Melihakbulut221/neuromorphic-space-soc/docs/51-npu-integration.md

# 51 — Connecting the NPU: the die has a serial port, so the SoC drives one

`docs/39-soc-bus-and-memory-map.md` section 9 item 4 is one line long:

> **No NPU connection.** The 256 MiB window is frozen and reaches the
> error slave.

Every document since has repeated it. Until this one the repository held
a RISC-V SoC and a separate neuromorphic accelerator that had never been
in the same simulation, and the word "neuromorphic" in its name was a
statement about two directories rather than about a part.

**This document is that connection, and it is built the hard way.**
`hw/rtl/pilot_top.v` — the TTIHP26b submission, frozen by blob hash in
`docs/34-pilot-freeze.md`, unmodified — is INSTANTIATED in `soc_top.v`
and reached over the same four serial pins the die will have. A program
on Ibex, out of the boot ROM, over the real fabric, configures it, loads
its weights, feeds it an event stream and reads the spikes back, and the
result is checked against `sw/golden/lif_core.py` rather than against
what the hardware produced. **27 checks, fail mask 0, 213,971 cycles.**

Convention, as elsewhere: **[fact]** = measured in this environment or
read out of a file; **[estimate]** = derived or judged; **[planned]** =
an intention with nothing behind it yet.

**The pilot is untouched.** `docs/34` pins the submission by blob hash
and the shuttle closes 2026-09-21. Nothing in `hw/rtl/`, `hw/tb/`,
`tt/`, `formal/` or `hw/openlane/` was modified; seven files in
`hw/rtl/` are **read and instantiated** and
`sw/tests/test_soc_npu_guards.py` fails if any of them has been touched.
Section 16 lists every file.

---

## 1. Verdict first

| Question | Answer |
|---|---|
| Is the 256 MiB window reached? | **Yes.** Fabric port 5, sixteen 4 KiB per-node register windows in its low 64 KiB, and everything else in it is a bus error that the program tests **[fact]**. Section 6 |
| Serial master, or a parallel port on a copy of the pilot? | **The serial master, and the argument is not "purity".** Section 3 |
| Is the frozen pilot instantiated or copied? | **Instantiated**, out of `hw/rtl/`. There is no copy anywhere under `hw/soc/` and a test says so **[fact]** |
| Does an inference run end to end? | **Yes, and it matches the golden model event for event and neuron for neuron.** 22 events in, 12 out, six spikes and six barrier echoes, all in stream order, plus the whole neuron state file **[fact]**. Section 7 |
| Where does the answer come from? | `sw/golden/lif_core.py`, at BUILD time, into a header the ROM image carries. The program never asks the hardware what the answer is. Section 7.1 |
| What does a register access cost? | **176 clock cycles**, measured, of which 171 is the serial frame **[fact]**. Section 8 |
| What does the whole program cost? | **185,443 → 213,971 cycles, +28,528, +15.4 %** — of which about **13,840 is console output** and the rest is the work **[fact for the counts, estimate for the split]**. Section 8.3 |
| What does the interrupt cost? | **Nothing that was spare.** `docs/40` assigned NPUCFG source 24 on fast line 12 before this block existed; lines 13 and 14 are still unassigned and a test derives that **[fact]**. Section 9 |
| Is it verified? | cocotb: **21 tests on `soc_npu` with the frozen pilot inside it, 21 pass**, with **14 mutations, of which four survived and one of those was a real gap** **[fact]**. Formal: **4 tasks on the transport, all PASS, 5 of 5 covers reached**, and **the fabric's own proof extended to six ports, 17 of 17 covers** **[fact]**. Section 10 |
| Is any of it hardened? | **The queues are, because they are `aer_fifo`. Nothing else is.** Section 14 |
| Is a descriptor ring built? | **No, and section 12 prices it rather than deferring it.** |

---

## 2. What was built

| File | What it is |
|---|---|
| `hw/soc/rtl/soc_npu_ser.v` | The serial host master. A transport and nothing else: one 40-bit mode-0 frame per register transaction, honouring the die's three host obligations by construction |
| `hw/soc/rtl/soc_npu.v` | The NPU subsystem. Two bus faces — the node register window on the system bus, the event port on the peripheral bus — an AER event engine between them, and the frozen `pilot_top` instantiated inside |
| `hw/soc/rtl/soc_npu_regs.vh` | Generated. The node register map for the SoC, from the same `regmap/regmap.yaml` that produces the die's own header |
| `hw/soc/rtl/soc_bus.v` | Extended from five slave ports to six |
| `hw/soc/formal/soc_bus_props.v` | The same extension, in the proof. Section 10.2 |
| `hw/soc/rtl/soc_top.v` | The subsystem, the sixth port, the NPUCFG slot decode, the interrupt line, and the die's pins brought out for observation |
| `hw/soc/flow/gen_npu_vectors.py` | The golden model's answer, computed at build time into two headers the program compiles against |
| `hw/soc/tb/sw/soc_npucfg.h` | The NPUCFG block's own register map, hand-written, as `soc_timers.h` is for the GPTIMER |
| `hw/soc/tb/sw/test_ibex.c` | Five new checks, 23 to 27 |
| `hw/soc/tb/sw/crt0.S` | A vector stub for interrupt id 28, fast line 12 |
| `hw/soc/tb/cocotb/test_soc_npu.py` | 21 tests, with the frozen pilot in the design under test |
| `hw/soc/formal/soc_npu_ser_props.v`, `.sby` | The serial protocol and its three host obligations, proved |
| `sw/tests/test_soc_npu_guards.py` | 15 textual guards, including that `hw/rtl/` is unmodified |

---

## 3. The connection decision, which is what this document is really about

### 3.1 The options, stated fairly

The pilot exposes exactly two interfaces. A **serial host port** —
`ser_sck`, `ser_cs_n`, `ser_mosi`, `ser_miso` — through which its whole
register bank is reached, and a **parallel 4-bit AER port** for events.
The host port is serial because it was designed against a Tiny Tapeout
pin budget. Inside an SoC there is no pin budget.

**(a) Drive the serial port from hardware.** A memory-mapped serial
master shifting frames into the frozen pilot exactly as external silicon
would. Preserves `pilot_top` bit-exactly. Costs latency and a shift
engine.

**(b) Add a parallel register port to a copy of the pilot under
`hw/soc/`.** Faster and cleaner, and the copy diverges from the design
being fabricated.

**(c) Something else.**

### 3.2 The usual argument for (a), and why it is not enough alone

The obvious case is: **the shuttle silicon will have the serial port and
nothing else.** If a TTIHP26b die arrives in 2027 and the SoC was built
against a parallel port that does not exist in it, the SoC cannot be
validated against the only real hardware this project will ever have.

**That argument is weaker than it first looks and it should be attacked
before it is used.** The SoC is not on the same die as the pilot and
never will be — the pilot is twelve Tiny Tapeout tiles, the SoC is a
different part on a different schedule. So "validate the SoC against the
die" cannot mean putting the die inside the SoC. It means running the
SoC's *driver* against the die over a bench harness, and a bench harness
needs a serial host of its own whether or not the SoC contains one. On
that reading, option (b) costs nothing: build the SoC against a parallel
port, and write a separate serial host for the bench.

**Three things defeat that reading, and only the third is decisive.**

**First, (b) needs a second copy of a frozen file, and this repository
has been bitten by second copies six times.** `docs/28` section 4.4a,
`docs/23`, `docs/34` section 8.5, `docs/36`, and `docs/38` sections 8.2
and 7.4 are all the same defect in different clothes: something was
checked, and the thing checked was not the thing that shipped. A copy of
`pilot_top.v` with a parallel port added would be verified, hardened and
measured, and every one of those results would be about a module that is
not the submission. The freeze exists precisely to make that impossible,
and `docs/34` section 9's rule is that changing a pinned file costs a
re-harden.

**Second, the parallel port is not a small change to that copy.** The
die's read side effects are timed to the serial frame: `pilot_top.v`
section 2 states that a read captures the addressed register when the
COMMAND BYTE completes, so `EVQ_OUT`'s pop happens once, early, at that
capture. A parallel port has no command byte and no frame, so the pop
would have to be re-timed — and `EVQ_OUT` is the register whose pop
semantics `docs/50` section 5.1 spends four pages on. Adding a parallel
port means re-deciding, and re-verifying, the part of the register bank
that is hardest to get right.

**Third, and this is the one that decides it: with (a) there is only
one host implementation, and it is the SoC's.** The bench harness for
the die is not a second thing to write — it is `soc_npu_ser.v` and the
driver above it, pointed at a socket instead of at an instance. The
three host obligations `pilot_top.v` numbers H1, H2 and H3 are
implemented once and proved once (section 10.2). With (b) they would be
implemented twice, and the copy that is *not* in the SoC is the copy
nobody runs a regression against — so it is the copy that would still
have the half-period-gap defect the pilot's own bring-up found.

> **THE DECIDING QUESTION IS NOT "CAN THE SoC TALK TO THE DIE". IT IS
> "HOW MANY IMPLEMENTATIONS OF THE DIE'S HOST PROTOCOL EXIST, AND WHICH
> OF THEM IS REGRESSED".** Option (a) answers one, and it is the one in
> the SoC's own test suite. That is a stronger reason than the shuttle
> argument, and it survives the attack the shuttle argument does not.

### 3.3 What was actually built is (c), and the difference matters

Option (a) as stated would be "a serial master, memory-mapped". What is
built is one level up from that:

> **THE SoC-SIDE INTERFACE IS THE MEMORY MAP, AND THE TRANSPORT IS
> UNDERNEATH IT.** `SOC_NPU_BASE + node*0x1000 + offset` behaves exactly
> like the `docs/10` section 10 register block, reached with ordinary
> loads and stores. Software does not know a serial port exists. A
> future node with a native 32-bit configuration bus — which is what
> `docs/10` section 1 specifies and what a full-scale node will have —
> is a change of transport under an unchanged address, an unchanged
> driver and an unchanged test suite.

The difference between (a) and (c) is one sentence in the RTL and the
whole of the software interface. It is the answer to the second question
this work had to decide, which is section 5.

### 3.4 What (a) costs, stated rather than waved at

**176 clock cycles per register access** **[fact, section 8]**. At the
pilot's scale that is a few dozen accesses per pass and it does not
matter. At full scale — 16,384 weight words, `docs/10` section 5 — it
would be 32,768 register writes and 5.8 million cycles, which is
absurd. **That is not an argument against the serial transport; it is an
argument the specification already makes.** `docs/10` section 9 puts
weight loading on a QSPI DMA path for exactly this reason, and section
14 item 4 lists it as the v0.2 work. The serial transport is the right
transport for configuration and the wrong one for bulk, and configuration
is what it carries.

---

## 4. The die's two ports are not symmetric, and the pin contract says so

The second question the brief posed is whether register access and event
flow are the same problem. They are not, and **the pilot's own pinout
already separates them** — `pilot_top.v` section 1 gives the event path
its own pins. So the SoC uses both, at the rate each was designed for.

What is worth recording is that the parallel port is **lossy in one
direction and impossible in the other**, and both facts come from the pin
contract rather than from anything in this work:

**Inbound, SYNC has no pin.** The event word the die builds from its
input pins is `{AER_IN_TICK ? 2'b01 : 2'b00, ...}`. Its TYPE field is 00
or 01 and never 10. **SYNC — the frame barrier that `docs/10` section
7.1 makes the determinism and multi-pass handshake primitive — cannot be
injected over the pins at all.** It goes over the serial `EVQ_IN`
register instead, at 176 cycles once per frame rather than per event.

**Outbound, there is no TYPE.** `AER_OUT_ID` is four bits and
`pilot_top.v` section 1 says what they are: "the low four bits of its ID
field". **A SYNC echo and a spike from neuron 0 are the same four bits.**
Reading the output pins would silently conflate the barrier with a
spike, which is the one event in the stream whose identity the sequencer
depends on. So `AER_OUT_VLD` is used as a NOTIFICATION and the word is
read from the die's `EVQ_OUT` register, which the same section says "is
always available over the serial EVQ_OUT register".

`aer_out_ack` is therefore **tied low and never used**: the serial read
is itself the pop, and two pop paths into the die's one-entry show-ahead
register would be two ways to lose the same event.

> **THE CONSEQUENCE IS AN ASYMMETRY OF ABOUT 44x AND IT IS THE TILE'S
> PIN BUDGET SHOWING THROUGH, NOT A DESIGN CHOICE.** An inbound SPIKE or
> TICK costs **4 clock cycles** on the pins; an outbound event costs a
> **176-cycle** frame **[fact]**. A full-scale node's mesh link
> (`docs/10` section 8 item 2, a 24-bit word with valid/ready) is
> symmetric and has neither problem, which is why the SoC-side event
> interface below is shaped like the mesh link and not like these pins.

---

## 5. Is this connecting to the pilot, or designing for a full-scale NPU?

**The second, and the frozen map's own author is the evidence.**
`regmap/memmap.yaml` reserves **256 MiB** at `0x10000000` and describes
it as "per-node register windows and descriptor rings", and separately
reserves a 4 KiB peripheral slot called NPUCFG for "NPU fabric-level
global configuration and status". A single pilot needs neither: one
4 KiB page would hold its whole register bank. Somebody who intended a
mesh wrote that map, and `docs/08` section 3.1 is where they wrote it.

So the CPU-side interface is designed for the mesh and the pilot is its
first and smallest instance:

| What the SoC presents | Why it is that shape | The pilot's part in it |
|---|---|---|
| One 4 KiB register window per node at `NODE_ID * 0x1000`, sixteen of them | `docs/10` section 8 item 5 freezes "one identical regmap instance per node at a per-node base address"; item 2 makes NODE_ID four bits | One node at index 0; the other fifteen are decoded and fault |
| A 16-bit event stream in each direction, valid/ready, `docs/10` section 7.1 words | Item 1 freezes the event word and item 3 freezes the handshake. This is the mesh link minus its 8-bit routing prefix, which item 2 says is tied off in single-node builds | Carried by a hybrid of the die's pins and its serial port, section 4 |
| One interrupt with a cause register | A cause register scales to sixteen nodes on one wire; a wire per node does not | Five of the seven cause bits come off the die's fault pins |
| The rest of the 256 MiB reserved and faulting | Descriptor rings live there and are not built, section 12 | — |

**What this costs.** The window decodes sixteen node slots when one
exists, which is four comparator bits that do nothing today, and the
event port carries a 16-bit word where four would do. Both are
unmeasurable next to the queues (section 11). **What it buys** is that
the second node is a parameter and a wiring change rather than a
redesign of the software interface — which is the whole content of
`docs/02` section 4 point 2's "one node of a mesh from day one".

---

## 6. The memory map, and what "reserved" now means inside it

Nothing in `regmap/memmap.yaml` moved. Two fields changed: the NPU
region gained `port: npu` and both it and the NPUCFG slot were promoted
from `reserved` to `implemented` **[fact, the diff]**.

```
0x10000000 + node*0x1000 + offset    node `node`'s docs/10 section 10
                                     register block, offsets 0x000..0x1FC
0x10000000 .. 0x1000FFFF             sixteen such windows; nodes at or
                                     above N_NODES are a bus error
0x10010000 .. 0x1FFFFFFF             reserved. Descriptor rings would
                                     live here. Bus error.
0xFF919000                           NPUCFG, the fabric controller and
                                     the event port
```

Three decode rules, and each of them faults rather than aliasing:

- `addr[27:16] != 0` — above the node windows, including the whole
  descriptor-ring area;
- `node >= N_NODES` — a node that is not instantiated;
- `addr[11:9] != 0` — above `0x1FC`, which is where the die's own
  seven-bit register address runs out;
- **a sub-word write.** The serial frame is 32 bits and carries no byte
  enable. A slave that accepted a byte store would have to widen it,
  writing three bytes of a register the master never named. It faults,
  and check 25 of the bring-up program requires `mcause = 7` for it.

**Check 25 tests all five**, and the cocotb suite tests seven addresses
plus four byte-enable patterns plus three misalignments **[fact]**. A
window that decoded everything to node 0 would pass every other NPU
check in this repository and fail that one.

---

## 7. The demonstration

### 7.1 The answer is computed before the hardware is asked

`hw/soc/flow/gen_npu_vectors.py` runs on **every** build of the ROM
image, before the compiler. It builds the weight matrix, runs
`sw/golden/lif_core.py` — which `docs/10` section 13 makes the normative
executable form of the section 4 equations — over the stimulus, and
emits two headers:

- `npu_regs.h`, the node register map in C, from `regmap/regmap.yaml`,
  so no offset of that map is written by hand anywhere in the program;
- `npu_vectors.h`, the stimulus and **the expected output stream**.

The program compares against those constants. **It never asks the
hardware what the answer is**, which is the difference between a check
and a tautology.

The configuration and the stimulus are `hw/tb/test_pilot_top.py`'s,
deliberately unchanged — same `LIFConfig`, same frames, same weight seed
— so the SoC's run and the pilot's own run are the same inference on the
same numbers, and a disagreement between them is attributable.

### 7.2 What the program does

```
  ok   test 0x00000017      NPUCFG answers; its reserved offsets fault
  ok   test 0x00000018      the node window IS docs/10 section 10
  ok   test 0x00000019      reserved addresses in the window are faults
npu: 0x0000000c events, cnt=0x000c0016 status=0x0000002a
  ok   test 0x0000001a      the inference, against sw/golden
  ok   test 0x0000001b      the interrupt, on the map's own fast line
checks run: 0x0000001b  fail mask: 0x00000000
RESULT PASS
[TB] core asleep after 213971 cycles
[TB] console: 760 characters decoded, 0 framing errors
```

**[fact, `hw/soc/out/sim-soc/sim.log`]**

Check 26 is the one the block exists for. In order: state clear and wait
for BUSY to drop; write eight configuration registers and **read one
back**, because a configuration write that was refused is otherwise
invisible until the arithmetic comes out wrong and then it looks like an
arithmetic defect; load four ECC-checked weight words through
`W_DATA_LO`/`W_DATA_HI`; check `CNT_SEC` and `CNT_DED` are zero, because
a clean image must not produce an ECC event; enable. Then six frames,
each injected as its spikes, a TICK and a SYNC, and read back until that
frame's barrier returns.

**What is in the loop:** Ibex, the boot ROM, the system fabric, the APB
bridge, the peripheral slot decode, the serial transport, the frozen
die's register bank, its ECC-checked weight loader, its LIF datapath,
its event queues, the parallel AER pins inbound and the serial `EVQ_OUT`
register outbound, and the SoC's own two queues.

**What is checked:** the output stream, event for event and in stream
order — six spikes and six barrier echoes, twelve words; then **the
whole neuron state file**, `V` and `R` for all eight neurons, which is
strictly stronger than the spike stream because it catches an error that
happened to cancel; then that nothing was lost — the die's
`CNT_EVQ_OVF` and `CNT_AXON_OOR`, the SoC's injection-drop counter, and
the interrupt cause's fault bits, all zero; and finally that the
hardware's OWN count of events delivered and drained (22 and 12) agrees
with the stream the program collected, which is a second path to the
same conclusion.

### 7.3 The barrier is what makes the stream self-delimiting

The read loop has **no timing knowledge at all**. It reads until the
SYNC it injected comes back, and `docs/10` section 7.1 is why that is
legitimate: a consumed SYNC means every prior event is fully processed
and the barrier is echoed downstream. The die echoes the consumed word,
so the barrier carries its own frame number and the program can label
frames without counting spikes.

> **THIS IS THE RETURN ON PAYING 176 CYCLES TO INJECT A SYNC OVER THE
> SERIAL PORT.** The pins cannot carry the barrier in either direction
> (section 4). Without it the program would have to know how many spikes
> each frame produces — which is the answer it is trying to check — or
> wait a fixed time, which is a test that passes for the wrong reason on
> a slow day.

---

## 8. What it costs, measured

### 8.1 One register access

**176 clock cycles**, from the cycle `req` is asserted to the cycle
`rvalid` returns **[fact, `hw/soc/tb/cocotb/test_soc_npu.py::test_the_frame_costs_what_the_protocol_says_it_costs`,
and independently in a standalone Icarus run]**. Of that, **171** is the
serial frame itself and the rest is the slave's own sequencing.

The protocol's floor is arithmetic on `pilot_top.v` section 2: 40 SCK
cycles plus one period of select setup (H2) plus one of inter-frame gap
(H3), at `SER_HALF` clock cycles per half period, is
`(40 + 1 + 1) * 2 * 2 = 168` cycles. The test asserts the measurement
lies between that floor and the floor plus 24, so the number in this
document is an observation and not a design intent.

### 8.2 The grant discipline, and the fabric consequence nobody had met

The node window **accepts one request at a time and withholds `gnt`
otherwise**, which is `soc_bus.v` rule S4 and is exactly what
`soc_apb_bridge.v` already does. The difference is the duration: three
cycles there, 176 here.

> **AND THAT MAKES A PROPERTY OF THE FABRIC VISIBLE FOR THE FIRST TIME.**
> `soc_bus.v`'s round-robin arbiter picks a winner BEFORE it looks at the
> target's grant. Its no-starvation property F9 has "every slave ready"
> in its antecedent for exactly this reason — `docs/39` section 8 defect
> 3 records the counterexample that put it there. So while one master is
> being refused by a slow slave, **the other master is not granted
> either.**

In this SoC that costs nothing measurable, and the reason is a property
of the CORE rather than of this block: Ibex is a two-stage machine with
no cache, so **a load stalls the pipeline until its data returns**
(`docs/50` section 5.2 measures 0.9714 cycles of execution per cycle of
RAM latency), and no second request to this window is ever issued while
the first is in flight. `md_req_i` is low for the whole frame and the
instruction port fetches normally.

**"Cannot happen because of the master we happen to have" is not a
property of a slave** — that is `docs/39` section 8 defect 4 in one line
— so it is reported here as a measurement of this SoC and not as a
property of the fabric. A future master that pipelines accesses into
this window would pay it, and the fix would be to buffer up to
`2*MAX_OUT` requests in the slave rather than to change the arbiter.

### 8.3 The whole program

| `hw/soc/flow/sim_soc.sh`, whole SoC | `docs/50` baseline | with the NPU |
|---|---:|---:|
| checks run | 0x16 (22) | **0x1B (27)** |
| fail mask | 0 | **0** |
| watchdog stage 1 (NMI) at cycle | 174,128 | **174,208** |
| **core asleep after** | **185,443** | **213,971** |
| console characters decoded | 587 | **760** |
| framing errors | 0 | **0** |
| watchdog stage1 / stage2 / stage3 | 1 / 0 / 0 | **1 / 0 / 0** |

**[fact, `hw/soc/out/sim-soc/sim.log`]**

**+28,528 cycles, +15.38 %.** Two things are worth separating out of
that number.

**THE BLOCK IS FREE UNTIL SOFTWARE TOUCHES IT, AND THAT WAS MEASURED
BEFORE THE CHECKS WERE WRITTEN.** With `soc_npu` instantiated, the sixth
fabric port decoded and the interrupt wired, and with the program
unchanged, the run was **185,443 cycles — identical to `docs/50`'s, to
the cycle** **[fact]**. The interrupt mask resets to zero and both event
engines reset disabled, so nothing the block does is visible until a
register is written. That is the same discipline `docs/41` records for
BUSSTAT and the reason `soc_top.v` could grow a block without moving the
invariant.

**ABOUT HALF THE DELTA IS THE CONSOLE.** The program prints 173 more
characters and `soc_uart.v` has one holding register, so at 80 clocks
per character that is **13,840 cycles [estimate, a measured character
count times a measured bit period]**, leaving about **14,700** for the
work: roughly 50 node-window accesses at 176, 18 engine frames at 172,
16 pin events at 4, and the CPU's polling in between.

**The new invariant is 213,971** and every hardening document after this
one should use it. The `docs/38` minimal-system run is unchanged at
131,718 cycles **[fact]**, because nothing in this work is on that
platform.

---

## 9. The interrupt, and what one fast line actually cost

`docs/40` section 3.3 decided against a PLIC on the strength of headroom:
Ibex's fifteen fast local interrupts cover thirteen sources with two
spare. Spending one here would be a real decision against that budget.

**It does not spend one.** NPUCFG was one of the thirteen sources that
document assigned — source number 24, fast line 12, `mcause 0x8000001C`,
vector `mtvec+0x70` — before this block existed. This work moves that
slot from `reserved` to `implemented`. **Lines 13 and 14 are still
unassigned**, and `test_soc_npu_guards.py` derives the spare set from the
generated map rather than asserting it **[fact]**.

**One line is enough for any number of nodes**, because the cause
register and not the wire says what happened:

| Bit | Meaning | Kind |
|---|---|---|
| 0 EVT | the capture queue is not empty | **level** |
| 1 ERR | the die's ERR pin | **level** |
| 2 SEC | the die's SEC pin, sticky at the die | **level** |
| 3 DED | the die's DED pin, sticky at the die | **level** |
| 4 TMR | the die's TMR pin, sticky at the die | **level** |
| 5 INJ_OVF | an `EVQ_IN` write was refused by a full queue | **sticky, W1C** |
| 6 FETCH_ER | an injection-queue fetch expired | **sticky, W1C** |

**The mix of levels and stickies is a decision and not untidiness, and
`docs/50` section 5.1 is the precedent.** A level has state behind it,
so the way to clear it is to fix the state — drain the queue, write the
die's `FAULT_CLR`. A refused write has no state behind it: it is an
event, and an event that is not latched is an event nobody can observe.
Writing 1 to a level bit is accepted and does nothing, and
`test_evt_is_a_level_and_says_so` asserts exactly that, because the
opposite convention is the easy mistake and it produces a driver that
loses events.

**Five of the seven bits come off the die's pins**, not off a polled
register. `pilot_top.v` section 1's four fault pins exist so "every
hardening event is visible on a scope with no host software"; inside an
SoC they are visible with no 176-cycle frame either. That is the
`docs/08` section 2.3 fault-visibility convention paying for itself in a
place it was not designed for.

**Check 27 takes the interrupt**, on line 12, at its own vector, and
checks the marker and `mcause` separately — `docs/40` section 6.1's rule
that reading `mcause` alone proves nothing about vectoring. It then
checks that the event is still in the queue, because the handler masked
the line rather than consuming anything, and that draining the queue
clears the level. That last assertion is the whole claim about what kind
of bit EVT is.

---

## 10. Verification

### 10.1 cocotb

| Suite | Tests | Result |
|---|---:|---|
| `test_soc_npu` | **21** | **21 pass** **[fact]** |

**The device under test contains the frozen pilot.** Every register value
in that suite travels a real 40-bit serial frame into `hw/rtl/pilot_top.v`
and back, and every event travels either the parallel AER pins or that
same frame. It is not a model of the die.

No expectation is read out of `soc_npu.v` except the port names. Node
register offsets, reset values and field positions come from
`sw/golden/regmap_gen.py`; the region base comes from
`sw/golden/memmap_gen.py`; the slave contract is `soc_bus.v`'s S1-S4,
quoted in the docstrings that test it; the frame format and the host
obligations are `pilot_top.v` section 2; and the inference answer is
`sw/golden/lif_core.py`.

`test_every_reset_value_survives_the_transport` walks the whole map — 26
registers — because a frame that was one bit short, one bit long, sampled
on the wrong edge, or misaligned by a deselect the die never saw would
corrupt SOME of them and not others. Two registers are excluded and the
reasons are normative rather than convenient: `CFG_NEUR` and `CFG_AXON`
report the elaborated geometry under `pilot_top.v` deviation D2, and
`N_DATA` has no reset value at all because `docs/10` section 3 says the
neuron state memory is UNDEFINED after reset.

**Mutation evidence, and four of the fourteen were not caught.**
Fourteen mutations against scratch copies; the Makefile exposes
`SOC_NPU_SRC` and `SOC_NPU_SER_SRC` for exactly this.

| Mutation | Result |
|---|---|
| `SER_MISO` sampled at the first cycle of the high half | caught, 8 tests |
| the frame is 39 bits | caught, 10 tests |
| a sub-word write is widened instead of refused | caught, `test_a_partial_write_is_refused` |
| every node index decodes to node 0 | caught, `test_reserved_addresses_in_the_window_are_bus_errors` |
| offsets above the die's 7-bit map are accepted | caught, the same test |
| a SYNC is strobed onto the AER pins | caught, 6 tests |
| a refused `EVQ_IN` write is not recorded | caught, 2 tests |
| the interrupt ignores the mask | caught, `test_the_line_is_the_cause_and_the_mask` |
| EVT is a sticky rather than a level | caught, 2 tests |
| `CTRL.FLUSH` also clears the sticky record | caught, `test_flush_empties_the_queues_and_keeps_the_record` |
| **the window grants while a frame is in flight** | **NOT caught — a real gap, now closed. Section 10.1a** |
| **the inter-frame gap H3 is dropped** | **not caught by the suite; caught by the induction proof** |
| **the select setup H2 is shortened** | **not caught by anything, and it is not a violation** |
| **a drained word is captured without checking VALID** | **not caught; the condition is unreachable in this SoC** |

**[fact, section 17 reproduces it]**

#### 10.1a The gap, which is the most useful result in this section

`gnt_o = req_i` — a window that grants a second request while the first
is unanswered — **passed all 21 tests.** A grant the fabric records owes
an `rvalid` the slave never sends, which underflows `soc_bus.v`'s
per-slave ownership queue; it is one of the worse things a slave can do.

The reason it survived is a defect in the test, not in the suite's
coverage: `test_gnt_is_withheld_while_a_frame_is_in_flight` **dropped
the request as soon as it saw the grant**, so it never presented the
slave with the opportunity to misbehave.

Rewriting it took two attempts, and the second one is the interesting
part. Holding the request high and requiring **one grant** fails on the
CORRECT design, because a grant and an `rvalid` may legitimately
coincide — they belong to different transactions, and
`soc_apb_bridge.v`'s header already says so of itself. **The property is
an OUTSTANDING COUNT and not a grant count**: grants minus responses
must never exceed one. Stated that way it passes on the design and
reports **523 outstanding** on the mutation.

> **A TEST THAT NAMES THE PROPERTY IT CHECKS AND DOES NOT SET IT UP IS
> WORSE THAN NO TEST**, because the name is read as coverage. This is the
> twelfth entry for `docs/41` section 6.6's list and the first in this
> work.

#### 10.1b The three that were not gaps

**H3 is caught by the proof and not by the simulation, and the depths
say why.** The bounded check runs to depth 30 and one frame is 171
cycles, so **no bounded check that finishes in reasonable time reaches a
second frame** — and H3 is entirely about the gap between two. The
k-induction proof has no such limit and fails on the mutation at the
`g_h3` clause. That is the division of labour the two tools are for, and
it is worth recording that the simulation could not have found it: with
`SER_HALF = 2` the shortened gap still leaves three cycles of deselect,
and the die needs one.

**The H2 mutation is not a violation.** Shortening the SETUP state from
two half periods to one still leaves five cycles between the select
falling and the first sampled clock edge, because **the first bit's own
low half supplies the rest of the setup**. The obligation `pilot_top.v`
section 2 states is about the interval, not about a state, and the
property is written over the interval — so both designs meet it and
neither tool should flag it. A mutation that changes no observable
behaviour is a statement about the design, and it is recorded rather
than quietly dropped.

**The VALID check on a drained word guards a condition this SoC cannot
produce.** The drain engine only starts when `AER_OUT_VLD` is high, and
nothing in this SoC pops the die's holding register behind its back —
`aer_out_ack` is tied low. The check is there because
`regmap/regmap.yaml`'s `EVQ_OUT` contract permits a read with VALID
clear, and the module's comment says so. **It is unreachable, so it is
uncovered, and calling that a coverage hole would be wrong** — it would
be a hole if `aer_out_ack` were ever connected.
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
