Melihakbulut221/neuromorphic-space-soc/thesis/figures/floorplan_macros.png

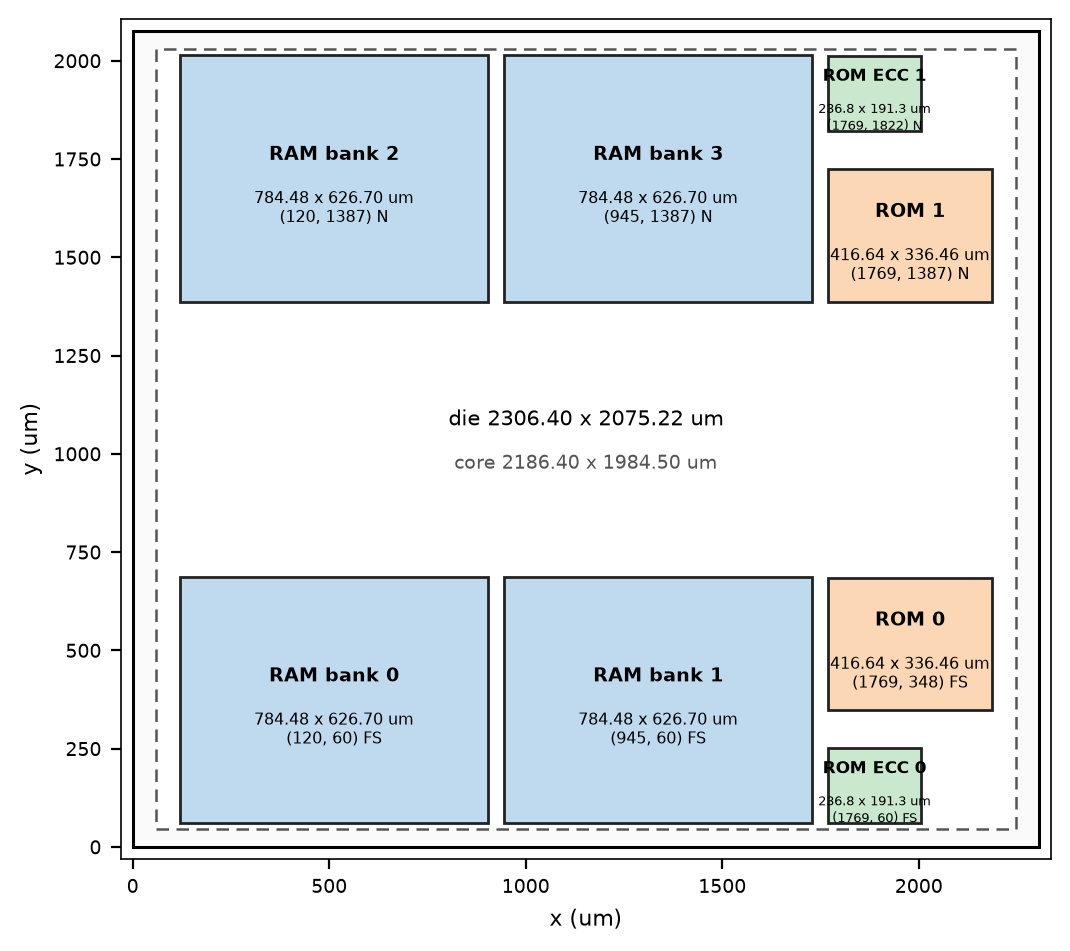
thesis/figures/floorplan_macros.png
