Melihakbulut221/neuromorphic-space-soc/thesis/figures/layout_blocks.png

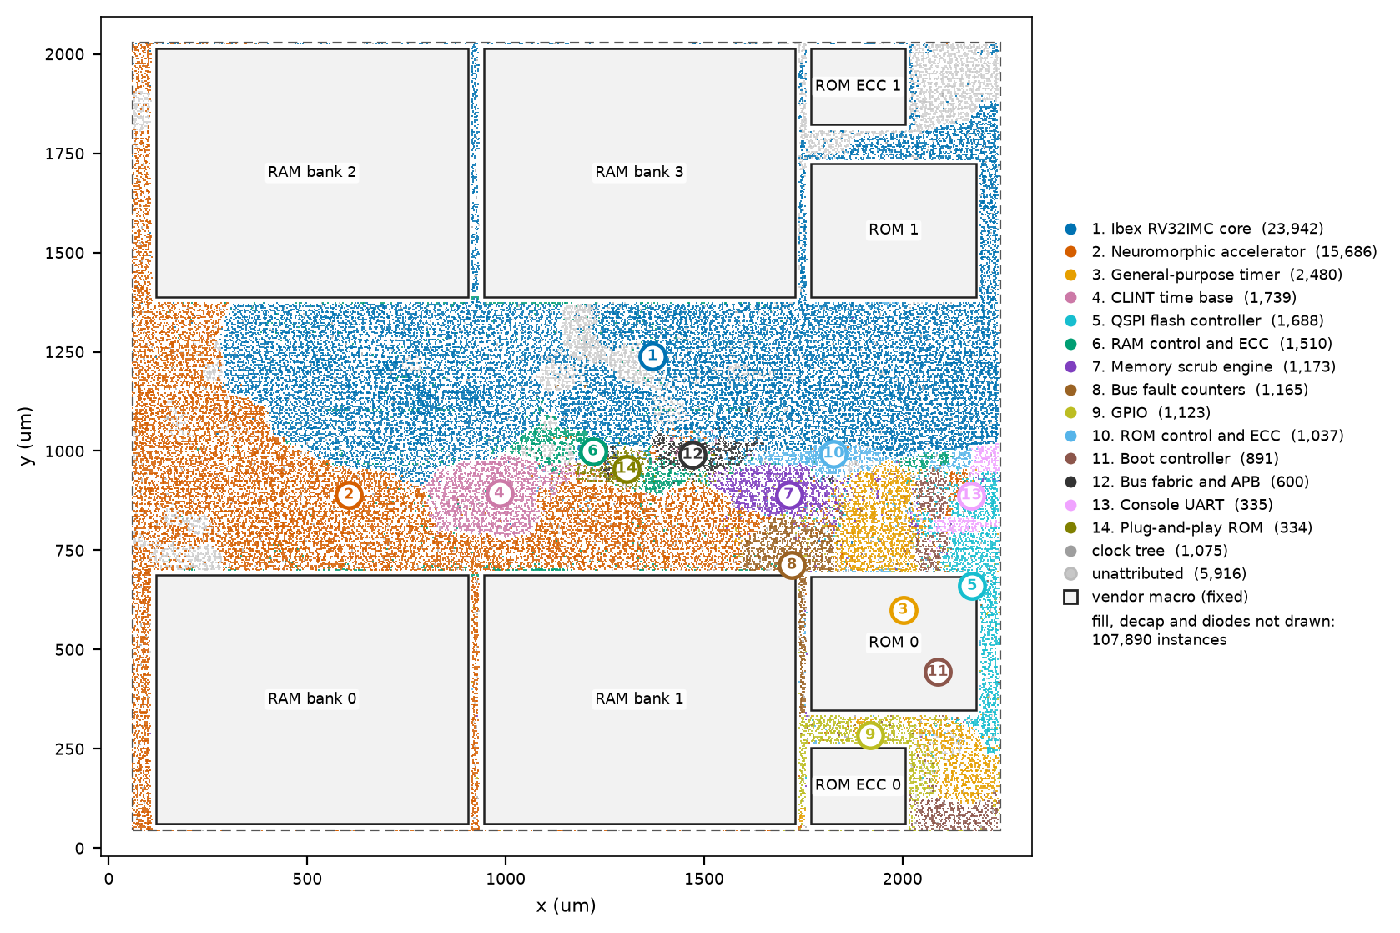
thesis/figures/layout_blocks.png
