Melihakbulut221/neuromorphic-space-soc/thesis/figures/layout_density.png

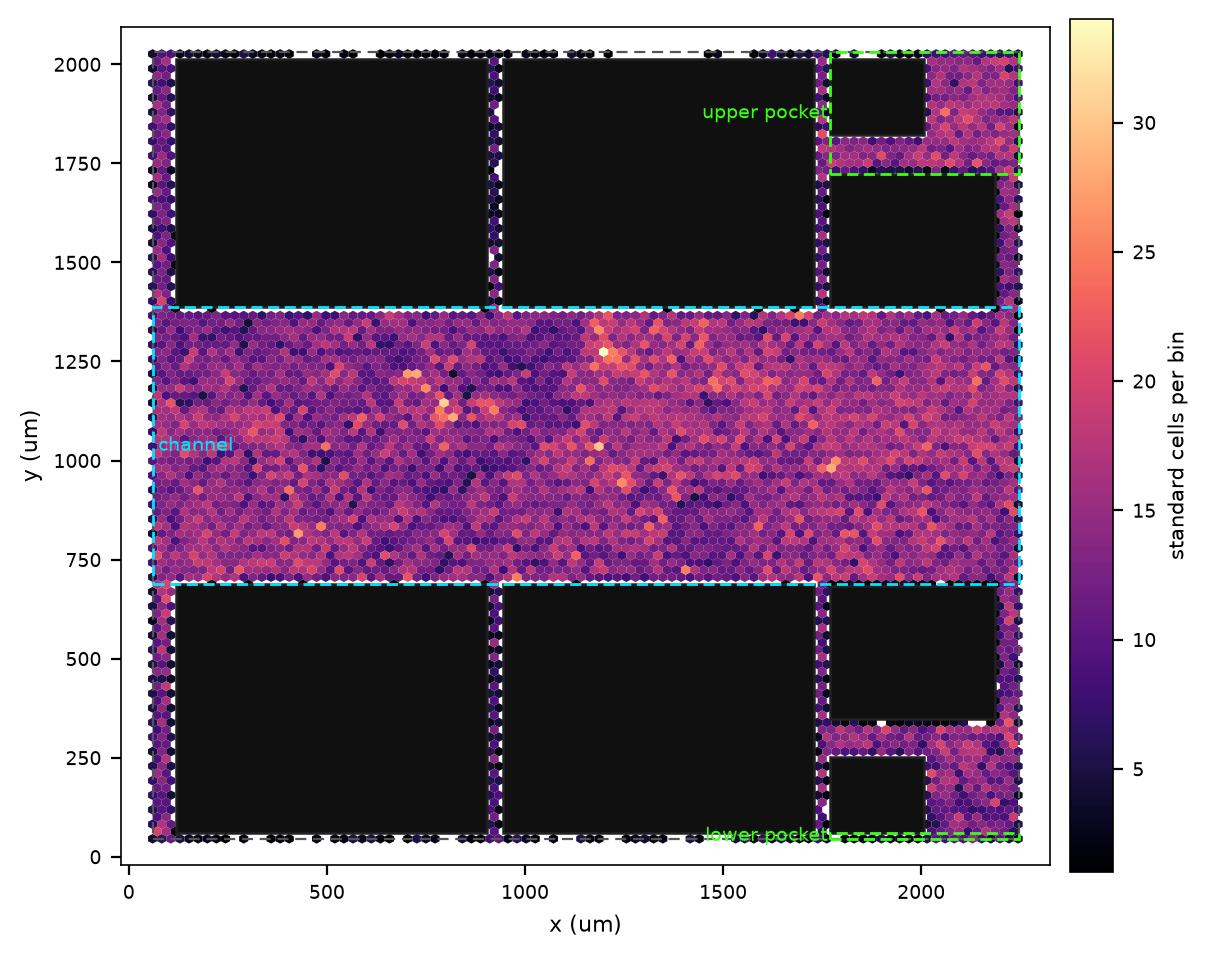
thesis/figures/layout_density.png
