Melihakbulut221/neuromorphic-space-soc/thesis/figures/layout_ibex_npu.png

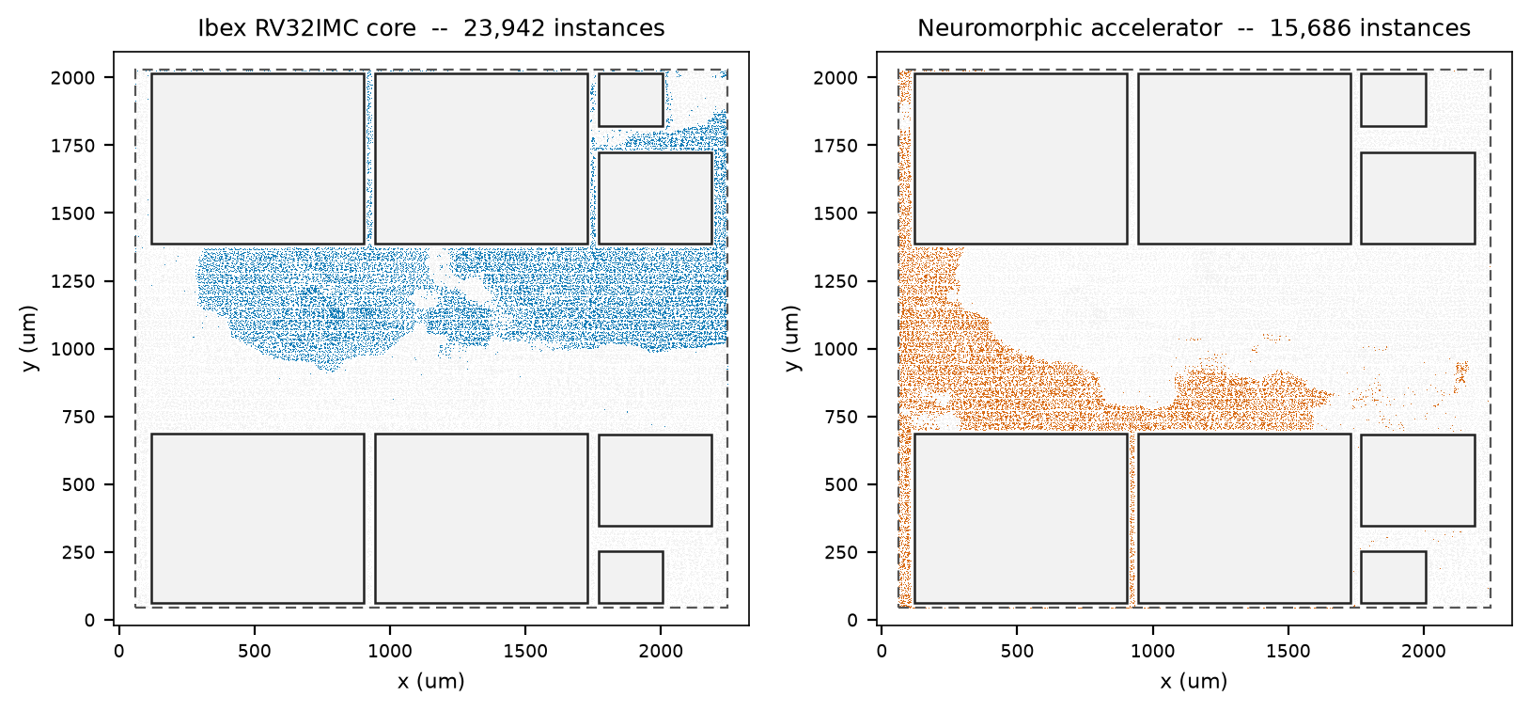
thesis/figures/layout_ibex_npu.png
