Melihakbulut221/neuromorphic-space-soc/thesis/figures/layout_panels.png

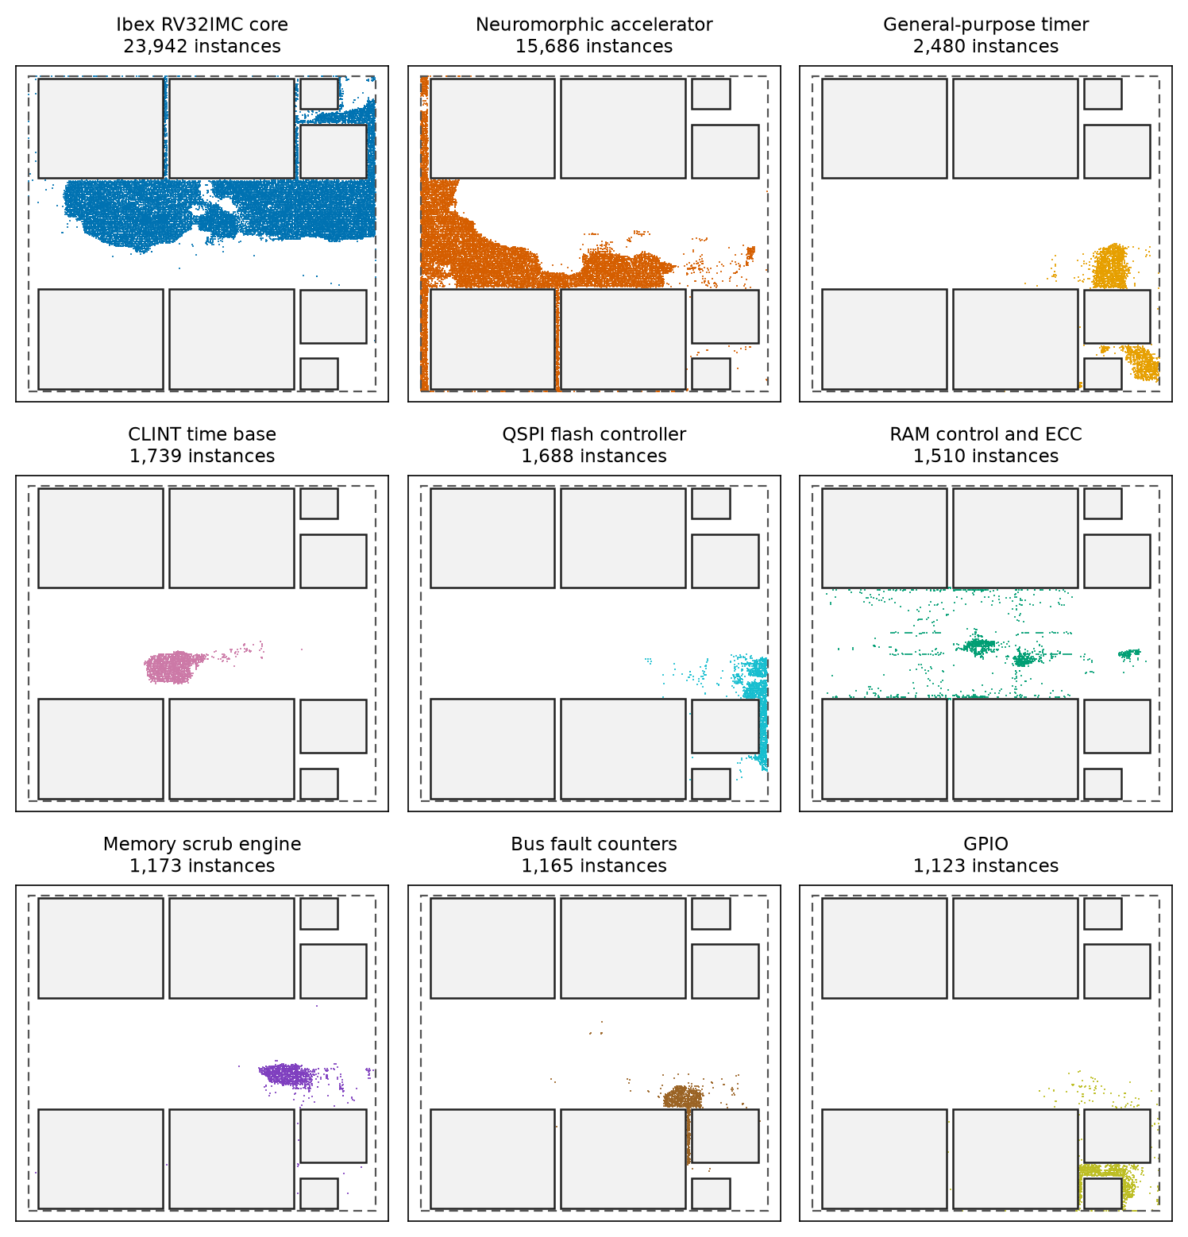
thesis/figures/layout_panels.png
