Melihakbulut221/neuromorphic-space-soc/thesis/figures/layout_regions.png

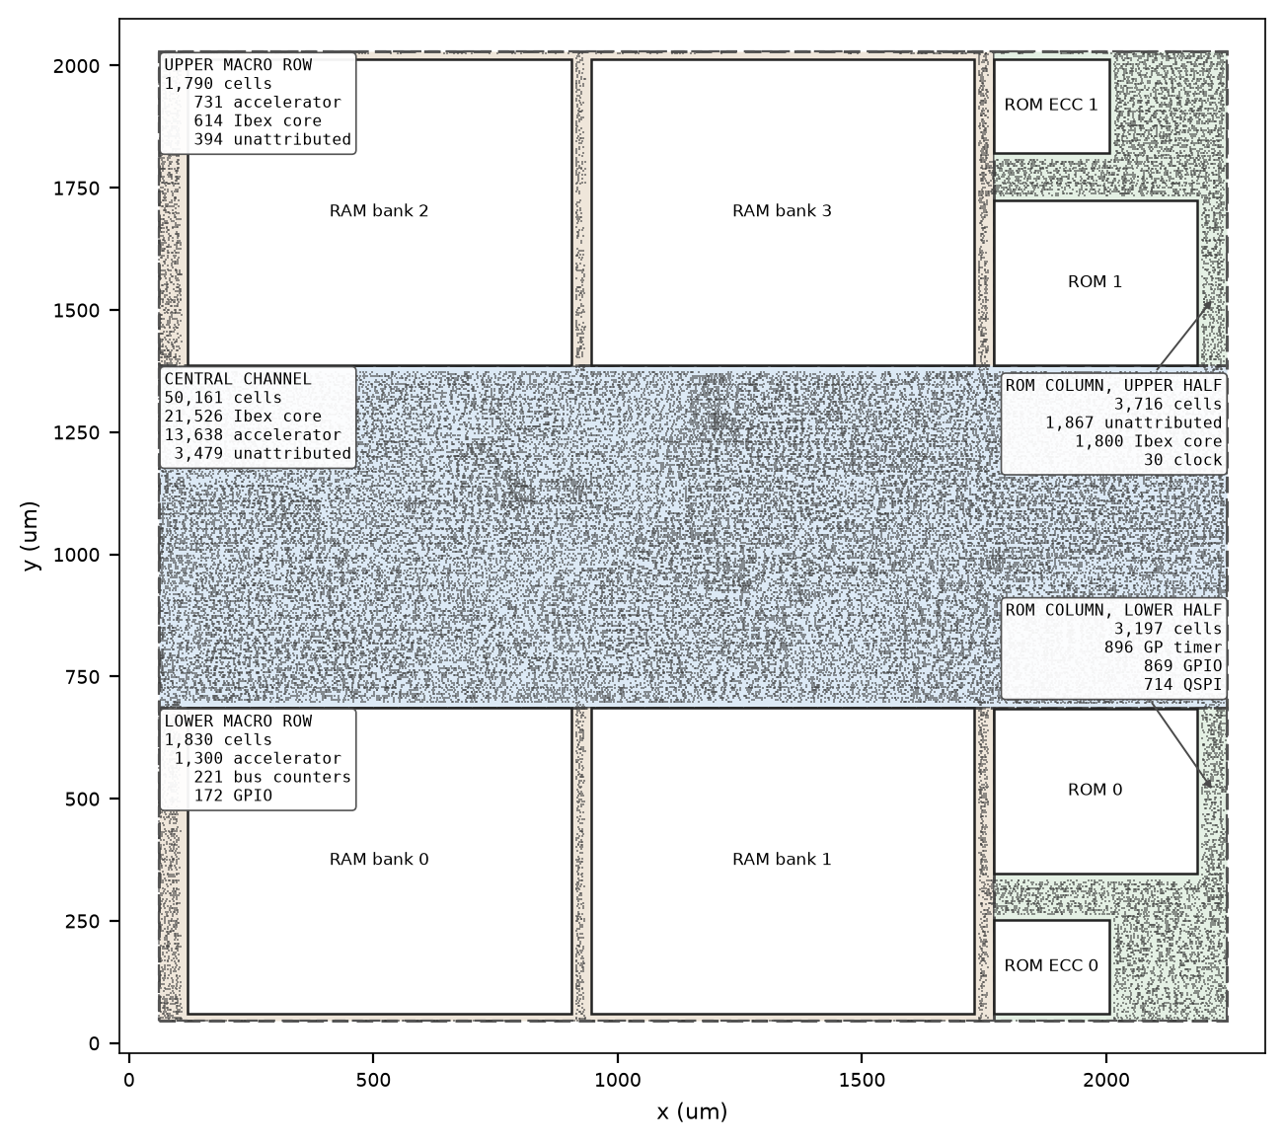
thesis/figures/layout_regions.png
