Melihakbulut221/neuromorphic-space-soc/docs/12-sg13g2-flow-bringup.md

# SG13G2 flow bring-up, `aer_fifo` trial harden, and the RM_IHPSG13 decision

Evidence file for ROADMAP gate **G0** ("sg13g2 trial harden DRC/LVS clean")
and for the **2026-09-07** internal go/no-go on the RM_IHPSG13 SRAM macro
(ROADMAP work item 2, budgeted in docs/06 section B.6.1). It answers three
questions:

1. Does an IHP SG13G2 RTL-to-GDS flow run to signoff in this rootless
   environment, and against which pinned tool and PDK versions?
2. What does a real block (`hw/rtl/aer_fifo.v`) cost on SG13G2, and does
   it close DRC, LVS and antenna?
3. Can an RM_IHPSG13 SRAM macro be hardened in the same flow, inside the
   Tiny Tapeout block geometry the pilot would use?

Convention used throughout: **[fact]** = measured in this environment or
read out of the installed PDK; **[estimate]** = derived or judged.
Sections 2-7 are measured unless a paragraph is marked otherwise.

**Headline, 2026-08-25.**

- **G0 is met.** `aer_fifo` hardened end to end on SG13G2: Magic DRC 0,
  KLayout DRC 0, Netgen LVS 0 errors on every count, XOR 0, antenna 0,
  timing clean on all three corners. Run `g0gates2`, 80 stages, 11.6
  minutes of tool time, on the RTL as it stands, with **17 of 19
  in-flow checkers gating fully** and setup, hold, max-slew and max-cap
  each measured at three corners and 0 at all of them. Section 4.
  **[fact, 2026-09-11]**
  - *The headline dated 2026-08-25 named run `trial-03-signoff` and 11.3
    minutes. That run stands as measured and is section 4.7a. It
    hardened the block BEFORE the queue pointers were replicated, and
    three of its four corner checkers were bound to no corner or to one
    of three -- so it is a true measurement of a design this repository
    no longer contains, made by a flow that would not have stopped had
    the numbers been bad. Section 4's preamble says how both were
    found.*
- **The RM_IHPSG13 macro run was made, and it splits cleanly in two.**
  One `RM_IHPSG13_1P_512x32_c2_bm_bist` in a registered wrapper, placed
  inside an 854.40 x 340.20 um die — the *interpolated* 4x2 Tiny Tapeout
  block this document used to print; the measured 4x2 block is
  854.40 x 313.74 um and 8.4 % smaller (6.5):
  - **Physical implementation passes.** Detailed routing into the
    macro's 188 bottom-edge Metal2 pins closed with 0 DRC errors and 0
    antenna violations, and timing closed at 50 MHz with 13.07 ns
    slow-corner slack. The pin-access failure this document previously
    predicted as most likely did not happen. Two flow-side integration
    defects did and both were worked around in
    `hw/openlane/sram_pilot/`: LibreLane's default macro PDN grid never
    reaches the macro's Metal4 supply pins, and Magic GDS streamout
    aborts because the macro GDS carries no prBoundary layer.
    Sections 7.2-7.4. **[fact]**
  - **Signoff fails.** Magic DRC **1,106,478 error boxes** (the report
    prints "Should be divided by 3 or 4" beneath that total, so roughly
    277,000-369,000 distinct violations **[estimate]**) and KLayout DRC
    **2,316** errors, **100 % of both inside the macro** and none in the
    surrounding design; Netgen LVS **359** errors, driven by the
    CDL-versus-GDS hierarchy naming and by a bus-delimiter mismatch
    (`A_DIN[16]` extracted versus `A_DIN<16>` in the CDL). Section 7.5.
    **[fact]**
- **Recommendation: NO-GO on RM_IHPSG13 for TTIHP26b, decidable now
  rather than on 2026-09-07.** The gate as docs/06 B.6.1 worded it is
  already answered, under conditions easier than it asks for, and both
  blocking causes are upstream of this repository. Separately, the macro
  named for that gate in docs/06 B.6 did not fit the block it was gated
  against; docs/06 has since been corrected on both counts. Sections 8
  and 10.1.

Run trees under `hw/openlane/*/runs/` are **gitignored** and do not
travel with the repository. Every number below is therefore quoted here
in full, with the run tag and step directory it came from, so this file
remains the evidence after the trees are deleted.

---

## 1. Scope

Design under test for the bring-up: `hw/rtl/aer_fifo.v` at `WIDTH=16`,
`DEPTH=64` — the EVQ geometry of docs/10 section 7.1. It was picked as
the bring-up vehicle because it is small enough to iterate on, it is
already verified (11 cocotb tests, four SymbiYosys proofs), and it is
memory-shaped: a 1024-bit storage array in flip-flops is exactly the
thing the SRAM-macro decision is about.

Design under test for the macro decision: `hw/openlane/sram_pilot/`, one
`RM_IHPSG13_1P_512x32_c2_bm_bist` in a registered wrapper and nothing
else, on the interpolated 4x2 die (6.5). It is flow-experiment scaffolding, deliberately kept out of
`hw/rtl/`; it is not part of any pilot submission.

Non-goals: this is not a timing exploration and not a Tiny Tapeout tile
submission. No ECC wrapper is built around the macro here — the decision
this document has to inform is whether the macro closes at all, and that
question is answered without one.

Everything this work *produced* lives in `hw/openlane/`, but the claim
an earlier revision made here — "nothing outside that directory and this
file was modified" — was not true, and the exceptions are load-bearing
rather than incidental:

- **`.gitignore`** gained `hw/openlane/runs/` and `hw/openlane/*/runs/`.
  Section 9's statement that run trees are gitignored is a statement
  about that file, not about this one; without the entry, a 1.6 GB tree
  of build output would be staged on the next `git add`.
- **`ROADMAP.md`** gate G0 carried a status note saying "no retained run
  has yet reached a DRC result and LVS has not executed". Section 4.1
  retired it; the integrator has since replaced it with the
  `trial-03-signoff` result and a pointer to this file. That change was
  requested in section 10.1 and has been made.
- **`docs/06-funding-and-shuttle.md`** sections B.6 and B.6.1 were
  rewritten in response to the errata this document raises in 6.5 and
  10.1 — the `1024x8` macro that does not fit, and the tile count.

Both `.gitignore` and `ROADMAP.md` are integrator-owned, so those two
edits were requested here and made there rather than made from this
workstream. The general rule this replaces the old sentence with: this
document owns `hw/openlane/` and itself, and every change it needs
elsewhere is named — here, in 10.1, or in both.

---

## 2. Toolchain

### 2.1 Rootless chain

No root, no container, no system package installation. Binaries are
user-local builds or extracted release tarballs; each is fronted by a
one-line shim in `~/.local/opt/llbin` that sets the environment that
binary — and only that binary — needs. The shims exist because the
OpenROAD build ships its own newer glibc: exporting its `LD_LIBRARY_PATH`
globally segfaults every other host binary. `hw/openlane/run_trial.sh`
therefore does `unset LD_LIBRARY_PATH` before dispatching and lets each
shim re-establish its own.

This chain is inherited, not invented here: it was built for
`tt-um-lif-crossbar` and has already carried a full SKY130 MVP to a
DRC/LVS/antenna-clean GDS in a sibling project on this machine. The
SG13G2 work in this document is the first use of it on a non-SKY130 PDK.

### 2.2 Pinned versions [fact]

Recorded 2026-08-25 in this environment.

| Component | Version | How it is reached |
|---|---|---|
| LibreLane | v3.0.5 | `~/Documents/caravel-lif-crossbar/.venv-flow/bin/librelane` |
| Ciel (PDK manager) | v2.6.1 | same venv |
| Python | 3.12.3 | same venv |
| OpenROAD | 26Q1-2938-g0e2d771c5e | shim -> ORFS install tree |
| Yosys | 0.67 (2d1509d1b) | shim -> oss-cad-suite |
| KLayout | 0.30.9 | shim (sets `RUBYLIB`, `KLAYOUT_PATH`) |
| Magic | 8.3.678 | shim -> `~/.local/opt/magic-8.3.678` |
| Netgen | 1.5.272 | shim |
| IHP-Open-PDK | `c4b8b4e5e7a05f375cca3815d51b3a37721fbf5c` | ciel, under `~/.ciel` |
| Standard-cell library | `sg13g2_stdcell` (84 Liberty cells) | in the PDK |

The Yosys build string is read from the synthesis report of
`trial-03-signoff` (`06-yosys-synthesis/reports/stat.json`), which is the
authority on what actually ran.

The PDK version is **not** chosen by us. Every LibreLane release ships
`librelane/pdk_hashes.yaml` naming the IHP-Open-PDK commit it was tested
against; for v3.0.5 that is `c4b8b4e5...`. `run_trial.sh` reads the pin
out of the installed wheel and refuses to run against anything else, so
the assertion stays correct across LibreLane upgrades instead of
hard-coding a hash that goes stale silently.

Answering the "which release or branch" question from the brief
directly: the supported 2026 path is **whatever commit the LibreLane
release pins**, consumed through ciel, not a Git tag of IHP-Open-PDK
chosen independently. ciel 2.6.1 carries `ihp-sg13g2` as a first-class
family (`ciel/families.py`), so `--pdk-family ihp-sg13g2` works the same
way `sky130` does. Volare is not involved; ciel is its successor and is
what LibreLane 3.x calls. **[fact]**

### 2.3 PDK install, outside the repository [fact]

```
export PDK_ROOT=$HOME/.ciel                 # NOT inside the repo
ciel ls-remote --pdk-family ihp-sg13g2      # list published versions
ciel enable --pdk-family ihp-sg13g2 c4b8b4e5e7a05f375cca3815d51b3a37721fbf5c
```

`ciel enable` downloads into
`$PDK_ROOT/ciel/ihp-sg13g2/versions/<hash>/` (787 MB) and repoints the
`$PDK_ROOT/ihp-sg13g2` symlink at it. Both the LibreLane ciel wrapper and
the PDK's own `config.tcl` files resolve through that symlink, so exactly
one version is live at a time.

Installed content:

```
~/.ciel/ihp-sg13g2/
  libs.ref/   sg13g2_stdcell  sg13g2_io  sg13g2_sram  sg13g2_pr
  libs.tech/  librelane  klayout  magic  netgen  openroad  ngspice  xschem  ...
```

### 2.4 Three traps

**(a) `--pdk` must be on the command line.** LibreLane's ciel wrapper
resolves and installs the PDK from the CLI option (default `sky130A`)
*before* the config file is parsed, then points `PDK_ROOT` at that
version's directory. With the default, `"PDK": "ihp-sg13g2"` in
`config.json` is then looked up inside the sky130 tree and the run dies
with "PDK not found". `run_trial.sh` always passes
`--pdk ihp-sg13g2 --scl sg13g2_stdcell`. **[fact]**

**(b) A stale enabled version does not announce itself.** This
environment had an older IHP-Open-PDK (`22f2a25f...`) enabled from an
earlier attempt while the LibreLane-pinned `c4b8b4e5...` sat downloaded
but not linked. Nothing in the flow would have complained; it would
simply have hardened against an untested PDK. Hence the assertion in
`run_trial.sh`:

```
$ PDK_ROOT=/nonexistent hw/openlane/run_trial.sh
PDK version mismatch.
  enabled: <none>
  pinned:  c4b8b4e5e7a05f375cca3815d51b3a37721fbf5c  (librelane v3.0.5)
Fix with: ciel enable --pdk-family ihp-sg13g2 c4b8b4e5e7a05f375cca3815d51b3a37721fbf5c
      or: ENABLE_PDK=1 hw/openlane/run_trial.sh
```

**(c) Config keys fail in three different ways, and only one of them is
visible where you would look for it.** This was probed directly with a
throwaway config carrying one deprecated key, one invented key, and the
PDK's own `MACRO_BLOCKAGES_LAYER`, run to `Verilator.Lint`.

- A **renamed** key is honoured and warns. `GRT_REPAIR_ANTENNAS`,
  carried over from the SKY130 config, is declared in
  `librelane/flows/classic.py` as
  `deprecated_names=["GRT_REPAIR_ANTENNAS"]` on the live variable
  `RUN_ANTENNA_REPAIR`. Setting `"GRT_REPAIR_ANTENNAS": false` produced
  `RUN_ANTENNA_REPAIR = False` in `resolved.json` — it changes
  behaviour — together with the console line "The configuration variable
  'GRT_REPAIR_ANTENNAS' is deprecated. Please check the docs for the
  usage on the replacement variable 'RUN_ANTENNA_REPAIR'." It is neither
  ignored nor silent. **[fact — measured]**
- An **unknown key in the user config** warns and is dropped:
  "An unknown key 'THIS_KEY_DOES_NOT_EXIST_ANYWHERE' was provided." It
  does not appear in `resolved.json`. **[fact — measured]**
- An **unknown key set by the PDK itself is silent everywhere.** The
  PDK's `libs.tech/librelane/config.tcl` sets
  `MACRO_BLOCKAGES_LAYER "Metal1 Metal2 Metal3 Metal4 Metal5 TopMetal1"`,
  and that string appears **nowhere in LibreLane 3.0.5** — zero hits
  across the installed package. It never reaches `resolved.json`, and
  neither `trial-03-signoff` nor `macro-03` logged a single "An unknown
  key" line: the warning path applies to the user config, not to values
  injected from the PDK Tcl. Anything a reader infers from its presence
  in the PDK config — for instance, that the PDN generator will keep off
  those layers over a macro — is not true of this tool version.
  Section 7.3 is what that costs in practice. **[fact — measured]**

Cutting across all three: **none of these warnings reaches
`warning.log`.** That file is written by the flow's step-warning
collector, which does not exist yet when the config is compiled. In every
probe run `warning.log` was **empty** while the console carried the
warnings. Reading `warning.log` after the fact is therefore *not* a way
to find a bad config key.

The working rule is therefore: after any config change, read
**`<run>/resolved.json`** — the fully resolved configuration, written
**once per run at the run root**. A key that is absent there had no
effect, whatever the PDK or an older OpenLane config suggests.

There is **no per-step `resolved.json`**, and an earlier revision of
this document sent the reader looking for one in both this section and
section 9. What a step directory holds is `config.json`, which is the
**subset** of the resolved configuration that that step consumes. On
`trial-03-signoff`: exactly one `resolved.json`, at the run root, with
**411 keys**; and **78** step `config.json` files carrying **79 to 123**
keys each **[fact — `find <run> -name config.json`]**.

Seventy-eight, not seventy-six, and the two figures are both real. The
run has **76 numbered step directories** (the count section 4 states and
`sw/tests/test_flow_evidence.py` holds), each with one `config.json`.
One of them, `42-openroad-repairantennas`, is a **composite** step that
nests its own sub-steps — `1-openroad-diodeinsertion` and
`2-openroad-checkantennas` — and each of those carries a `config.json`
of its own, with 107 and 91 keys. A recursive count therefore returns
78 while a directory listing returns 76. Anyone auditing a step count
has to say which of the two they mean; this document means the
directory count in section 4 and the file count here.

The subset difference is not academic either, because it is small enough
to give false negatives on the very keys this section is about:

| Key | In `<run>/resolved.json` | In a step `config.json` |
|---|---|---|
| `RUN_ANTENNA_REPAIR` | `true` | **in none of the 78** |
| `SYNTH_PARAMETERS` | `["WIDTH=16", "DEPTH=64"]` | only in `05-yosys-jsonheader` and `06-yosys-synthesis` |
| `CLOCK_PERIOD`, `FP_CORE_UTIL`, `PDK` | present | present in the steps that use them |

So the deprecated-name check in (a) above — "`GRT_REPAIR_ANTENNAS`
became `RUN_ANTENNA_REPAIR = False`" — is confirmable at the run root
and **nowhere else in the tree**. Looking for it per step would have
reported the key as absent and led to the opposite conclusion. Step
`config.json` is still useful, for the narrower question "which values
did *this* step actually see"; it is not the place to check whether a
key took effect at all.

---

## 3. Configuration

`hw/openlane/aer_fifo/config.json`, run by `hw/openlane/run_trial.sh`.
The rationale for each choice is carried inline in the config file as
`//`-prefixed comments so it travels with the settings; the load-bearing
ones:

- **`CLOCK_PERIOD: 30`** (33 MHz). Deliberately loose. The recorded
  lesson from the sibling SKY130 project is that an unreachable
  constraint manufactures thousands of phantom violations and buries the
  real integration failures underneath them. The experiment here is PDK
  and flow integration, not frequency. What the block *can* do is read
  off the achieved slack (section 4.4) rather than asserted up front.
- **`FP_SIZING: relative`, `FP_CORE_UTIL: 40`.** Let the flow pick the
  die and measure the achieved utilization; that number is what feeds the
  tile budget in docs/06 section B.6.
- **`SYNTH_PARAMETERS: WIDTH=16, DEPTH=64`.** These are the module
  defaults, pinned explicitly so the numbers below are a property of this
  config and not of the RTL header. They are **not** cosmetic: see
  section 4.7.
- **`RUN_HEURISTIC_DIODE_INSERTION: false`.** Measured decision, see
  section 4.5.

The macro run uses a second config, `hw/openlane/sram_pilot/config.json`,
described where its settings are earned in section 7.

---

## 4. Trial harden results — `aer_fifo` [fact]

All numbers in this section come from run tag **`g0gates2`**,
executed 2026-09-11, 00:27:07 to 00:38:44 local, from
`hw/openlane/aer_fifo/config.json` exactly as committed, via
`hw/openlane/run_trial.sh --design aer_fifo --run-tag g0gates2`. The
Classic flow reported **80 stages** and produced **76 numbered step directories**;
the four that did not run are gated off by default or by this config —
Repair Design (Post-Global Routing), Heuristic Diode Insertion (4.5),
Resizer Timing Optimizations (Post-Global Routing), and Equivalence
Check. Summed step runtime **697.8 s = 11.6 minutes** on 20
threads.

> **WHY THE RUN TAG MOVED, 2026-09-11.** This section named
> `trial-03-signoff` from 2026-08-25 until today, and that run's numbers
> are not withdrawn — they were measured, they were right, and
> `docs/64`'s rule keeps them. What changed is what they are numbers
> **of**, and it changed twice:
>
> 1. **The design moved out from under them.** On 2026-08-29, commit
>    `c5a5a6e` replicated the AER queue pointers. `trial-03-signoff`
>    hardened an `aer_fifo` with **1,071 flip-flops**; the block has
>    **1,164** now, and the 93 of difference are the replica banks the
>    whole hardening argument rests on. A sign-off run of a design
>    without its redundancy is not a sign-off of the design.
> 2. **Three of its gates were not gates.** `hw/openlane`'s audit found
>    `Checker.SetupViolations` matching one corner of three on that run
>    and `Checker.MaxCapViolations` and `Checker.MaxSlewViolations`
>    matching none at all — the `[""]` match-none default `docs/34`
>    section 8.5 measured. All three metrics read 0 at all three corners
>    there, so what was missing was the gate and not the result; but "it
>    read zero" and "it was checked" are different sentences and G0 was
>    quoting the second.
>
> No re-harden was possible in between, and that is the third finding:
> under the flatten this config used, yosys honours the twelve
> `keep_hierarchy` attributes the replication defence needs, nine
> `$paramod` submodule types survive, and LibreLane counts **every cell
> type whose name begins with `$`** as unmapped — so a parameterised
> user module is counted the same as a gate that failed to map. The run
> stopped at `Checker.YosysUnmappedCells` with *"9 Unmapped Yosys
> instances found"* and nothing was unmapped. `SYNTH_HIERARCHY_MODE:
> deferred_flatten` is the answer, and `hw/openlane/pilot_ihp`,
> `hw/openlane/pilot_sky130` and `tt/src` had all carried it since
> before the pointers were replicated. For thirteen days the block's own
> sign-off configuration could not build the block's own RTL, and
> nothing noticed because nothing re-ran it.
>
> `g0gates2` is the current RTL, hardened with all four corner checkers
> live: `hw/openlane/checker_audit.py` reports **17 of 19 in-flow
> checkers gating fully**, with setup, hold, max-slew and max-cap each
> **measured at 3 corners and 0 at all of them**. The two that do not
> gate are `Checker.LintWarnings` (1 warning, `ERROR_ON_LINTER_WARNINGS`
> is False by default) and `Checker.WireLength` (no threshold set, so it
> only warns).
>
> Section 4.7a below is `trial-03-signoff`'s record, kept.

### 4.1 Outcome

| Signoff check | Step | Result |
|---|---|---|
| Magic DRC | `64-magic-drc` | **0 errors** |
| KLayout DRC (deep, `no_recommended`) | `65-klayout-drc` | **0 errors** |
| Netgen LVS | `70-netgen-lvs` | **0** on all seven LVS counters |
| Magic illegal overlap | `69-checker-illegaloverlap` | 0 |
| KLayout XOR (Magic GDS vs KLayout GDS) | `62-klayout-xor` | 0 differences |
| Antenna, post-detailed-routing | `46-openroad-checkantennas-1` | 0 violating nets, 0 violating pins |
| Detailed-routing DRC | `44-openroad-detailedrouting` | 0 |
| Disconnected pins | `48-odb-reportdisconnectedpins` | 0 (0 critical) |
| Power-grid connectivity | `56-openroad-irdropreport` | 0 violations on VPWR and VGND |
| Setup / hold / max-slew / max-cap | `55-openroad-stapostpnr` | 0 violations, all three corners |

The seven Netgen counters are
`design__lvs_error__count`, `..._device_difference__count`,
`..._net_difference__count`, `..._property_fail__count`,
`..._unmatched_device__count`, `..._unmatched_net__count`,
`..._unmatched_pin__count`, all **0**, from
`final/metrics.json`. **This is the artifact ROADMAP G0 asks for.**

Every row above names the check it covers, and the last one names four
counters rather than saying "timing". That is deliberate: one violation
counter in the same `metrics.json` is **not** zero, and 4.4a says which
one, how many, and why the flow does not gate on it. This is a sign-off
table against the checks G0 names — not a claim that every counter
LibreLane emits reads zero.

### 4.2 Synthesis

From `06-yosys-synthesis/reports/stat.json`: **4,853 cells**, Yosys area
**99,688.012 um2**, of which sequential **57,022.963 um2**. Cell mix, the
part that matters:

| Cell | Count | Why |
|---|---|---|
| `sg13g2_dfrbpq_1` | 1,164 | 1,024 memory bits + 140 control/pointer bits, of which 93 are the three replicated pointer banks |
| `sg13g2_tiehi` | 1,088 | one per memory bit, purely to hold `RESET_B` inactive, plus 64 for the replica banks |
| `sg13g2_mux2_1` | 1,055 | read mux tree |
| `sg13g2_a22oi_1` | 495 | |
| `sg13g2_nand4_1` | 185 | |
| `sg13g2_nor3_1` | 79 | |
| others (21 types) | 787 | |

The 1,024 tie-high cells are not a synthesis mistake; they are what
SG13G2 costs for an unreset array. Section 5.

*`trial-03-signoff` measured 4,164 cells, 89,320.455 um2 and 1,071
flip-flops on the block before the queue pointers were replicated. The
+93 flip-flops are the replicas and the +689 cells are them plus the
voters; `hw/rtl/aer_fifo.v` argues for both.*

### 4.3 Floorplan and area

From `13-openroad-floorplan/or_metrics_out.json` and
`final/metrics.json`:

| Quantity | Value |
|---|---|
| Die bounding box | 0 0 **510.785 x 529.505** um |
| Die area | 270,463 um2 = **0.2705 mm2** |
| Core area | 249,081 um2 |
| Core bounding box (floorplan) | 5.76 15.12 504.96 **514.08** um |
| Placement utilization (target 40 %) | **40.03 %** |
| Utilization after fill insertion | 50.88 % |

The core margins are not free parameters: 5.76 um is 12 x the 0.48 um
`CoreSite` width, 15.12 um is 4 x the 3.78 um row height.

The core bounding box row is corrected in this revision. An earlier
revision printed `5.76 15.12 478.08 483.84`, which is
`trial-01`/`trial-02-nohdi`'s core box, inside a table whose header says
every number comes from `trial-03-signoff`. The two are not
interchangeable and the table contradicted itself: 472.32 x 468.72 =
221,386 um2, which is the superseded runs' core area, not the 223,171
um2 on the row above. `trial-03-signoff`'s box is 472.32 x 472.50 =
**223,171 um2**, which closes against its own core-area row exactly.
Both figures read from `13-openroad-floorplan/or_metrics_out.json` in
the respective run trees **[fact]**. Section 4.7 is the general form of
this trap: the run tag has to be stated, because "the same design" is
not the same netlist — and, as this row shows, not the same floorplan
either.

Instance counts through the flow: 4,853 after synthesis; **6,839
non-fill instances** in the final layout, after CTS and timing repair
have added to it; 20,392 instances in total once the 13,553 fill cells
are counted. Timing repair contributed **1,770 buffers**, of which 1,150
are hold buffers and **0 are setup buffers** — a direct consequence of
the loose clock. CTS added 137 clock buffers and 64 clock inverters.

### 4.4 Timing, all three corners

From `55-openroad-stapostpnr/summary.rpt`, post-layout, parasitics from
OpenRCX:

| Corner | Setup worst slack | Hold worst slack | Setup/hold/slew/cap violations |
|---|---|---|---|
| `nom_slow_1p08V_125C` | **11.0738 ns** | 0.7095 ns | 0 |
| `nom_typ_1p20V_25C` | 15.7496 ns | 0.3322 ns | 0 |
| `nom_fast_1p32V_m40C` | 17.1220 ns | **0.1295 ns** | 0 |

*`trial-03-signoff` read 18.0553 / 20.1784 / 21.4717 setup and 0.6397 /
0.3024 / 0.1130 hold, on the design before the queue pointers were
replicated. Those numbers stand where they were measured; the replicas
cost about 7 ns of setup slack at every corner, which is what triplicating
a pointer and voting it costs at 30 ns and is not a regression against
any constraint.*

The last column is named for exactly the four counters it covers —
`timing__setup_vio__count`, `timing__hold_vio__count`,
`design__max_slew_violation__count` and
`design__max_cap_violation__count`, per corner — because there is a
fifth violation counter in the same `metrics.json` and it is **not**
zero. An earlier revision headed that column bare "Violations", which
invited the reading "no violations of any kind". That reading is wrong,
and the correction is 4.4a below.

Setup TNS and hold TNS are 0 at every corner. Clock skew is 0.295-0.305
ns for setup and -0.296 to -0.304 ns for hold. 86 nets are unannotated by
the parasitics extractor, all of which the flow's own filter classifies
as expected (`timing__unannotated_net_filtered__count = 0`).

Read as frequency: at the slow corner the whole launch-to-capture path
consumes 30 - 11.0738 = **18.926 ns**, i.e. about **52.8 MHz**. That
still clears the 50 MHz Tiny Tapeout envelope of docs/06 B.2, and the
margin is **5.37 % on the 20 ns period** or **5.67 % on the 50 MHz
frequency** — both, because the two bases differ and the sentence this
replaces quoted one of them beside `trial-03-signoff`'s other. On the
same two bases the unreplicated block had **40.28 %** and **67.44 %**.
That is the honest cost of the pointer TMR at this clock, and it is thin
enough to be worth stating as a number rather than as "clears".

*Corrected 2026-09-12: this read "the margin is now 5.6 % rather than
the 40 % the unreplicated block had", which is 5.67 % (frequency) set
against 40.28 % (period). `docs/81` section 2.2 carries the same
correction and the table behind it.* **[estimate — this is a single-point extrapolation from a run
closed at 30 ns; re-closing at 12 ns would buffer differently and the
achieved number would move.]**

Note that `TIMING_VIOLATION_CORNERS` defaults to `*typ*` in this PDK
(section 5), so the slow and fast columns above are analysed but do not
by themselves gate the flow. They are reported here because for silicon
they should.

#### 4.4a Max-fanout: 101 violations, disclosed

`design__max_fanout_violation__count = 101`, and **101 at each of the
three corners individually** **[fact, 2026-09-11 — `g0gates2`'s
`final/metrics.json`, and the `report_check_types -max_fanout
-violators` block of `55-openroad-stapostpnr/<corner>/checks.rpt`]**.
The count is identical at all three corners because fanout is a
netlist-topology property; PVT does not move it.

What the 101 are, read off the violator list at the typical corner
**[fact]**: **98 clock-tree buffers** — `clkbuf_0_clk` and 97
`clkbuf_leaf_*` — and **three resizer-inserted fanout buffers**. **Not
one of them is an RTL net.** Every violator is a buffer this flow
inserted itself, in CTS and in design repair.

> *Corrected 2026-09-12.* This section read **90 violations, 89
> clock-tree buffers (`clkbuf_0_clk` at 16 loads and 88 `clkbuf_leaf_*`
> at 10 to 14) and one fanout buffer, `fanout278/X`, at 9** — and those
> are `trial-03-signoff`'s numbers, sitting inside a section whose own
> preamble says every number in it comes from `g0gates2`. When section 4
> moved run on 2026-09-11 the machine-checked tables moved with it and
> this one did not, because nothing checks it: `test_flow_evidence.py`
> holds the outcome table and the corner slacks against the run tree and
> has never parsed 4.4a. The old figures were right on their date and are
> `trial-03-signoff`'s record, kept here rather than deleted per
> `docs/64`.
>
> The shape of the finding is unchanged and that is the point of
> re-measuring rather than adjusting: it is still every violator a buffer
> the flow inserted, still not one RTL net, and still 11 more of them
> only because the design got bigger when the queue pointers were
> replicated.

That is also why raising `MAX_FANOUT_CONSTRAINT` would not change the
list. Every violating pin is reported against a limit of **8**, while
this run set `MAX_FANOUT_CONSTRAINT` to **10** **[fact —
`<run>/resolved.json`]**; the 8 is
`sg13g2_stdcell_typ_1p20V_25C.lib`'s `default_max_fanout : 8` **[fact —
line 36 of that library]**. The binding limit is the library's, the
design constraint is already looser than it, and loosening it further
would move nothing.

Why it is not gating, and this is a fact about the tool rather than a
judgement **[fact]**: the Classic flow instantiates checker steps for
setup (`72-checker-setupviolations`), hold
(`73-checker-holdviolations`), max slew (`74-checker-maxslewviolations`)
and max cap (`75-checker-maxcapviolations`), and **there is no
max-fanout checker step in the flow at all** — the step lists of
`trial-03-signoff` and of `g0gates2` both have none. `design__violations`, the flow's own
aggregate, is therefore `0` while `design__max_fanout_violation__count`
is 101, and the run completes. Nothing here is waived or suppressed by
this configuration.

What it would mean for silicon **[estimate]**: an overloaded clock-tree
buffer costs transition time and skew, and both are measured clean at
this design — max-slew and max-cap violations are 0 at all three
corners, clock skew stays inside +/-0.28 ns, and the worst setup slack
is 18 ns against a 30 ns period. So the fanout numbers are not hiding a
timing problem *in this run*. They are still worth carrying forward,
because the margin that absorbs them here comes from a 30 ns clock; a
design closed near its limit would not have it. ROADMAP G0 asks for
DRC/LVS/antenna/timing clean, which this run is on the counters G0
names; the fanout counter is disclosed here so that "no violations"
never has to be read as covering more than it does.

### 4.5 Antenna, and why heuristic diode insertion is off

This is the one place where the config makes a non-default choice, so it
carries the most evidence.

Sequence in `trial-03-signoff`, all with
`RUN_HEURISTIC_DIODE_INSERTION: false`:

| Step | Antenna-violating nets / pins |
|---|---|
| `40-openroad-checkantennas` (after global routing) | 10 / 10 |
| `42-openroad-repairantennas` (post-GRT repair, 0 diodes inserted) | 0 / 0 |
| `46-openroad-checkantennas-1` (**after detailed routing**) | **0 / 0** |

Detailed routing itself inserted **3 `sg13g2_antennanp` cells, 16.33
um2**, through `DRT_ANTENNA_REPAIR_ITERS` (3 iterations, default). The
post-global-routing `OpenROAD.RepairAntennas` step inserted **zero**
diodes; the repair that mattered was the router rerouting.

The comparison run `trial-01` used the same RTL with
`RUN_HEURISTIC_DIODE_INSERTION: true`. There,
`Odb.HeuristicDiodeInsertion` placed diodes ahead of routing and the
design finished with **4,641 `sg13g2_antennanp` cells, 25,261.9 um2 =
11.4 % of the 221,386 um2 core area**, to reach the same
zero-violating-nets result.

So: 3 diodes and 16.33 um2 with the heuristic off, 4,641 diodes and
25,261.9 um2 with it on, identical antenna outcome. Off is right for
this design. **[fact]**

Two honesty notes about this comparison. First, `trial-01` differs from
the committed config in more than the diode flag — see 4.7 — so the
4,641 figure is "the heuristic on this design", not a controlled A/B.
Second, an intermediate run `trial-02-nohdi` was made with the heuristic
off but was killed during detailed routing and never produced a
post-detailed-routing antenna number; it is retained only for the
global-routing row and is not the basis of any claim here.

### 4.6 Routing

From `44-openroad-detailedrouting` and `50-odb-reportwirelength`:

| Quantity | Value |
|---|---|
| Signal nets routed | 5,958 (+2 special) |
| DRC errors per DRT iteration | 58 -> 6 -> 3 -> 0 -> 0 |
| Final routed wirelength | 317,493 um |
| Global-route estimate | 412,106 um |
| Longest net | 1,295.77 um |
| Vias | 37,181, **all single-cut** |
| Detailed-routing runtime | 2 min 38 s |

The router emits `[DRT-0349] LEF58_ENCLOSURE with no CUTCLASS is not
supported. Skipping for layer ...` for Cont, Via1-Via4, TopVia1 and
TopVia2. This is a tech-LEF/tool-version gap, not a design problem, and
it is worth knowing about because it means those enclosure rules are
checked by the signoff DRC decks and not by the router. Both DRC decks
came back clean here, so nothing was actually missed on this design.

Power, from `55-openroad-stapostpnr` at the typical corner, 1.20 V,
33 MHz: total **4.159 mW** (internal 3.355, switching 0.796, leakage
0.0076). Worst IR drop 1.01 mV on VPWR (0.084 %) and 1.90 mV on VGND;
`VSRC_LOC_FILES` is unset, so these are indicative rather than signoff
numbers.

### 4.7 What the earlier runs prove, and what they do not

Four runs exist under `hw/openlane/aer_fifo/runs/`. Only one of them is
evidence for anything in this document, and saying why is the point of
this subsection.

| Run | Config actually used | Reached | Status |
|---|---|---|---|
| `trial-01` | `SYNTH_PARAMETERS` unset, `RUN_HEURISTIC_DIODE_INSERTION: true` | killed at `65-magic-drc`, log 0 bytes | superseded; cited only for the diode comparison in 4.5 |
| `trial-02-nohdi` | `SYNTH_PARAMETERS` unset, heuristic false | killed during `44-openroad-detailedrouting` | superseded; no signoff data |
| `trial-03-signoff` | the committed config, verbatim | all 80 stages | **the evidence** |
| `config-recheck` | the committed config after the comment edits | `--to Yosys.Synthesis` | reproducibility check, see below |

`resolved.json` in both `trial-01` and `trial-02-nohdi` records
`"SYNTH_PARAMETERS": null`. Neither of them ever executed the config that
`hw/openlane/aer_fifo/config.json` now contains, and `trial-01` used the
opposite value of the one flag the config argues about. Before
`trial-03-signoff`, the repository contained a configuration that had
never been run.

That is not only a bookkeeping point. `WIDTH=16, DEPTH=64` are the module
defaults, so pinning them should be a no-op — and it is not:

| | `trial-01` / `trial-02` (parameters unset) | `trial-03-signoff` (parameters pinned) |
|---|---|---|
| Cells after synthesis | 4,160 | **4,164** |
| Yosys area (um2) | 89,266.061 | **89,320.455** |
| `sg13g2_mux2_1` | 1,024 | 1,025 |

Four cells and 54 um2 of difference, from `chparam`-ing a parameter to
the value it already had. The lesson for anyone quoting numbers out of a
run tree: the run tag has to be stated, because "the same design" is not
the same netlist.

**Reproducibility check.** The `//`-prefixed comments in the config were
edited after `trial-03-signoff` finished, so a fourth run
(`config-recheck`, `--to Yosys.Synthesis`) was made from the file
exactly as it now stands. Its `resolved.json` is identical to
`trial-03-signoff`'s — no key added, none removed, no value changed,
including the run-directory paths — and synthesis reproduces 4,164 cells
at 89,320.455 um2. LibreLane drops `//`-prefixed keys without even the
"An unknown key was provided" warning it gives for a genuine typo
(2.4c), which is why the comments can be carried in the config at all.
The committed config is the config that produced section 4. **[fact]**

*The `config-recheck` run above, and the sentence about reproducing
4,164 cells, are `trial-03-signoff`'s. They were true of the config as it
stood on 2026-08-25 and are left as they were measured; the equivalent
statement for `g0gates2` is that its `resolved.json` is checked against
the committed config on every run of
`sw/tests/test_flow_evidence.py::test_committed_config_is_the_config_that_produced_the_evidence`,
with no declared exceptions.*

### 4.7a `trial-03-signoff`, kept

Section 4 named this run from 2026-08-25 to 2026-09-11. Its numbers are
not withdrawn and they are not corrections of anything — they are what
the flow measured, on the day, on the design as it then was.

| Quantity | `trial-03-signoff` (2026-08-25) | `g0gates2` (2026-09-11) |
|---|---:|---:|
| Flip-flops | 1,071 | **1,164** |
| Synthesis cells | 4,164 | 4,853 |
| Instances, final layout | 18,166 | 20,392 |
| Die area, um2 | 243,430 | 270,463 |
| Setup worst slack, slow corner | 18.0553 ns | 11.0738 ns |
| Hold worst slack, fast corner | 0.1130 ns | 0.1295 ns |
| Magic DRC / KLayout DRC / XOR / LVS | 0 / 0 / 0 / 0 | 0 / 0 / 0 / 0 |
| Setup / hold / max-slew / max-cap | 0, at 3 corners | 0, at 3 corners |
| ...checked at | **1 corner, 1 corner, 0, 0** | **3, 3, 3, 3** |
| In-flow checkers gating fully | not measured then | **17 of 19** |

Two things separate the columns and only one of them is the design.

**The design.** Commit `c5a5a6e`, 2026-08-29, replicated the AER queue
pointers. The 93 flip-flops of difference are the three banks, and the
hardening argument in `hw/rtl/aer_fifo.v` is about them. A sign-off of a
block without its redundancy is a sign-off of a different block.

*Corrected 2026-09-12: both places in this document named `b6738e5` and
dated it 2026-08-31, six days after the sign-off run. That is the pilot
FREEZE commit, which `docs/34` pins and which changed no logic. The
replication is `c5a5a6e`, 2026-08-29 -- four days after
`trial-03-signoff`, not six. Nothing else in this section moves: the
1,071, the 1,164 and the 93 were read off the two run trees and are
unaffected by which commit is named. The error was reading the commit
that FROZE the pilot as the commit that changed it.*

**The gates.** `hw/openlane/checker_audit.py` on `trial-03-signoff`'s run
tree calls `Checker.SetupViolations` PARTIAL — *"matches 1 of 3 measured
corners; unchecked: nom_fast_1p32V_m40C, nom_slow_1p08V_125C"* — and
`Checker.MaxCapViolations` and `Checker.MaxSlewViolations` NO-GATE,
because each declares `corner_override = [""]` in LibreLane's own
`checker.py`, the `[""]` is filtered to an empty list, and every
violation lands in a warning while the flow exits 0. All three metrics
read 0 at all three corners on that run, so **nothing was hidden**; what
was missing was any mechanism that would have stopped the run had
something been there. ROADMAP G0's sentence was quoting the gates.

The gap between them is the third finding, and it is the one worth
carrying forward: **for thirteen days no re-harden was possible at
all.** *(Thirteen, not eleven, corrected 2026-09-12: the window is `c5a5a6e` 2026-08-29 to `g0gates2` 2026-09-11. The old figure was computed from `b6738e5`, the pilot freeze commit these documents named by mistake.)*
Under the flatten this config used, yosys honours the twelve
`keep_hierarchy` attributes the replication defence depends on, nine
`$paramod` submodule types survive into `stat.json`, and
`librelane/steps/pyosys.py` counts *every cell type whose name begins
with `$`* as unmapped:

```python
safe = ["$assert"]
unmapped_cells = [cells[y] for y in cells.keys()
                  if y not in safe and y.startswith("$")]
```

A parameterised user module is counted the same as a `$_AND_` that
failed to map, so the flow stopped with *"9 Unmapped Yosys instances
found"* on a netlist in which every cell inside those nine is an sg13g2
cell. `SYNTH_HIERARCHY_MODE: deferred_flatten` synthesises
hierarchically and flattens after technology mapping, which is what
`hw/openlane/pilot_ihp`, `hw/openlane/pilot_sky130` and `tt/src` have
all done since before the pointers were replicated —
`pilot_sky130`'s own comment states this failure mode verbatim. This
config was the one that did not, and nothing noticed because nothing
re-ran it.

---

## 5. What `sg13g2_stdcell` is like, measured [fact]

docs/06 section B.7 item 3 asked for the cell-variant gap to be
quantified at the first harden. It is large:

| | `sg13g2_stdcell` | `sky130_fd_sc_hd` |
|---|---|---|
| Liberty cells | **84** | **428** |
| Distinct functions (drive suffix stripped) | 49 | — |
| Row height | 3.78 um (`CoreSite`, 0.48 um site width) | 2.72 um |
| Core voltage | 1.20 V | 1.80 V |
| Routing layers offered to the router | Metal2 .. TopMetal2 | met1 .. met5 |

Consequences seen in this run, not predicted:

- **There is no plain D flip-flop.** Every sequential cell in the
  library is a reset flop or a latch. The complete set is **14 cells —
  9 flip-flops and 5 latches** — enumerated by counting the Liberty
  `ff()` and `latch()` groups in
  `sg13g2_stdcell_typ_1p20V_25C.lib` **[fact]**:

  | Kind | Cells |
  |---|---|
  | flip-flop (`ff()`), 9 | `dfrbp_1/2`, `dfrbpq_1/2`, `sdfrbp_1/2`, `sdfrbpq_1/2`, `sdfbbp_1` |
  | latch (`latch()`), 5 | `dlhq_1`, `dlhr_1`, `dlhrq_1`, **`dllr_1`**, **`dllrq_1`** |

  An earlier revision listed twelve of these as if the list were
  complete and omitted `dllr_1` and `dllrq_1`. The omission is not
  cosmetic: those two are the **active-low-enable** latches. The three
  `dlh*` cells declare `enable : "GATE"` in their Liberty `latch()`
  group and the two `dll*` cells declare `enable : "GATE_N'"`
  **[fact — read from the `latch()` groups]**. So a latch-RAM strategy
  (docs/06 B.4 carries latch RAM as the fallback storage style, and
  section 6.2 below is the argument for why a flop array is expensive)
  that only knows about the `dlh*` half is working with three cells
  where the library offers five, and has no negative-phase latch for a
  two-phase array at all.

  Synthesis therefore mapped the 1,024 unreset FIFO memory
  bits to `sg13g2_dfrbpq_1` and had to tie each `RESET_B` high —
  **1,024 `sg13g2_tiehi` cells, 7,432 um2** (1,024 x 7.2576), purely to
  hold a reset pin inactive. Any block with a large unreset array pays
  this on SG13G2. **[fact]**
- **Drive strengths are sparse.** Most combinational functions exist
  only at `_1` and `_2`; buffers reach `_16`, inverters `_16`, but there
  is no `_4`/`_8` for the majority of gates. Resizer-based timing repair
  has correspondingly less to work with, which argues for the loose
  constraint of section 3 rather than against it. **[fact]**
- **No well-tap or end-cap cells exist**; the PDK config sets
  `FP_TAPCELL_DIST 0` and skips insertion. **[fact]**
- **`TIMING_VIOLATION_CORNERS` defaults to `*typ*`** in the PDK's SCL
  config, i.e. only the typical corner gates the flow's own checkers. The
  slow and fast corners are still *analysed* (section 4.4 reports all
  three), but a violation there would not by itself fail the flow. Worth
  overriding for anything going to silicon. **[fact]**

---

## 6. RM_IHPSG13 SRAM macro inventory — paper study

Everything in section 6 is read out of the installed PDK
(`c4b8b4e5...`). Section 7 is the run that tests it.

### 6.1 What ships [fact]

27 macros, all under `~/.ciel/ihp-sg13g2/libs.ref/sg13g2_sram/`.
Every one of the 27 has a complete view set: LEF, GDS, CDL, Verilog,
datasheet, and three Liberty corners (81 `.lib` files total). There are
no partial entries.

Areas are `W x H` from the LEF `SIZE` statement; `bit/um2` is
`words x bits / area`, recomputed for this revision.

| Macro | Words x bits | kbit | W x H (um) | Area (um2) | bit/um2 |
|---|---|---|---|---|---|
| `RM_IHPSG13_1P_256x8_c3_bm_bist` | 256 x 8 | 2 | 236.80 x 74.10 | 17,547 | 0.117 |
| `RM_IHPSG13_1P_256x16_c2_bm_bist` | 256 x 16 | 4 | 236.80 x 118.78 | 28,127 | 0.146 |
| `RM_IHPSG13_1P_512x8_c3_bm_bist` | 512 x 8 | 4 | 236.80 x 110.38 | 26,138 | 0.157 |
| `RM_IHPSG13_1P_64x64_c2_bm_bist` | 64 x 64 | 4 | 784.48 x 64.36 | 50,489 | 0.081 |
| `RM_IHPSG13_1P_1024x8_c2_bm_bist` | 1024 x 8 | 8 | 146.88 x 336.46 | 49,419 | 0.166 |
| `RM_IHPSG13_1P_256x32_c2_bm_bist` | 256 x 32 | 8 | 416.64 x 118.78 | 49,488 | 0.166 |
| `RM_IHPSG13_1P_512x16_c2_bm_bist` | 512 x 16 | 8 | 236.80 x 191.34 | 45,309 | 0.181 |
| `RM_IHPSG13_1P_256x48_c2_bm_bist` | 256 x 48 | 12 | 596.48 x 118.78 | 70,850 | 0.173 |
| `RM_IHPSG13_1P_1024x16_c2_bm_bist` | 1024 x 16 | 16 | 236.80 x 336.46 | 79,674 | 0.206 |
| `RM_IHPSG13_1P_256x64_c2_bm_bist` | 256 x 64 | 16 | 784.48 x 118.78 | 93,181 | 0.176 |
| `RM_IHPSG13_1P_512x32_c2_bm_bist` | 512 x 32 | 16 | 416.64 x 191.34 | 79,720 | 0.206 |
| `RM_IHPSG13_1P_1024x32_c2_bm_bist` | 1024 x 32 | 32 | 416.64 x 336.46 | 140,183 | 0.234 |
| `RM_IHPSG13_1P_4096x8_c3_bm_bist` | 4096 x 8 | 32 | 236.80 x 618.30 | 146,413 | 0.224 |
| `RM_IHPSG13_1P_512x64_c2_bm_bist` | 512 x 64 | 32 | 784.48 x 191.34 | 150,102 | 0.218 |
| `RM_IHPSG13_1P_1024x64_c2_bm_bist` | 1024 x 64 | 64 | 784.48 x 336.46 | 263,946 | 0.248 |
| `RM_IHPSG13_1P_4096x16_c3_bm_bist` | 4096 x 16 | 64 | 416.64 x 618.30 | 257,609 | 0.254 |
| `RM_IHPSG13_1P_2048x64_c2_bm_bist` | 2048 x 64 | 128 | 784.48 x 626.70 | 491,634 | 0.267 |
| `RM_IHPSG13_1P_8192x32_c4` | 8192 x 32 | 256 | 1520.16 x 618.30 | 939,915 | 0.279 |
| `RM_IHPSG13_2P_256x8_c2_bm_bist` | 256 x 8 | 2 | 278.51 x 136.97 | 38,148 | 0.054 |
| `RM_IHPSG13_2P_64x32_c2` | 64 x 32 | 2 | 702.83 x 74.87 | 52,621 | 0.039 |
| `RM_IHPSG13_2P_256x16_c2_bm_bist` | 256 x 16 | 4 | 419.95 x 136.97 | 57,521 | 0.071 |
| `RM_IHPSG13_2P_512x8_c2_bm_bist` | 512 x 8 | 4 | 261.17 x 219.77 | 57,397 | 0.071 |
| `RM_IHPSG13_2P_256x32_c2_bm_bist` | 256 x 32 | 8 | 702.83 x 136.97 | 96,267 | 0.085 |
| `RM_IHPSG13_2P_512x16_c2_bm_bist` | 512 x 16 | 8 | 402.61 x 219.77 | 88,482 | 0.093 |
| `RM_IHPSG13_2P_1024x16_c2_bm_bist` | 1024 x 16 | 16 | 402.61 x 385.37 | 155,154 | 0.106 |
| `RM_IHPSG13_2P_512x32_c2_bm_bist` | 512 x 32 | 16 | 685.49 x 219.77 | 150,650 | **0.109** |
| `RM_IHPSG13_2P_1024x32_c2_bm_bist` | 1024 x 32 | 32 | 685.49 x 385.37 | 264,167 | **0.124** |

(The two bold entries and the `1P_256x32` row are corrections to an
earlier revision of this table, which carried 0.106, 0.122 and 0.165.)

Naming: `RM_IHPSG13_<1P|2P>_<words>x<bits>_c<colmux>[_bm][_bist]`.
`_bm` = per-bit write mask (`A_BM`), `_bist` = a second BIST-side port
set (`A_BIST_*`) multiplexed onto the array by `A_BIST_EN`. 25 of the 27
carry both; `RM_IHPSG13_1P_8192x32_c4` and `RM_IHPSG13_2P_64x32_c2` have
neither and expose only the plain port. **[fact]**

Two-port macros cost roughly **2x the area per bit** of the equivalent
single-port part (e.g. 512x32: 150,650 um2 dual-port vs 79,720 um2
single-port). This matches the TT per-tile density note in docs/06
section B.4 and confirms it independently from the PDK rather than from
the TT documentation. **[fact]**

### 6.2 Density argument for the macro [fact]

The concrete reason to care, from this project's own numbers. `aer_fifo`
stores 1,024 bits. Synthesis spent, per stored bit, one
`sg13g2_dfrbpq_1` (48.9888 um2) + one `sg13g2_tiehi` (7.2576 um2) + one
`sg13g2_mux2_1` (18.144 um2) = **74.39 um2/bit**, i.e. **0.01344
bit/um2** — and that is before routing area, control logic, or
utilization derating.

| Storage style | bit/um2 | vs flop array |
|---|---|---|
| Flop array as synthesized here | 0.01344 | 1.0x |
| `RM_IHPSG13_1P_256x8_c3` (smallest macro) | 0.117 | **8.7x** |
| `RM_IHPSG13_1P_1024x16_c2` | 0.206 | **15.3x** |
| `RM_IHPSG13_1P_8192x32_c4` (largest) | 0.279 | **20.7x** |

So the macro is worth 9-20x in silicon area. Section 7 is about whether
the open-PDK views close DRC and LVS in this flow.

### 6.3 What LibreLane integration requires [fact]

The variable names below were read from LibreLane 3.0.5's step
definitions, not from documentation, and every one of them was
subsequently exercised by the run in section 7.

**Views.** A `MACROS` entry per instance, of the `librelane.config.Macro`
shape: `gds`, `lef`, `instances` (name + `location` + `orientation`),
`lib` (keyed by corner ID), plus optionally `nl`/`pnl`/`spef`/`spice`/`vh`.
All required files exist in the PDK for all 27 macros. In practice a
`vh` blackbox declaration is also needed, because `Verilator.Lint` runs
before synthesis and will fail on an undeclared module (section 7.1).

**Placement.** `MACRO_PLACEMENT_CFG` or the per-instance `location` in
the `MACROS` entry; `FP_MACRO_HORIZONTAL_HALO` /
`FP_MACRO_VERTICAL_HALO` (both default 10 um) to keep rows off the macro
edge; `GRT_MACRO_EXTENSION` (default 0) for routing-guide extension
around it. `FP_SIZING` must become `absolute` with an explicit
`DIE_AREA` — a relative-sized die does not reserve room for a fixed
block.

**Power.** `PDN_MACRO_CONNECTIONS` (list of
`<instance_rx> <vdd_net> <gnd_net> <vdd_pin> <gnd_pin>` strings) and
`PDN_CONNECT_MACROS_TO_GRID` (default true). Note the LibreLane 3.x
spelling: the variables are `PDN_*`, not the older `FP_PDN_*`. This is
**not** sufficient on its own for these macros; see 7.3.

**Timing.** `lib` views per corner in the `MACROS` entry;
`STA_MACRO_PRIORITIZE_NL` (default true) controls whether the
post-layout netlist or the Liberty is used; `RSZ_DONT_TOUCH_LIST` to
keep the resizer off the macro pins; `CTS_MACRO_CLUSTERING_*` if the
macro clock is part of the tree.

**Signoff.** `MAGIC_MACRO_STD_CELL_SOURCE` (default `macro`) selects
whether Magic reads the standard cells out of the macro GDS or the PDK;
the default does not work with these macros, see 7.4. LibreLane 3.0.5's
Classic flow signs off LVS with `Magic.SpiceExtraction` + `Netgen.LVS`
— not with the PDK's KLayout LVS deck, which is also shipped.
`EXTRA_SPICE_MODELS` is how the macro CDL reaches Netgen.
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
