Melihakbulut221/neuromorphic-space-soc/docs/62-synpre-remeasured.md

# 62 — `SYNPRE` on the path that binds, and the gain that was never there

`docs/61-soc-with-the-accelerator.md` section 18 item 2 asked for this
run and gave the reason in one sentence:

> **`docs/49` section 5 measured it worth +3.4641 ns at post-CTS and
> routing took all of it back; the question is whether that still happens
> when the path it fixes is the worst one.**

**This is that run, and the answer is that it does not happen, because
there is nothing to take back.** `SYNPRE` was built into the whole SoC —
Ibex, the fabric, the peripherals, the six RM_IHPSG13 macros and
`soc_npu` with the frozen pilot inside it — hardened on `docs/61`'s
floorplan, and carried to extracted parasitics and three-corner sign-off
STA. At post-CTS, the stage where `docs/49` measured the largest
single-change improvement ever recorded on this design, it is worth
**−0.2014 ns**: nothing, inside the noise. At sign-off it is worth
**−1.0109 ns**: a regression, outside it.

Convention, as elsewhere: **[fact]** = measured in this environment or
read out of a file; **[estimate]** = derived or judged, with the
derivation stated; **[assumption]** = chosen, and named so it can be
argued with; **[planned]** = intended, with nothing behind it yet.
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
