Melihakbulut221/neuromorphic-space-soc/thesis/figures/layout_blocks.pdf

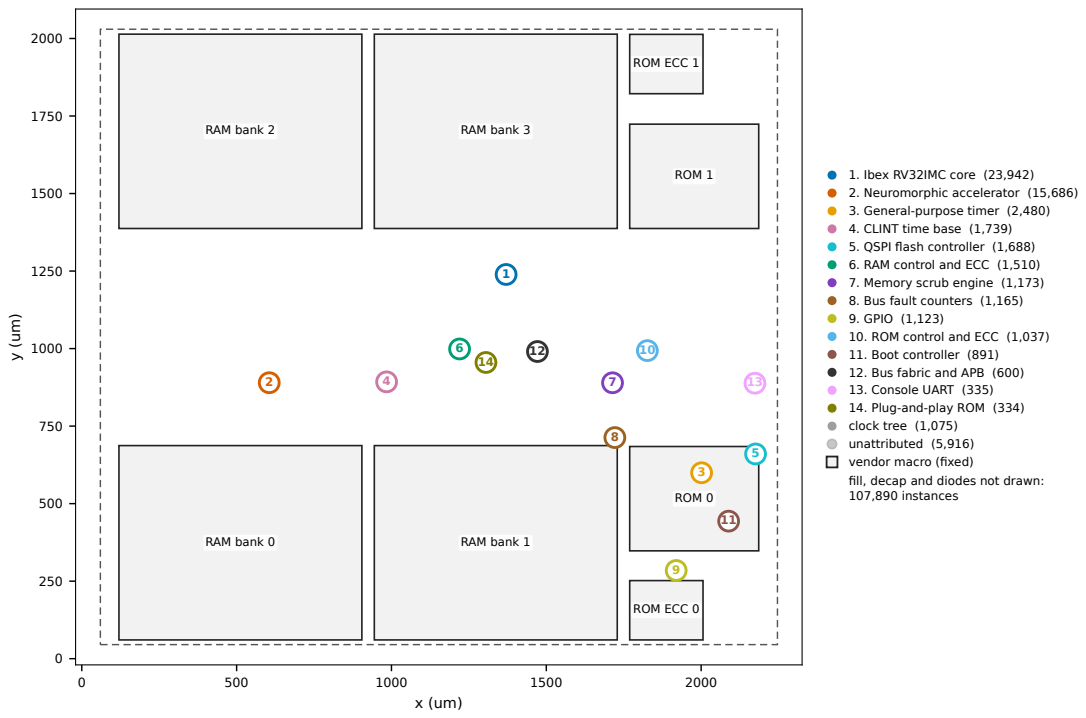
[picture p7: page 1]
RAM bank 0; RAM bank 1; RAM bank 2; RAM bank 3; ROM 0; ROM 1; ROM ECC 0; ROM ECC 1

1. Ibex RV32IMC core (23,942)
2. Neuromorphic accelerator (15,686)
3. General-purpose timer (2,480)
4. CLINT time base (1,739)
5. QSPI flash controller (1,688)
6. RAM control and ECC (1,510)
7. Memory scrub engine (1,173)
8. Bus fault counters (1,165)
9. GPIO (1,123)
10. ROM control and ECC (1,037)
11. Boot controller (891)
12. Bus fabric and APB (600)
13. Console UART (335)
14. Plug-and-play ROM (334)
clock tree (1,075)
unattributed (5,916)
vendor macro (fixed)
fill, decap and diodes not drawn:
107,890 instances
