Melihakbulut221/neuromorphic-space-soc/paper-soc/figures/layout_regions.pdf

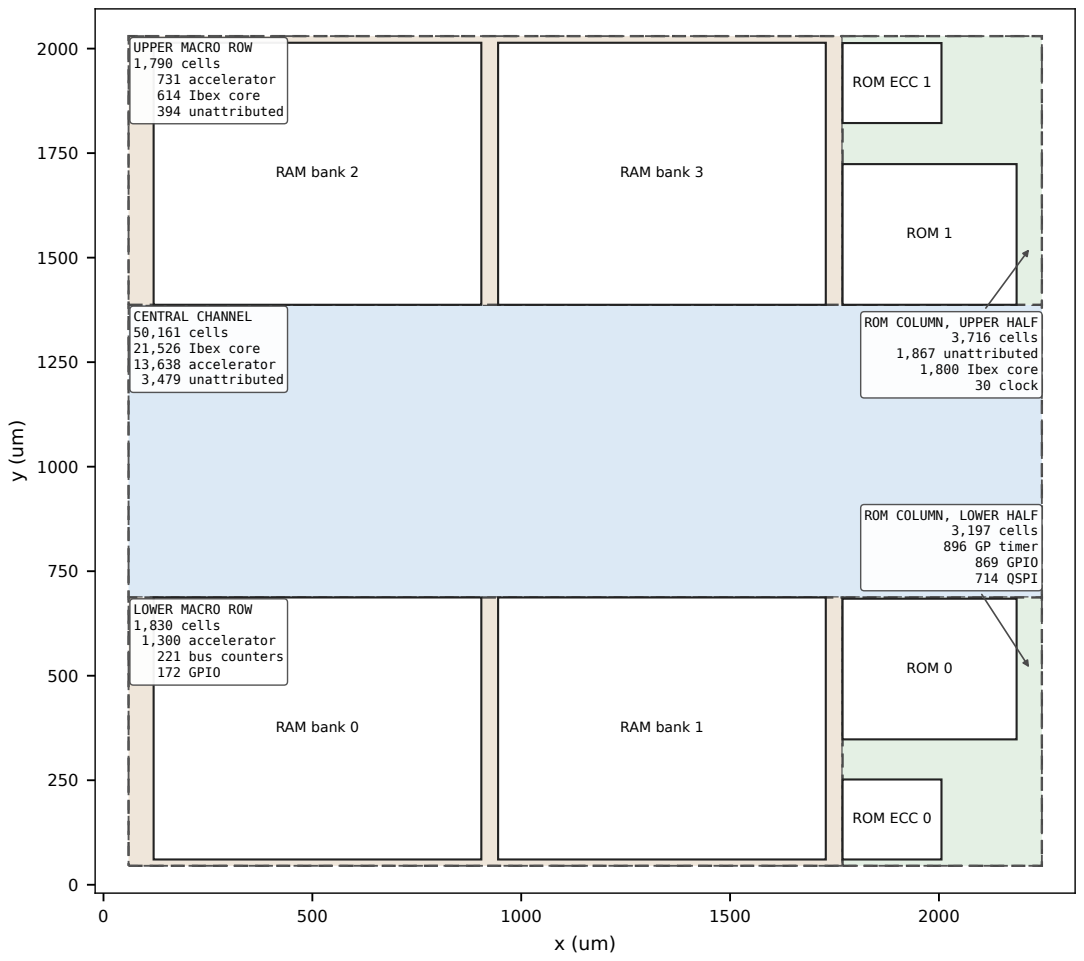
[picture p8: page 1]
RAM bank 0; RAM bank 1; RAM bank 2; RAM bank 3; ROM 0; ROM 1; ROM ECC 0; ROM ECC 1; CENTRAL CHANNEL 50,161 cells 21,526 Ibex core 13,638 accelerator 3,479 unattributed; 3,197 cells 896 GP timer 869 GPIO 714 QSPI; 3,716 cells 1,867 unattributed 1,800 Ibex core 30 clock

UPPER MACRO ROW
1,790 cells
731 accelerator
614 Ibex core
394 unattributed

ROM COLUMN, UPPER HALF

ROM COLUMN, LOWER HALF

LOWER MACRO ROW
1,830 cells
1,300 accelerator
221 bus counters
172 GPIO
