Melihakbulut221/neuromorphic-space-soc/thesis/figures/layout_density.pdf

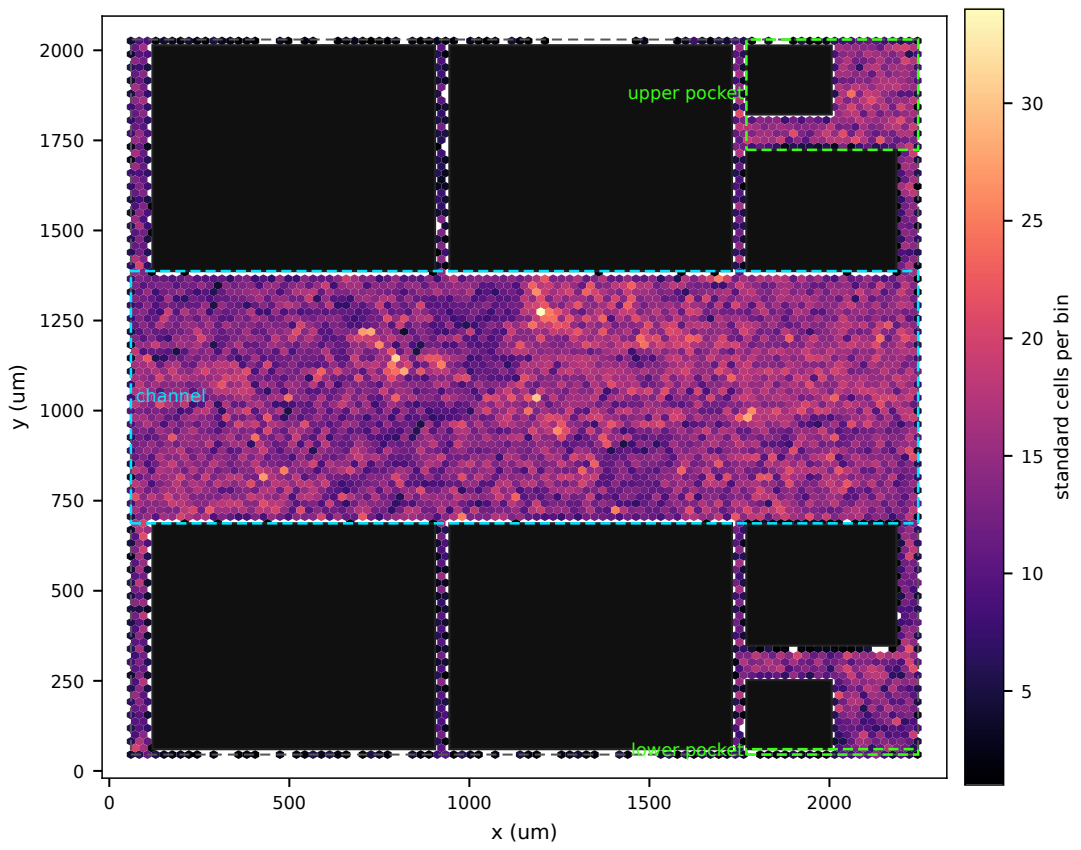
[picture p9: page 1]
channel; upper pocket; lower pocket

standard cells per bin
