Melihakbulut221/neuromorphic-space-soc/hw/soc/rtl/soc_npu.v

// SPDX-FileCopyrightText: 2026 Hasan Melih Akbulut
// SPDX-License-Identifier: CERN-OHL-W-2.0

// soc_npu: the CPU-side NPU interface, and the frozen pilot behind it.
//
// docs/39-soc-bus-and-memory-map.md section 9 item 4 is the gap this
// closes: "No NPU connection. The 256 MiB window is frozen and reaches
// the error slave." docs/51-npu-integration.md is the design argument;
// this header states the contract the argument produced.
//
// =====================================================================
// 1. TWO INTERFACES, BECAUSE THERE ARE TWO PROBLEMS
// =====================================================================
//
// Configuration and event flow are not the same problem and this module
// does not pretend they are. They have different rates, different
// latency tolerances, different transports on the die, and they land in
// different places in the frozen memory map -- which is not a
// coincidence, because regmap/memmap.yaml's author separated them
// before either existed.
//
//   THE NODE REGISTER WINDOW, on the system bus at SOC_BASE_NPU.
//   A memory-mapped view of one docs/10 section 10 register block per
//   mesh node, at NODE_ID * 0x1000, which is the per-node base address
//   docs/10 section 8 item 5 FREEZES. Low rate, latency tolerant,
//   ordinary loads and stores. Its transport is soc_npu_ser.v and a
//   register access costs about 172 clock cycles.
//
//   THE EVENT PORT, on the peripheral bus in the NPUCFG slot.
//   A pair of 16-bit AER event queues (docs/10 section 7.1 event words)
//   with a hardware engine between them and the die. This is the
//   datapath. An injection costs a write to one register and a
//   collection costs a read from another, both at APB rate, and the
//   engine does the transport work in the background.
//
// The split is why NPUCFG spends the interrupt and the node window does
// not: an interrupt is a datapath signal. docs/40 froze NPUCFG at APB
// slot 0x019 with source number 24 on fast local line 12 and this block
// occupies exactly that. It spends NOTHING that was spare -- lines 13
// and 14 are still unassigned -- and one line is enough for any number
// of nodes because the cause register, not the wire, says what happened.
//
// =====================================================================
// 2. THE TRANSPORT, AND WHY IT IS THE SERIAL ONE
// =====================================================================
//
// hw/rtl/pilot_top.v is INSTANTIATED HERE, unmodified, out of the
// directory docs/34-pilot-freeze.md pins by git blob hash. Not copied,
// not adapted, not given a parallel register port. Its register bank is
// reached the way the TTIHP26b die will be reached: four serial pins.
//
// The full argument is docs/51 section 3. The short form is that the
// die that comes back in 2027 has a serial port and nothing else, so a
// parallel port would make the SoC's model of the NPU unvalidatable
// against the only real hardware this project will ever have -- and the
// cost of avoiding that is 172 cycles on a register access that
// software performs a few dozen times per pass.
//
// hw/soc/flow/sim_soc.sh already reads hw/rtl/tmr_voter.v the same way,
// and the rule is the one every hardening document here has followed:
// hw/rtl/ is READ and never written.
//
// =====================================================================
// 3. THE DIE'S PARALLEL AER PORT IS USED, AND IT IS NOT SYMMETRIC
// =====================================================================
//
// pilot_top.v section 1's pin contract gives the event path its own
// pins, and this module uses them on the input side and cannot use them
// on the output side. That asymmetry is in the pin contract, not in
// this file:
//
//   INPUT.  AER_IN_ADDR[3:0] with AER_IN_TICK and a rising-edge
//   AER_IN_STB carries a SPIKE or a TICK, one per strobe, at four clock
//   cycles each. This module drives them, gated on AER_IN_RDY.
//
//   AND IT CANNOT CARRY A SYNC. The pin word's TYPE field is built
//   from AER_IN_TICK alone, so it is 00 or 01 and never 10. SYNC -- the
//   frame barrier that docs/10 section 7.1 makes the determinism and
//   multi-pass handshake primitive -- has no pin, and this module
//   injects it by writing the die's EVQ_IN register over the serial
//   transport instead. That is 172 cycles once per frame, not per
//   event.
//
//   OUTPUT.  AER_OUT_VLD says an event is presented and AER_OUT_ID[3:0]
//   is, in pilot_top.v's own words, "the low four bits of its ID
//   field". THERE IS NO TYPE ON THE OUTPUT PINS. A SYNC echo and a
//   spike from neuron 0 are the same four bits, and the barrier that
//   tells the sequencer a frame is complete is exactly what would be
//   lost by reading them.
//
//   So AER_OUT_VLD is used as a NOTIFICATION and the word is read from
//   the die's EVQ_OUT register, which pilot_top.v section 1 says "is
//   always available over the serial EVQ_OUT register". AER_OUT_ACK is
//   tied low and is never used: the serial read is itself the pop, and
//   two pop paths into one show-ahead register would be two ways to
//   lose the same event.
//
// The cost is stated rather than hidden: an output event costs a serial
// frame and an input SPIKE costs four cycles, so this port is ~43x
// faster inbound than outbound. That is the pin budget of a Tiny
// Tapeout tile showing through, and docs/51 section 8 measures it.
//
// =====================================================================
// 4. QUEUES
// =====================================================================
//
// Both queues are hw/rtl/aer_fifo.v, the proved queue the die itself
// uses, instantiated from the frozen directory for the same reason
// pilot_top is: a second event queue in this repository would be a
// second set of pointer, parity and drop semantics to get right. Its
// drop counter, its entry parity and its pointer voting come along.
//
// The capture queue needs a SHOW-AHEAD read, because the register view
// of EVQ_OUT is "read one word, see VALID and EVENT in the same
// access". aer_fifo is a registered-output queue, so the gap is closed
// by the one-entry adapter of pilot_top.v section 8 -- convention C9,
// whose reference implementation is that file's oh_valid/oh_data/oh_pop
// and whose alternatives that section already rejected.
//
// The injection queue needs no adapter, because the engine never has to
// peek: it POPS the head, holds it, and then decides which transport it
// takes. What it does need is a BOUNDED WAIT, because aer_fifo may
// legitimately answer a read with nothing -- an entry whose stored
// parity fails is DISCARDED and rd_valid is held low. A fetch that
// never returns would hang the engine, so it expires, counts, and
// reports. hw/rtl/pilot_top.v does the same thing at its own dispatcher
// for the same reason (docs/16 section 5.1).
//
// =====================================================================
// 5. WHAT IS NOT HERE
// =====================================================================
//
// No descriptor rings. docs/08 section 3.1 sketches "per-node SRAM
// apertures + descriptor rings" for this window and this block builds
// the apertures and not the rings, because a ring is a BUS MASTER and
// this fabric has two master ports, hardcoded, with a two-master
// round-robin arbiter whose fairness property is written for two.
// docs/51 section 9 prices it and states the event rate above which it
// pays for itself.
//
// No second node. N_NODES is a parameter, the window decodes all
// sixteen NODE_ID values docs/10 section 8 item 2 allows, and fifteen
// of them are a bus error.
//
// =====================================================================
// 6. WHAT IS HARDENED, AND WHAT THE MEASUREMENT SAID TO LEAVE ALONE
// =====================================================================
//
// Until docs/55 this header said "No hardening of anything this file
// adds", and docs/39 section 9 item 3 recorded the same for the whole
// SoC. docs/52 then measured the block -- 700 injections, seven strata,
// each run twice -- and RANKED WHAT TO PROTECT BY CONSEQUENCE rather
// than by size. Three things came out of it and they are built here.
// Every one of them names the number it rests on, because a hardening
// with no measurement behind it is the mistake docs/38 section 10 item 4
// names and this file is the second block in the SoC to avoid it.
//
//   H1. A BOUND ON THE FABRIC RESPONSE.  [7 of 7 dead machines,
//       docs/52 section 7.1; 5 in the transport's phase state, 2 in
//       `win_state`]
//       This block's ONLY lethal failure is a lost fabric response: a
//       frame that never ends, so busy_o never falls, so the window
//       never leaves W_WAIT, so rvalid never returns, and Ibex stalls
//       for ever. soc_npu_ser.v now bounds the frame; the window now
//       bounds its own wait, and both turn a dead machine into a LOAD
//       ACCESS FAULT the program can handle. The watchdog caught all
//       seven and its answer was a system reset; this is the cheaper
//       answer the campaign says is worth building.
//
//   H2. THE QUEUES' PROTECTION HAS SOMEWHERE TO REPORT.  [79 absorbed
//       upsets, 0 visible to any operator channel, docs/52 section 10]
//       `ptr_mismatch`, `par_err` and `rv_mismatch` used to leave the
//       two aer_fifo instances and go nowhere. They now do two things:
//       they raise a sticky bit in this block's own cause register, and
//       they leave the block as fault lines into BUSSTAT, where docs/44
//       already built saturating counters and stickies for exactly this
//       class of event. docs/51 section 14 item 1 declined this on the
//       grounds that a fault-counter block invented HERE would put
//       NPU-only telemetry outside BUSSTAT -- which is an argument about
//       WHERE THE COUNTERS LIVE and not about whether the events are
//       visible, and the counters live in BUSSTAT.
//
//   H3. THE CONTROL AND CAUSE BANK IS TRIPLED.  [16 false fault reports
//       in 100 draws, docs/52 sections 6.3 and 11.2]
//       The highest per-bit consequence anywhere in that campaign, and
//       note its SHAPE: it is not a missed fault, it is a FABRICATED
//       one. A fault-reporting channel that invents events is worse than
//       one that is merely lossy, because it will be believed, and every
//       recovery policy docs/09's S2 supervisor might implement reads
//       this register. docs/41 section 3.1's criterion -- persistent
//       times silent -- selects exactly these bits: software writes them
//       once, this block never rewrites them, and nothing votes, scrubs
//       or reports them.
//
// H4 AND H5 ARE docs/56'S, AND THE TWO OF THEM REST ON ONE MEASUREMENT
// THAT COULD NOT BE MADE BEFORE IT. docs/52 and docs/55 drew the event
// engine as ONE stratum of 140 bits contributing 1.71 of the
// connection's 4.17 points, and docs/55 section 14 item 1 made splitting
// it the PRECONDITION of hardening it, on the ground that an
// undifferentiated stratum is hardened by protecting its largest
// structure. Split into five and drawn 100 times each, the engine's
// silent corruption is not spread over it at all:
//
//     ev_data   64 bits, 45.7 % of the engine   0 of 100
//     ev_cnt    32 bits, 22.9 %                 0 of 100
//     ev_seq    19 bits                        13 of 100
//     ev_oh     19 bits                         6 of 100
//     ev_pin     6 bits                        18 of 100
//
// -- and per SITE, 96 % of the engine's whole rate is in NINE BITS:
// `aer_in_stb` (18 of 18 draws), `ev_state` (7 of 20), `oh_req` (3 of
// 4), `cap_wr_en` (5 of 8), `oh_valid` (2 of 4) and `inj_rd_en` (1 of
// 4). THE RATE IS IN THE STROBES AND NOT IN THE DATA. docs/56 section 3.
//
//   H4. THE SHOW-AHEAD ADAPTER'S READ IS BOUNDED.  [`oh_req`: 3 silent
//       wrong inferences in 4 draws, and a wedge no campaign reached]
//       The reason is a defect this file's own header describes and
//       applies to the OTHER queue -- a read of an aer_fifo may
//       legitimately return nothing, so it needs a bound -- and the
//       adapter had none. `oh_req` was cleared by `cap_rd_valid` alone
//       and the refill stood off on `!oh_req`, so ONE discarded capture
//       entry, or one upset that set that flag, stopped the block
//       delivering events FOR EVER while `cause[C_EVT]` went on saying
//       one was waiting. Measured both ways in: docs/56 section 5.1.
//
//   H5. THE AER STROBE IS GATED BY THE STATE THAT IMPLIES IT.
//       [`aer_in_stb`: 18 silent wrong inferences in 18 draws]
//       The highest per-bit rate in any campaign this block has had, on
//       ONE flip-flop, and the whole of `ev_pin`'s contribution. An
//       upset in it strobed a phantom SPIKE or TICK into the frozen die
//       with whatever the address and type pins held, and the die
//       accepted it. `aer_in_stb == (ev_state == E_PIN_S)` was already
//       an invariant of the FSM, so the redundancy was in the netlist
//       and was not being used; the pin is now the AND of the two and a
//       disagreement raises IRQ_CAUSE.AER_MM. IT COSTS NO FLIP-FLOP.
//       Section 9.
//
// AND TWO THINGS THE MEASUREMENT SAID TO LEAVE ALONE, which is the part
// of the ranking that keeps being counter-intuitive. `evq_data` -- the
// two queues' stored words and their entry parity -- is 41.2 % of the
// connection's flip-flops and 53.5 % of its area (docs/51 section 11),
// and it produced ZERO silent wrong inferences in 100 draws. The reason
// is occupancy: the queues hold a couple of live entries out of eight,
// so most of those 304 bits are storage nothing will read. A hardening
// wave that started with the biggest structure would have spent its
// whole budget there and bought nothing. NOTHING IN THIS FILE PROTECTS
// THE QUEUE STORAGE and docs/55 section 6 is why.
//
// docs/56 found the same shape one level down and it is now a rule
// rather than a coincidence: `ev_data`, the event word in flight, is 64
// of the engine's 140 bits -- the largest sub-stratum by a factor of
// three -- and came back 0 of 100, as did `ev_cnt`'s 32. NOTHING IN
// THIS FILE PROTECTS THE EVENT WORD EITHER.
//
// =====================================================================
// 7. THE REPLICATION BOUND, AND WHY THE BANK IS ONE WORD
// =====================================================================
//
// hw/rtl/pilot_top.v section 8.2 proves three replicas cannot be held
// apart over ONE bit -- there are exactly two storage functions, x and
// ~x -- and docs/30 section 3.3 generalises it: three bits is the first
// width at which a third replica has a function left to take. Almost
// everything H3 protects is one bit wide: `ctrl_in_en`, `ctrl_out_en`
// and each of the seven sticky cause bits. Replicating any of them on
// its own would give a netlist with ONE flip-flop and a voter voting it
// against itself, and every test and every proof in this repository
// would still pass.
//
// So they are BUNDLED into one PROT_W-bit word and the WORD is
// replicated, which is docs/41 section 4.2's answer and the move
// hw/rtl/pilot_top.v's own header names. The bank is
// hw/soc/rtl/soc_tmr_bank.v -- already built, already proved, already
// instantiated in the watchdog -- and the voter is hw/rtl/tmr_voter.v,
// read in place out of the frozen directory and not copied.
//
// TWO CONSEQUENCES OF THE BUNDLE, both stated rather than discovered.
//
//   * The bank has NO WRITE ENABLE: the whole word is written from the
//     voted value on every edge, which makes the voter a continuous
//     scrubber and bounds the exposure to a coincident second upset at
//     one clock cycle. soc_tmr_bank.v difference 1 is the argument. It
//     costs nothing here that it does not cost in the watchdog.
//   * THE REPORT IS INSIDE THE PROTECTED WORD. `sticky_cfg_tmr` is a
//     field of the bank, not a register beside it, so the write that
//     repairs a replica and the write that records the repair are the
//     same write on the same edge. docs/16 section 5.8 measured what the
//     other arrangement costs: an upset can erase the announcement of
//     the very event it caused.
//
// ONE DELIBERATE DIVERGENCE FROM docs/41 SECTION 5.3, and it is the
// clearability of that report. The watchdog's `tmr_err` is NOT
// clearable, on the rule that a record software can erase is a record an
// upset can erase. Here every sticky cause bit IS write-1-to-clear,
// including this one, because IRQ_CAUSE is an INTERRUPT cause register
// whose entire contract is acknowledgement: a bit in it that could not
// be acknowledged would hold an enabled interrupt asserted for ever,
// which is docs/40 section 7.2's brick in a new place. The durable
// record lives in BUSSTAT's saturating counter instead, which is
// docs/44 section 6.4's argument for the same choice.
//
// WHAT IS STILL NOT PROTECTED, and it is most of the flip-flops. The
// transport's 40-bit shift register, the event engine's state, the
// window's captured request, the two queues' storage and both frame
// guards are single points by decision. docs/55 section 6 prices each
// one against what docs/52 measured of it, and docs/52 section 12 item 5
// is why parity over the shift register was declined.
// =====================================================================
// 8. H4's GUARD IS UNPROTECTED STATE, AND ITS CORRUPTION IS BENIGN
// =====================================================================
//
// docs/55 added twenty unprotected flip-flops whose upset FAILS A
// HEALTHY ACCESS -- the transport's guard, the window's guard and
// `win_out` -- and said so rather than netting it off. H4 adds three
// more, `oh_guard`, and they are different in kind, which is worth
// stating because "one more guard" would otherwise read as one more of
// the same trade.
//
// An upset that makes `oh_guard` expire early clears `oh_req` while a
// read may still be in flight. It cannot pop a second entry: the refill
// stands off on `!cap_rd_valid` and `!cap_rd_en`, so the earliest
// re-issue is two cycles later, by which time the in-flight read has
// either raised `cap_rd_valid` -- which sets `oh_valid` and blocks the
// refill -- or been discarded, which is the case the bound is for. And
// it cannot lose one, because nothing here touches `oh_valid` or the
// queue's pointers. THE WHOLE COST OF A SPURIOUS EXPIRY IS ONE NEEDLESS
// STICKY BIT. docs/56 section 6.4 draws into these three like any other
// site rather than assuming it.
//
// What H4 does NOT protect is the rest of the adapter. `oh_valid` and
// `oh_data` are single points: an upset that sets `oh_valid` makes the
// block hand software a stale word and report an event that is not
// there, and one that clears it loses the word the adapter is holding.
// docs/56 section 11 item 3 prices tripling the adapter's bundle
// against what the campaign measured of it and declines it in this wave,
// and section 10 of that document is the surviving exposure.
//
// =====================================================================
// 9. H5 COSTS NO STATE AT ALL, AND THAT IS WHY IT IS NOT ENOUGH
// =====================================================================
//
// H5 adds no flip-flop. `aer_in_stb == (ev_state == E_PIN_S)` is an
// invariant of the FSM below -- the flag is set on the edge out of
// E_PIN_A, cleared on the edge out of E_PIN_S, and the flush path
// clears it in the same statement that returns `ev_state` to E_IDLE --
// so the flag is a REDUNDANT ENCODING of a state this module already
// holds, and the pin is now the AND of the two. A spurious strobe needs
// two coincident upsets where it needed one.
//
// FOUR THINGS IT DOES NOT DO, and each is a decision rather than an
// oversight:
//
//   * IT DOES NOT CORRECT. On a disagreement the pin is held quiet.
//     That is the right answer when the FLAG was corrupted -- 18 of 18
//     of docs/56's draws -- and it LOSES AN EVENT when `ev_state` was,
//     and this module cannot tell which. `IRQ_CAUSE.AER_MM` says the
//     inbound path took an upset and does not claim to say more.
//   * IT DOES NOTHING FOR THE ADDRESS AND TYPE PINS. `aer_in_addr` and
//     `aer_in_tick` have no state that implies them, and docs/56
//     measured them at 0 of 65 and 0 of 17: a corrupted address on a
//     strobe that is not happening reaches nothing, and there is one
//     cycle per event in which it would.
//   * IT DOES NOTHING FOR `ev_state` ITSELF, which docs/56 measured at
//     7 of 20 and which is now the largest single site left in the
//     engine. Section 11 of docs/56 ranks it and says what it would
//     cost.
//   * AND IT IS NOT TMR. Tripling the flag is impossible on one bit
//     (section 7) and tripling the bundle would cost twelve flip-flops
//     and correct rather than mask. docs/56 section 6.1 prices that
//     against this and takes this one first because it is free, not
//     because it is stronger; section 11 item 5 is what it would still
//     buy.
//

`timescale 1ns / 1ps
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
