Melihakbulut221/neuromorphic-space-soc/hw/soc/formal/soc_bus_props.v

// SPDX-FileCopyrightText: 2026 Hasan Melih Akbulut
// SPDX-License-Identifier: CERN-OHL-W-2.0

// Formal properties for the system fabric (SymbiYosys harness,
// hw/soc/formal/soc_bus.sby).
//
// WHERE THESE PROPERTIES COME FROM. Two specifications, both written
// before the RTL, and one generated file:
//
//   * The Ibex memory protocol, quoted in full in the header of
//     hw/soc/rtl/soc_bus.v out of
//     ext/ibex/doc/03_reference/load_store_unit.rst. Four rules:
//     req held until gnt; payload free to change after gnt; exactly one
//     rvalid per grant carrying rdata and err; multiple outstanding
//     requests answered in order.
//   * The slave contract S1-S4 and the same-slave restriction, also in
//     that header, which is the specification the rest of the SoC's
//     slaves are written against.
//   * hw/soc/rtl/soc_memmap.vh, generated from regmap/memmap.yaml. The
//     decode properties compare against those constants, so a decoder
//     that drifts from the frozen map fails here. Restating the RTL's
//     own comparison would have proved nothing.
//
// GHOST STATE, NOT THE DESIGN'S STATE. The outstanding counts, the
// per-slave occupancies and the per-master slave locks below are all
// reconstructed from the ports, independently of cnt_i, cnt_d, lock_i,
// lock_d and q_fill. A property that read the design's own counter would
// be satisfied by a fabric that miscounted consistently.
//
// ONE INTERNAL SIGNAL IS REFERENCED: err_rvalid, the response strobe of
// the error slave, which has no port because the error slave is inside
// this module. It is used to complete the occupancy bookkeeping in F5
// and F6. Nothing is DERIVED from it -- the property it takes part in is
// "every response belongs to a request", which is a specification
// statement, and there is no other way to observe a slave that has no
// pins.
//
// AND FOUR MORE AT REQ_REG = 1, WHICH ARE ASSERTED ON AND NOT READ:
// `xfer`, `xfer_tgt`, `xfer_own` and `req_busy`, the design's own
// request-phase boundary. I6 states that the ghost request phase
// reconstructed from the ports below is exactly them. That is the
// opposite of deriving a property from the design: it makes the ghost
// an OBSERVATION of the design rather than a definition, so that F3c,
// F4b, F8 and the covers -- all of which turn on the ghost -- are not
// circular. A fabric that transferred a request the slave had not
// granted, or that pushed the wrong master's ownership, fails I6 and
// not only the properties downstream of it.
//
// WHAT REQ_REG CHANGES IN THIS FILE, in one paragraph. At REQ_REG = 1
// soc_bus.v captures the arbitration's result into a register and hands
// it to the slave a cycle later, so the GRANT and the TRANSFER are no
// longer the same event. Every clause below that was a statement about
// one of them and silently about the other has been split: the
// per-master outstanding counts stay on the grant, the per-slave queues
// move to the transfer, and the difference between the two -- at most
// one request, sitting in the fabric's register -- is carried by the
// ghost `f_fly` and named `f_out_i_slv` / `f_out_d_slv` where an
// invariant needs it. NOTHING IS WEAKENED: at REQ_REG = 0 every line
// below elaborates to the line that was here before the parameter
// existed, `f_fly` folds to a constant zero, and two properties are
// ADDED at REQ_REG = 1 -- I6 above and F3e, which is Ibex protocol rule
// 1 obeyed by this fabric toward its slaves and which the
// combinational request phase does not obey.
//
// WHAT IS NOT PROVEN HERE:
//
//   * Liveness of any kind. Nothing says a request is ever granted or a
//     response ever arrives. F9 is a bounded fairness property under the
//     assumption that all slaves are ready, which is much weaker than
//     "the fabric cannot deadlock".
//   * That responses are IN ORDER. F4 proves each master's outstanding
//     requests are all at one slave and F7 proves responses are not
//     lost, duplicated or delivered to the wrong master. Ordering then
//     follows from the slave contract S3 (a slave answers in order) and
//     is assumed of the slaves rather than proved of them here.
//   * Anything about the number of slaves or their addresses beyond what
//     soc_memmap.vh says. If the map adds a region and the decode below
//     is not extended, F1 still passes -- the new region simply reaches
//     the error slave. The cocotb suite is what checks the map's regions
//     against the fabric's ports, because it can enumerate the generated
//     map and this file cannot.
//   * Reset behaviour beyond the initial state.
//   * That REQ_REG = 1 costs exactly one cycle of latency and no
//     throughput. That is a performance claim, it is not a safety
//     property, and docs/84 measures it on the whole SoC instead.

localparam integer F_ERRSLV = 6;
localparam integer F_NS     = 7;   // six ports plus the error slave

reg f_past_valid;
initial f_past_valid = 1'b0;
always @(posedge clk_i) f_past_valid <= 1'b1;

initial assume (!rst_ni);

// ---------------------------------------------------------------------
// Observations, in terms of ports only
// ---------------------------------------------------------------------
wire        f_gnt     = mi_gnt_o || md_gnt_o;
wire [2:0]  f_tgt_idx = s_req_o[0] ? 3'd0 :
                        s_req_o[1] ? 3'd1 :
                        s_req_o[2] ? 3'd2 :
                        s_req_o[3] ? 3'd3 :
                        s_req_o[4] ? 3'd4 :
                        s_req_o[5] ? 3'd5 : F_ERRSLV[2:0];
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
