Melihakbulut221/neuromorphic-space-soc/(commit log)

2026-08-24 Research phase and design wave 1
    Reports: GR801 decomposition and 130nm scaling (01), NPU architecture
    selection (02), CPU and interface IP survey (03), technology and flow
    (04), market positioning (05), NLnet and TTIHP26b logistics (06), GR801
    datasheet conventions study (08), formal verification program (09).
    Design: NPU MVP spec v0.1 (10) with bit-exact golden model and 65-test
    suite including spec-to-test traceability enforcement; register map
    single source with generators and sync check; AER FIFO RTL with cocotb
    testbench and passing SymbiYosys proofs (k-induction, BMC, cover);
    verification harness guide (11).
    Review pass applied: logic-density ratio restated raw-to-raw, OpenRAM
    macro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
2026-08-25 Independent design review, review fixes, and ROADMAP
    docs/07: independent verification pass over the research phase and
    design wave 1 (19 findings, 7 rejected candidates, verdict: sound
    conditional on blocking actions).
    All blocking and non-blocking dispositions applied: SKY130-to-SG13G2
    physical re-baseline in docs/01 with two-column budget table and
    architecture-supersession errata; per-PDK SRAM density bands and
    recomputed candidate feasibility in docs/02 (512-neuron configuration
    now a stated hard dependency on IHP foundry macros); corrected interface
    roll-up in docs/03 (base 280-475 h, CPI optional); positioning-language
    and radiation-source corrections in docs/04 and docs/06 (SG13RH/S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
    [aer_fifo.v, lif_core.py, network.py]
2026-08-25 Design wave 2: RTL blocks, formal proofs, clean sg13g2 sign-off, TT submission
    RTL: register bank generated from the register-map single source, LIF
    neuron datapath verified in lockstep against the frozen golden model,
    SECDED (72,64) codec, TMR voter, and a pilot top-level integrating them
    behind a Tiny Tapeout wrapper.
    Verification: 145 golden-model tests; 108 cocotb tests across six suites
    (aer_fifo 11, register bank 33, LIF 24, SECDED 12, voter 7 per width,
    pilot 21 across seven geometries); 28 SymbiYosys tasks in one gate via
    "make -C formal everything", covering FIFO ordering, register-bank
    write-enable and lock semantics, SECDED correction and detection, voter
    majority, and LIF handsh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
    [RM_IHPSG13_1P_512x32_c2_bm_bist_bb.v, aer_fifo.v, aer_fifo_props.v, lif_core.v, lif_ctrl_props.v, npu_regbank.v]
2026-08-25 Design wave 3: fault-injection campaign, scrub controller, and a real deadlock fix
    The fault-injection campaign is the point of this wave. It injects seeded
    single-bit upsets into the pilot and classifies every outcome against the
    golden model rather than against the design's own flags: 255 injections
    over ten structures in 84 s, fully reproducible from seed 0x16F12026.
    It found a defect nothing else had: the event dispatcher could deadlock
    silently. D_FETCH had one exit, "if (fi_rd_valid)", while fi_rd_en is
    asserted only from D_IDLE, so an upset landing the FSM in D_FETCH with no
    read outstanding waited forever with STATUS.BUSY high and nothing flagged
    anywhere -- the one failure class th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
    [pilot_top.v, scrub.v, scrub_props.v, secded.py, test_fi_campaign.py, test_pilot_top.py, test_scrub.py]
2026-08-26 Fix TMR collapse in synthesis, add FPGA and sky130 targets, pin the toolchain
    Checking this design against the CI suite of gonsolo/borg turned up a
    defect none of our own verification could see: the configuration TMR did
    not exist in silicon. The three 55-bit replicas were written identically,
    so yosys opt_dff normalised them into identical enable flops and opt_merge
    hashed them into one bank. The netlist that fed the 4x2 harden carries 362
    references to cfg_a and none to cfg_b or cfg_c, and the voter therefore
    read one physical bank three times: a real upset would corrupt all three
    "replicas" at once and the voter would agree with itself.
    The fault-injection campaign reported this TMR as 1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
    [pilot_top.v]
2026-08-26 Inject configuration TMR upsets into the bank storage, not the voter input
    Since the replicas became pilot_cfg_bank instances (hw/rtl/pilot_top.v
    header section 9), cfg_a/cfg_b/cfg_c are continuously driven nets rather
    than registers, so a deposit on them models an upset arriving at the
    voter input instead of one held in a flip-flop. The campaign now targets
    u_cfg_{a,b,c}.bits, which is the bank's storage register.
    Icarus lets a deposit on a driven net persist until the driver
    re-evaluates, so both spellings classify identically on this simulator
    and the docs/16 numbers are unchanged. Only the new one is a flop
    deposit, and only the new one is portable to a simulator that does not.
    Bit pos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
    [test_fi_campaign.py]
2026-08-26 Count the configuration TMR banks in the real hardened netlist
    The guards in this file run a MODEL of LibreLane synthesis. The model is
    close but not byte-identical -- before the TMR fix it read 1045
    flip-flops where the real 4x2 run read 1037 -- so it can agree with
    itself while the shipped flow does something else. Only the final
    netlist becomes silicon.
    test_config_tmr_survives_the_real_hardening_flow reads the final netlist
    of a LibreLane run on disk and counts flip-flop CELLS under each of the
    u_cfg_a / u_cfg_b / u_cfg_c instance paths, so it measures the artifact
    after placement and CTS have also had a chance to touch it. Modelled on
    test_tmr_survives_the_hardening_flow in the sibling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
2026-08-26 Harden the SDC-dominant memories, and publish the documentation
    The fault-injection campaign ranked which structures produce silent data
    corruption, weighted by flip-flop count: the synapse weight file at 144,
    the membranes at 117, the refractory counters at 32. Those three were the
    unprotected majority of the design's state, in a chip whose proposition is
    fault tolerance. lif_core now protects them, verified in lockstep against
    the frozen golden model in the fault-free case and by directed injection
    in the faulty one. The formal gate grows to 45 tasks with the new lif_mem
    job; the LIF cocotb suite goes from 24 tests to 32.
    Documentation, which had no entry point at all:
    scripts/build_docs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
    [lif_core.v, lif_mem_codec_props.v, lif_mem_props.v]
2026-08-29 Measure that the hardening worked, and give the TMR a defence that needs no attribute
    The memory hardening is now measured rather than asserted. Re-running the
    fault-injection campaign at the same seed, over 287 injections (up from
    255, because the protection is itself state that can be hit):
    before 83 MASKED / 42 CORRECTED / 39 DETECTED / 91 SDC / 0 HANG
    after 158 MASKED / 42 CORRECTED / 39 DETECTED / 48 SDC / 0 HANG
    Silent corruption falls from 35.7 to 16.7 percent of injections. Every
    one of the 84 single-bit deposits into a coded memory or its check field
    left the event stream and the neuron state bit-exact against the golden
    model, and the campaign now enforces that as a pass cr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
    [lif_core.v, pilot_top.v, test_fi_campaign.py]
2026-08-29 Report the lif_core memory ECC instead of discarding it
    The memory hardening gave lif_core four status outputs -- wmem_sec,
    wmem_ded, state_sec, state_ded -- and pilot_top connected none of them.
    A LibreLane run reported it as four PINMISSING lint warnings; grep for
    the names in pilot_top.v returned nothing at all.
    So a corrected or an uncorrectable upset in the synapse memory or the
    neuron-state memory reached no register, no counter and no pin. That is
    the same defect docs/16 already recorded for CNT_SEC, where an upset
    that erased the record of a correction made the classifier read MASKED:
    an unreported correction is indistinguishable from no upset, and a DED
    in the synapse file is preci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
    [pilot_top.v]
2026-08-29 Settle the tile budget from a pinned harden, and retract the arithmetic that left it open
    Both documents promised that every figure would be requoted once the
    re-harden they described as in flight landed. It has:
    hw/openlane/pilot_ihp/runs/ihp-mix/, sign-off clean on Magic DRC, Netgen
    LVS, antenna and detailed-route DRC, zero unmapped instances, all three
    corners closing.
    The reasoning those revisions used to leave the budget open was wrong,
    and the run says so rather than merely superseding it. They took the
    MIX transform's measured +0.92 % of SYNTHESIS area, compared it against
    the 0.68 % of core the previous harden left spare, and concluded the
    70 % criterion was "a coin toss". The +0.92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
2026-08-29 Record what the queue pointers cost, and the trap in fixing them
    The four AER pointers are twelve flip-flops carrying 46 percent of the
    design's residual silent corruption: 22 of 24 injections corrupted the
    drained event stream with nothing flagged, and the corruption modes are
    whole bursts re-emitted, events duplicated, events lost, events
    fabricated, and an unwritten slot presented as a spike. An event
    interface has no sequence number and no length field, so a consumer
    cannot tell any of those from a real spike train.
    The note goes where whoever hardens them will look, at the pointer
    declaration, because the obvious implementation is wrong in a way this
    project has already paid for once: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
    [aer_fifo.v]
2026-08-29 Measure the pointer TMR properly, and fix the deadlock that measuring found
    The campaign was reporting the AER pointer TMR as 23 SDC and zero
    corrections out of 24 injections — triple redundancy masking nothing,
    which is not a plausible outcome. It was not measuring the design. The
    injector still named the voted pointer, which after wave 5 is a driven
    net rather than state, and Icarus holds a deposit on a driven net until
    its driver re-evaluates: so the run modelled a permanent stuck-at on the
    voter's output instead of a transient at its input, and faithfully
    reported the pre-TMR result against working hardware. This is the second
    time this trap has caught this project; the first was the c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
    [pilot_top.v, test_fi_campaign.py, test_pilot_top.py]
2026-08-29 Prove the pointer redundancy in silicon, and report that 4x2 is now over budget
    The guard that was skipping now passes. Re-hardening the pilot on IHP put
    a current netlist on disk, and the check counted three flip-flops under
    each of the twelve pointer replica banks -- thirty-six in total, out of
    1,268 mapped -- in the hardened netlist rather than in a fresh synthesis.
    The configuration TMR is still 55 in each of three banks. Wave 5's
    redundancy exists in the thing that would be manufactured, which is the
    only place the question could be settled.
    The same run carries the finding that matters more. Utilization is
    71.19 percent, so the design no longer meets the 70 percent planning
    criterion: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
2026-08-29 Move the submission to 6x2, decided by measurement rather than by area
    The pilot needed twelve tiles. Twelve tiles comes in two shapes and they
    are not equivalent, so both were hardened and compared.
    The area argument that suggested 3x4 was wrong twice over. It applied the
    70 percent planning criterion a second time to figures that already
    carried it, inflating both estimates by exactly 1/0.70: the measured
    utilizations are 41.92 percent for 3x4 and 47.29 percent for 6x2, not the
    60.2 and 67.4 predicted. Both clear the criterion with room to spare, so
    headroom stops being the discriminator and the flow's behaviour becomes
    the whole question.
    There, 6x2 wins on every axis that matters. It c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
2026-08-30 Close the aer_fifo proof gap, and record how a green gate hid it
    The 45-task formal run reported PASS for all four aer_fifo tasks and was
    not evidence about the design in the tree. hw/rtl/aer_fifo.v and
    formal/aer_fifo.sby were written at 19:31 and formal/aer_fifo_props.v at
    18:37, against a run whose aer_fifo tasks executed at 16:21, so those
    four PASSes had seen neither the queue-pointer TMR of commit c5a5a6e nor
    the properties written for it. Section 8.3 even claimed the table saw
    "the current aer_fifo_props.v", which was false when it was written.
    Re-run against the current tree: prove, prove_d4, bmc and cover all
    PASS, all seven cover statements reached, the last -- empty &&
    f_seen_ful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
2026-08-30 Simulate the netlist, route sky130 at twelve tiles, and stop a citation pointing at the wrong project
    Gate-level simulation was the last item on the ROADMAP P1 verification
    bar that had never been run, and it matters more here than the phrase
    suggests: this project has been bitten three separate times by the gap
    between what the RTL says and what the netlist contains, and every test
    in the repository until now exercised RTL.
    Twenty of the twenty-seven pilot tests run against the hardened 6x2
    netlist and all twenty pass -- not merely green but consuming exactly the
    same simulated time as on the RTL, test for test. The register map, the
    serial protocol, the AER pins, the show-ahead contract,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
    [test_pilot_gl.py]
2026-08-30 Inject into the safety nets, and find that the report is the weak half
    The design has two bounded-wait counters whose only job is to convert a
    silent hang into a host-visible fault, added after the campaign found
    deadlocks in the dispatcher and in the show-ahead adapter. Neither had
    ever been injected into. The structures that catch the failure class this
    chip exists to rule out were themselves unverified against it.
    They are half robust, and the half that fails is the half that reports.
    The wait counters cannot be broken: 12 of 12 masked, and structurally so
    -- a monotone increment tested for equality at 63 reaches 63 from every
    value, and no single flip from zero can reach it. TMR on the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
    [test_fi_campaign.py, test_gl_fi.py]
2026-08-30 Make the fault report unerasable, and learn that a one-bit flag cannot be tripled
    Two repairs, both driven by the safety-net campaign, and the second one
    produced a result worth more than the flip-flops it saved.
    The timeout pulses are gone. A one-cycle pulse flop was the only thing
    standing between a recovered deadlock and a reported one, and the campaign
    showed it breaking in both directions: set spuriously it fabricated a
    fault, cleared in its single live cycle it erased a real one, leaving
    STATUS at 0x06 with every counter zero and the ERR pin low while the run
    returned a wrong answer. Expiry is now a combinational term that both ends
    the wait and latches the sticky error on the same ed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
    [pilot_top.v, test_fi_campaign.py, test_pilot_top.py]
2026-08-30 Inject faults into the netlist, and find where the RTL campaign does not reproduce
    Every hardening claim this project makes rested on RTL-level injection,
    and this project has twice found RTL-level measurement saying something
    the netlist did not support. This closes that.
    The method took the work. A deposit does not model an upset on a netlist
    -- it holds until the driver re-evaluates, which is a stuck-at -- so the
    injection is a one-cycle force on the net a mapped flip-flop drives,
    opened 3 ns after one rising edge and released 3 ns after the next, so
    the window spans exactly one capture edge and the design's own next-state
    logic decides whether the upset survives. Three alternatives were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
    [test_gl_fi.py]
2026-08-30 Rail the last two valid flags, and close the toolchain hole a header kept open
    The valid-flag class is finished. u_evq_out.rd_valid and lif_core's
    out_pend now carry the same two-rail construction as oh_valid, a
    disagreement is held low rather than trusted, and both report to the
    sticky error. Silent corruption falls from 23 to 18 across 366 injections,
    with 356 common records unchanged in every field. Five of the residual
    structures remain and evq_mem now leads outright.
    rd_valid costs two flip-flops rather than one, because the module is
    instantiated twice and the input queue gets the same pair. That second
    pair is real coverage -- its rd_valid is on the unrepresented list -- but
    no campa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
    [aer_fifo.v, lif_core.v, pilot_top.v, test_fi_campaign.py]
2026-08-30 Re-harden after waves 5 and 6: the redundancy is in the shipped netlist
    The census guards pass by name rather than skipping. On the netlist that
    would be manufactured: three configuration banks at 55 flip-flops each,
    twelve pointer replica banks at three each, and all eight valid-flag rails
    at one each. No count is wrong, so nothing this project added for
    redundancy has been optimized away -- the claim it has spent the most
    effort on is refreshed against the current design rather than inherited
    from a netlist four RTL changes old. 26 guards pass, none skip.
    Sign-off is clean at 47.23 percent utilization with 32.5 percent of the
    core spare against the planning criterion, so the tile budget t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
2026-08-30 Guard the rails in the real netlist, and close the directory the guards were not reading
    The eight dual-rail valid flags were covered only by the yosys-model
    tests, and their count in the shipped netlist had been checked once, by
    hand, in a document. That is the wrong shape of evidence for this defect
    class. A rail built at the same polarity as its twin is functionally
    identical RTL: every simulation in this repository passes it, and no
    amount of testing can distinguish it. Only counting cells in the real
    netlist sees it, so the count has to be automatic or it drifts.
    The new guard reads the netlist LibreLane produced and asserts the exact
    population -- one flip-flop under each of the six r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
2026-08-30 Recover the timing margin, and find that the flow was never derating at all
    The margin did not go where any of the three suspects suggested. The
    critical path swapped cones: the old one improved by 2.82 ns and a
    different one degraded by 2.13 ns, so the 0.91 ns headline was the
    arithmetic of a swap rather than one path slowing down. The rails are
    measurably innocent -- the nearest rail path ranks 175th of 1,653 and
    does not reach the critical cone within fourteen logic levels -- and the
    timeout retirement is in a different module from every cell on the path.
    The actual cause is that 56 of the 60 cells on it are minimum drive,
    placement is not timing-driven, and the only setup-repair step run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
2026-08-30 Apply the derate, and correct the four closed-timing claims it falsifies
    The flow has never derated. Both PDKs set TIME_DERATING_CONSTRAINT as the
    integer 5 and LibreLane consumes it with Tcl integer division, so the
    factors were 1.0 and 1.0 while every log reported five percent. The three
    base configurations now set it as a float, verified in tclsh: the integer
    gives a late factor of 1, the float gives 1.05.
    Then the record had to be made honest, and the run trees were still on
    disk with their netlists, parasitics and constraints intact, so the
    figures were re-derived rather than annotated as unrecoverable. The
    harness was validated before it was trusted: it reproduced five figures
    the doc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
2026-08-30 Close evq_mem with entry parity, and reject SECDED on the constraint that actually binds
    The queue storage was the last unprotected structure in the event path
    and led the residual list at seven silent-corruption records. Every entry
    now carries an even-parity bit; a read whose stored word fails the check
    consumes and discards the entry, holds the read answer low and raises a
    new par_err, so the loss surfaces through the consumers' bounded waits
    rather than silently. Residual silent corruption falls from 18 to 11
    across four structures, evq_mem is closed, and all seven records moved
    from SDC to DETECTED with 366 of 374 unchanged when diffed by key.
    SECDED was the alternative and it was not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
    [aer_fifo.v, aer_fifo_props.v, test_aer_fifo.py, test_fi_campaign.py]
2026-08-30 Detect what cannot be corrected: the dispatcher, and a replication bound that generalises
    The five dispatcher records turned out to be a kind this project had not
    met before. A dstate flip takes D_FETCH to D_ISSUE -- both legal
    codewords -- so the machine issues a stale event word; another reaches
    the illegal encoding where the default arm silently drops the event in
    flight; and three corrupt the event word's identifier or type and issue
    it as a real spike. Every answer arrives, on time, and wrong. No bounded
    wait can see that, which is why the two earlier dispatcher repairs did
    not touch these.
    Correction was not available, and the reason is a proof rather than a
    budget. The one-bit replic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
    [pilot_top.v, test_fi_campaign.py, test_pilot_top.py]
2026-08-30 Put the settings that make the design close into the path that builds it
    The submission would have shipped a design that misses timing, and every
    check would have been green.
    docs/31 did not infer that, it measured it. Hardening the submission
    configuration on the current RTL misses the slow corner by 1.8321
    nanoseconds derated, on eighteen violating endpoints -- and the flow
    reports that run clean, because without SETUP_VIOLATION_CORNERS the setup
    checker examines only the typical corner, where it passes at +6.8753. Not
    one of the six keys that the timing recovery adopted was in
    tt/src/config.json, and the configuration that carries them is worth
    3.0588 nanoseconds on the same sources.
    Th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
2026-08-30 Confirm the submission closes, from the file that actually builds it
    The distinction the whole defect turned on had to be settled before the
    run meant anything. Project.harden calls create_merged_config before it
    invokes LibreLane and passes src/config_merged.json on the command line,
    so config.json is an input to the file that builds and config_merged.json
    is the file that builds. This harden used the latter, regenerated by the
    Tiny Tapeout tooling itself, and the six keys survive the merge with the
    derate still a float.
    Sign-off is complete and every counter is zero: Magic DRC, KLayout DRC,
    the XOR, all six Netgen LVS counters, route DRC, antenna nets and pins,
    power grid on both rails, i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
2026-08-30 Re-run gate level on the current netlist: the two levels now agree completely
    370 of 370 comparable injections classify identically between RTL and
    gate level, against 355 of 357 last time, with the histograms equal in
    every class and no group carrying a class difference. The redundancy
    added over four waves is exercised on the netlist for the first time: all
    eight valid-flag rails give 16 of 16 detected with no silent corruption,
    the queue parity and dispatcher check flip-flops give none either, the
    seven queue-storage records that used to be silent are now detected on
    both sides, and the configuration TMR re-sweeps 165 of 165 corrected.
    Three pieces of staleness turned out to be in the ha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
    [test_gl_fi.py]
2026-08-30 The rail polarity works where it matters and is erased after it stops mattering
    I asked for one of two outcomes: make the storage transform survive
    synthesis, or retract the claim that it exists. The measurement says
    neither, and the third answer is better than both.
    The read-side inversions do not fold at RTL. With every keep and
    keep_hierarchy deleted from the source, synthesis leaves two distinct
    storage functions -- a reset-to-zero flip-flop and a reset-to-one one --
    and no merge pass can touch them. The polarity transform is real,
    attribute-free, and doing exactly the job it claims, at the point where
    merging happens.
    What erases it is technology mapping. The rail's reset value is the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
    [aer_fifo.v, lif_core.v, pilot_top.v]
2026-08-31 Freeze the pilot, and find that a proven block's proofs proved the wrong thing
    Two workstreams, both scoped to leave the RTL untouched because the pilot
    is signed off and the shuttle closes in three weeks.
    The freeze record pins the submission by hash: ten RTL blobs, the
    netlist, layout and stream checksums for both sign-off runs, the manifest,
    the six flow configurations and the toolchain and PDK versions, with a
    nine-command block a reader runs to check every claim mechanically. Its
    tightest statement is that both runs' netlists hash to the same value, so
    the design the decks were read against and the design the submission path
    builds are the same bytes; and the RTL that landed after sign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
    [aer_fifo_props.v, tmr_voter_cfg_props.v, tmr_voter_props.v]
2026-08-31 Bring up Ibex on the pinned flow, and price what it costs
    The management CPU docs/03 recommended, taken as far as it can go
    without integrating it into anything. No bus, no memory map, no wiring
    to the NPU -- deliberately. The question was whether the survey's
    recommendation survives contact with the flow, and it does, with two
    corrections to the reasoning and one fact that changes a decision.
    sv2v converts all 38 source files with zero errors and zero patches to
    Ibex. The output synthesises on sg13g2 and runs in Icarus with no
    SystemVerilog anywhere in the flow: a 1,884-byte program from upstream
    RISC-V GCC executes, and 11 of 11 self-checks pass in 131,694 cycles.
    With PMP enabled the cor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
    [ibex_min_system.v, prim_clock_gating.v, tb_ibex_min.v, test_ibex.c]
2026-08-31 Third config simulates, and correct what the lockstep run actually proves
    The SecureIbex configuration now runs the same self-test: 11 of 11
    checks, no alert, lockstep active, 131,694 cycles -- identical to the
    non-secure run, which is the expected shape since the shadow core is
    parallel rather than in series. A fifth bring-up defect is recorded with
    the other four: SecureIbex silently changes the memory contract to
    39-bit ECC, and a testbench tying the integrity bits to zero never
    executes a single instruction. It presented as a catastrophic lockstep
    failure and was a missing testbench feature.
    The correction. This document argued that the clean lockstep run meant
    "a mistranslation anywher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
    [ibex_min_system.v, soc_memmap.h, tb_ibex_min.v, tb_soc.v, test_ibex.c]
2026-08-31 Freeze the memory map, and build the fabric the CPU actually needs
    The interconnect is Ibex's own req/gnt/rvalid protocol internally, with
    real AMBA 3 APB at the peripheral boundary. There is no AHB in this SoC
    and none is claimed. Everything GR801 software actually sees -- the
    memory map, the 4 KiB slot geometry, the peripheral register maps, the
    device-table record layout -- is mirrored from GRLIB/NOELVSYS, because
    that is the layer docs/08 section 3 defines proximity at.
    Area did not decide it. The AHB path was built as a cost probe and
    measured rather than assumed: 17,154 um2 against 14,807 for what was
    built, a difference of 0.85 % of the CPU. Four things decided it
    instead. No periphe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
2026-08-31 Interrupts, timers and a watchdog that cannot be talked out of it
    Three decisions, each argued rather than taken from a template.
    No PLIC, and the region stays reserved for one. Ibex carries fifteen
    fast local interrupts at IDs 16-30, each individually vectored at
    mtvec + 4*id, each with its own mie bit, priority-ordered by ID. That is
    a single-hart interrupt controller, already in the core, free. The
    frozen map defines thirteen sources, so two lines are spare. A PLIC
    would have added a claim/complete round trip across the APB bridge and a
    32-source gateway state machine that would have been the least-covered
    logic in this repository.
    The decision is now mechanical rather than remembered.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
2026-08-31 Harden the watchdog: TMR the state whose corruption defeats the block
    INCOMPLETE, and committed in this state deliberately so that a shutdown
    does not lose it. The RTL, the formal work, the fault injection and the
    netlist guards are done and green. The document is not written. Do not
    read this commit as a finished piece of work -- section "what is left"
    below is the resume point.
    What is here. soc_tmr_bank.v, and soc_wdog.v rebuilt around it so the
    state that matters is triplicated: the enable, the escalation stage and
    the reload -- the three whose corruption defeats the block rather than
    merely perturbing it. The voter is byte-identical to the one the pilot
    freeze pins, reused rather than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
2026-08-31 Record the watchdog hardening, and measure what it bought
    Completes 159d85f, which committed the RTL green but undocumented. This
    is the write-up, the area measurement it was missing, and the reasoning
    for what was deliberately left alone.
    What is protected is the eight fields whose corruption is permanent or
    silent -- the bootstrap latch, the stage-1 pending flag, the reset
    record, the saturating reset count, the reset stretch and a new mismatch
    report. Twenty-two bits, tripled.
    What is not protected is counter, reload and pre: 36 flip-flops, more
    than the protected word. The block rewrites all three itself, so an
    upset there is bounded rather than permanent -- a timeout shifts, and
    the n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
2026-08-31 Fix the direction of the area-baseline error, and correct my own record
    Two wording fixes to docs/41 section 6.5. Quoting docs/40's 5,785.97 as
    the baseline understates the hardening's cost by 58.17 um2 rather than
    overstating the saving: W6 rewrote the next-state logic combinationally
    and that refactor is 7 cells cheaper on its own, so the old number
    credits the hardening with a saving the refactor made. The direction was
    stated backwards. The magnitude is small and the habit is not, which is
    why it is worth a commit.
    A correction to my own commit message on 159d85f, which is wrong and
    pushed. It says the triplicated state is "the enable, the escalation
    stage and the reload". The reload is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
2026-08-31 Measure the unhardened core, and find the failure the watchdog cannot see
    The campaign docs/38 section 10 item 4 made a consequence of choosing
    small-pmp rather than deferred work. 1,300 injections, 13 strata of 100,
    each run twice -- armed and with the watchdog held off -- for 2,600
    simulations. Every elaborated flip-flop bit in the core, 2,178 of 2,178,
    is named by a site, verified by an independent Yosys census rather than
    by the campaign's own controls.
    The core's silent-data-corruption rate is 2.8 percent design-weighted,
    plus or minus 1.6, with HANG at 2.1 plus or minus 1.8. Per stratum the
    SDC concentrates in fetch_fifo at 9 percent, controller and id_ctrl at
    8, multdiv at 7, regfile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
    [fi_workload.c, tb_soc_fi.v]
2026-09-01 Protect the register file, and find that the windowed watchdog does not work
    Both hardenings docs/42 recommended on measured value, built and then
    measured against the campaign that recommended them. One delivered
    decisively and one did not, and the one that did not is the more useful
    result.
    The register file. A SECDED-protected implementation substituted for
    ibex_register_file_ff, using this project's own codec read in place
    rather than a second one. Replaying docs/42's campaign with identical
    draws -- same site, same bit, same cycle, a byte-identical workload
    image -- the register-file strata go from 3 SDC and 4 HANG in 100 to 0
    and 0 in 200, with 190 CORRECTED that all ended with the go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
    [fi_workload.c, ibex_regfile_secded.v, regfile_secded_props.v, soc_gptimer.v, soc_timers.h, soc_wdog.v, soc_wdog_props.v]
2026-09-01 Correct the timing attribution, make the correction observable, and retire W7
    Three results, and the first two are corrections to numbers this project
    published.
    The timing attribution in docs/43 was wrong. It reported a 0.6926 ns
    slack loss and attributed it to the SECDED decoder sitting on the
    register read path. All ten worst setup paths at the slow corner, in
    both of its builds, start at cheriot_enable_i[0] -- an input soc_top.v
    ties to 4'b1010. The decoder cannot be on a path from a constant. The
    delta is real and the cause was not. What actually binds at 17.62 ns is
    rst_ni recovery on an unbuffered 2,328-fanout reset net, and the two
    builds report bit-identical slacks at every probe,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
    [fi_supervisor.c, fi_workload.c, ibex_regfile_secded.v, memmap_gen.py, regfile_secded_props.v, soc_busstat.v]
2026-09-01 Place and route the SoC: it does not close, and the memory is 4.29x the logic
    The first layout of anything under hw/soc/, and the answer to the
    question docs/45 said only a layout could answer is no. It closes at
    43.10 MHz, 13.8 percent below the 50 MHz target: -3.2029 ns setup at the
    slow corner on 2,003 endpoints, with extracted parasitics and a real
    derate. It also fails hold at the fast corner on 3 endpoints, max cap at
    all three corners and max slew at two, and the flow exits non-zero
    naming every failing corner rather than reporting a number.
    It does route -- 0 detailed-routing DRC errors, 0 disconnected pins, 0
    power-grid violations, 1 antenna violating net, 37,156 nets, 3.1 m of
    wir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
    [RM_IHPSG13_1P_1024x32_c2_bm_bist_bb.v, RM_IHPSG13_1P_2048x64_c2_bm_bist_bb.v, soc_bus.v, soc_mem_sram.v]
2026-09-02 The floorplan is not the problem, and two of the three leads were already spent
    docs/47 said 43.10 MHz was this design in this floorplan rather than
    this design. It was wrong, and the measurement that shows it is the most
    useful thing here. Nothing in this work beats 43.10 MHz; the best
    sign-off number in the repository is still -3.2029 ns at the slow
    corner.
    It reproduced first, eight ways: the synthesis is byte-identical to the
    netlist that was hardened, all six pre-layout three-corner figures come
    back digit for digit, the cell strip reproduces exactly, and the
    sign-off and checker-audit scripts return -3.2029 on 2,003 endpoints and
    17 of 19.
    Two of the three leads were already spent, a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
    [floorplan.py]
2026-09-02 SYNPRE acts on the wrong cone, and two H matrices had never been compared
    docs/48 recommended SYNPRE on the grounds that it acts on the SECDED
    encoder terminating the binding path. It does not, and correcting that
    is the result. SYNPRE restructures the decoder on the register file's
    read port; the binding path runs from a RAM macro through the load
    return to the write encoder in front of the storage and into a check-bit
    flip-flop. Disjoint cones. Resolving all 2,003 violators shows it
    plainly: the 444 behind the macros have worst -3.2029 ns and the 1,559
    SYNPRE can reach have worst -2.0227, so the most a perfect and free
    SYNPRE could do to the worst slack is nothing.
    It was run anyway, beca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
    [regfile_secded_props.v]
2026-09-02 Register the RAM read: it closes 0.78 ns and is 21 percent slower
    The last mechanism three documents had measured as able to put both
    halves of the binding path inside 20 ns. It works, it is the first
    claimable setup improvement in four documents, and it should not be
    kept. The recommendation is not to keep it, with three reversal
    conditions stated.
    The timing. Sign-off on the same floorplan and the same checker
    configuration: -2.4257 ns on 1,893 endpoints, 44.5917 MHz, against
    docs/47's -3.2029 on 2,003 and 43.0981. That is +0.7772 ns, 1.94 times
    the measured 0.4 ns noise floor. Of the 444 endpoints docs/47 launched
    from a macro's A_DOUT, zero remain; 1,889 of the 1,893 now launch from
    one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
    [soc_bus_probe.v, soc_bus_props.v, soc_mem.v, soc_mem_sram.v, soc_top.v, test_soc_bus.py, test_soc_mem.py]
2026-09-02 Connect the CPU to the NPU: an inference runs end to end and matches the model
    The task this project exists for. The CPU subsystem and the NPU were
    built separately and had never met; docs/39 froze a 256 MiB window at
    0x10000000 and left it unreached. It is reached now, on fabric port 5,
    with sixteen 4 KiB per-node register windows in its low 64 KiB and
    everything else in the window a bus error the program tests for.
    An inference runs end to end and matches the golden model event for
    event and neuron for neuron: 22 events in, 12 out, six spikes and six
    barrier echoes in stream order, plus the whole neuron state file. The
    answer is computed before the hardware is asked. gen_npu_vectors.py ru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
    [memmap_gen.py, soc_bus.v, soc_bus_props.v, soc_npu.v, soc_npu_ser.v]
2026-09-03 The clock was the wrong question, and the stated requirement is power
    Four documents attacked a timing gap. This one asked what the mission
    needs and found the question had been misframed.
    docs/05's four mission profiles are three different kinds of
    requirement, and the only numeral in the whole section is a power
    number -- tens of milliwatts, orbit-average. Five documents read past
    it and treated the section as a throughput specification that had
    forgotten to state its throughput.
    Sized properly, with every assumption numbered where it is made and
    swept afterwards: the event-camera profile against Falcon Neuro, the two
    DAVIS240C sensors flown on the ISS for exactly the lightning and sprit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
2026-09-03 Two decks in one PDK disagree about scope, and the blocker does not move
    docs/12 rejected the KLayout exit in one clause without examining its
    2,316 errors. Examined, they are two different things and neither
    reopens the gate -- but the reasoning that supports the no-go is now
    much better than the reasoning that produced it.
    The 2,316 reproduce three ways before anything is interpreted,
    including from the bare vendor macro GDS checked entirely on its own.
    That sharpens docs/12's "100 percent inside the macro" into 100 percent
    a property of the vendor cell as shipped, with neither of that
    document's two flow workarounds implicated.
    And the count runs opposite to Magic's. Sdiod.d and Sdiod.e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
2026-09-03 Measure the NPU connection, and refuse to quote its zero
    700 injections, seven strata of 100, each run twice against a
    counterfactual, plus seven controls. Coverage is 730 of 730 connection
    bits by an independent Yosys census.
    The classification's SDC column is 0 of 700 and the document refuses to
    quote it, which is the most important thing in it. fi_npu.c checks the
    inference against sw/golden/lif_core.py and a nonzero fail mask is an
    announcement channel, so a corrupted inference is DETECTED by
    construction. That is a property of the oracle and not of the hardware,
    and reporting it as a hardware result would have been the twelfth
    instance of a green number read wider than what produced it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
    [fi_npu.c, tb_soc_npu_fi.v]
2026-09-03 Harden the NPU connection in the measured order, and refuse a 19 percent
    docs/52 ranked this by consequence rather than by size, and the order
    was followed rather than re-derived.
    The lethal failure is gone. Seven of seven dead machines become zero,
    replayed verbatim from docs/52's own records, and a fresh 700 with the
    watchdog held off for the whole run has none -- so the backstop is no
    longer load-bearing here. soc_npu_ser gains a derived frame bound that
    forces idle and raises a timeout, and the node window gains its own,
    both following the two precedents this repository already had rather
    than inventing a third shape.
    The queues can be heard. ptr_mismatch, par_err and rv_mismatch -- th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
    [fi_npu.c, soc_busstat.v, soc_npu.v, soc_npu_ser.v, soc_npu_ser_props.v]
2026-09-03 Split the engine's stratum first, and find a stall that needs no upset
    docs/55 named the event engine next and attached a precondition rather
    than a suggestion: split its 140-bit stratum before hardening it. The
    split vindicates the precondition completely.
    96 percent of the engine's rate is in nine of its 140 flip-flops.
    ev_data -- 64 bits, the largest sub-stratum by a factor of three --
    comes back 0 of 100, and ev_cnt's 32 bits do too. The worst single bit
    is aer_in_stb at 18 silent wrong inferences in 18 draws, the highest
    per-bit rate this block has recorded, on one flip-flop. Hardening the
    engine as a whole would have protected the data path that contributes
    nothing, which is the same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
    [soc_npu.v, soc_npucfg.h, tb_soc_npu_fi.v, test_soc_npu.py]
2026-09-03 Map the die from the DEF, and correct four published numbers on the way
    An annotated floorplan of the sign-off layout, with every rectangle
    extracted from hw/soc/pnr/runs/full3/final/def/soc_top.def rather than
    drawn from understanding. The generator is stdlib-only and in the tree,
    so the picture regenerates rather than being an artefact nobody can
    reproduce.
    The extraction proves itself on every run: eight geometry self-checks --
    no macro overlaps another, no cell overlaps a macro, every cell sits on
    a ROW y, core plus margins reconstruct the die -- and ten cross-checks
    against the run's own metrics.json. All eighteen pass, and the macro
    total reproduces docs/47's 2,246,899.85 um2 to the l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
    [floorplan_map.py]
2026-09-03 Complete the event engine wave: the replay, and a prediction it refuted
    7721719 committed this work before its replay had finished, which was my
    error rather than the agent's. This is the part that was missing, and it
    is the part that decides whether any of it worked.
    The calibration is the cleanest this project has produced. On 1,000
    verbatim replayed injections exactly one record in a thousand changed
    its verdict: the frozen die's hundred, four hundred more in untouched
    strata and two hundred inside the split stratum all come back record for
    record. docs/55 had to refuse a 19 percent improvement because its
    frozen-die stratum moved on fifteen of a hundred; here the same control
    moves on n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
    [soc_npu.v]
2026-09-03 Protect mtime with a code rather than a copy, and price the idea that was cheaper
    Deferred three times, each with its reason recorded. The answer is a
    (72,64) SECDED code over the counter, decoded and corrected on every
    tick and re-encoded over the value about to be stored. Because the
    counter rewrites itself every clock the code is also a scrubber with a
    one-cycle period: no scrubber to build, no period to choose, no
    accumulation to bound. Eight added flip-flops against replication's 128,
    using hw/rtl/secded_enc.v and secded_dec.v read in place -- fixed at 64
    data bits by an elaboration guard, which is exactly mtime's width.
    The residue idea docs/41 pointed at is the document's negative re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
    [records_soc_clint_fi.csv, records_soc_clint_fi_h0.csv]
2026-09-03 Measure power under a real duty cycle, and find the design has a clock gate
    report_power on the sign-off netlist and SPEF with the default 0.1
    toggles per cycle replaced by rates read out of real whole-SoC
    simulations. Three corners, five windows, three programs, pinned to a
    detached worktree because the working tree was not clean -- the first
    supervisor build was contaminated by a concurrent agent's edits,
    discarded and re-run.
    docs/47's three figures reproduce to every digit before anything moves,
    along with its slack, its cell and flop counts, docs/56's cycle
    invariant and docs/46's signature. It also establishes that the flow's
    default activity IS the sign-off figure exactly, so a numbe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
2026-09-04 Harden the SoC that exists, and add a guard so a flow cannot go silent again
    docs/51 added u_npu to soc_top.v and updated one of the four flow
    scripts that build that file. fi_core.sh, syn_soc_top.sh and
    pnr_soc_top.sh all stopped elaborating. fi_core.sh was loud and ignored
    for six documents; the other two were silent, because nothing re-runs
    them between documents -- so runs/full3 sat on disk as the sign-off of a
    design that had stopped existing, and six documents of area, timing and
    power were measured on it.
    The re-run, on the same recipe, floorplan and checker configuration:
    42,518 cells and 5,263 flip-flops against docs/47's 27,565 and 3,085.
    The 26 flip-flops over docs/57's predictio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
    [floorplan.py, violator_census.py]
2026-09-04 Close SYNPRE for the third time, and start running the cocotb suites
    Two things, and the second one found the first's neighbour.
    SYNPRE, re-measured because docs/49 wrote down the condition under which
    its own conclusion would expire and docs/61 met it. The answer is no, and
    this time it is not a null result but a regression: -4.5898 ns on 2,607
    endpoints against docs/61's -3.5789 on 2,175, a delta of -1.0109 ns which
    is 2.5 times the measured noise floor and is therefore reportable. Total
    negative slack 62.5 percent worse, max slew 29 to 83, max cap 15 to 34.
    The finding is upstream of sign-off. docs/61 asked whether routing would
    take back the +3.4641 ns docs/49 measured at post-CTS. It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
    [test_soc_bus.py]
2026-09-04 Run riscv-formal against Ibex, and find the specification wrong twice
    Planned in docs/09 part B track 1 and never run. Phase 1 is the stock
    core with the upstream register file, which is the control that phase 2's
    delta will be measured against.
    70 of 79 bounded checks and 79 of 79 cover jobs pass: 62 of the 70
    RV32IMC instruction models at check cycle 20, and 8 of 9 consistency
    checks including reg at 25 and pc_fwd, pc_bwd, causal, unique and hang at
    30. Two wrapper assertions are proved along the way -- the core never has
    more than two bus requests in flight on either port.
    This is a different kind of claim from the 87 property tasks this project
    already had, and the document says so rat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
    [insn_div.v, insn_rem.v, prim_clock_gating_formal.v, wrapper.sv]
2026-09-04 Make the solver a knob, and record that six engines did not close reg_ch0
    Committed unfinished on purpose, so a shutdown does not lose it.
    RVF_SOLVER is now a parameter of the riscv-formal harness rather than
    boolector being wired in. The justification is not this session's
    convenience: docs/09 section C.4 item 7 asks for solver diversity on key
    proofs, and neither phase 1 nor phase 2 had any -- every result in
    docs/63 so far rests on one engine.
    reg_ch0 is the check that needs it. It is the register-file consistency
    property, it is the only reason phase 2 exists, and it still has no
    verdict. On the SECDED build boolector reached 1 h 41 min without
    closing and was killed by my own stop, wh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
2026-09-04 Reconcile the seven disagreements the datasheet found, in place and visibly
    Writing docs/60 forced a cross-check nobody had run and it found seven
    inconsistencies between this repository's own documents. Each was a
    number that could be repeated into a grant application or a shuttle
    submission, so each is now resolved to one traceable value, with the
    losing statements corrected where they stand and the original left
    visible. Nothing is silently overwritten.
    The pilot campaign was reported three ways, and neither outlier was a
    transcription error. A thirteen-commit walk of hw/tb/fi_campaign_results
    .json shows docs/21's 335 with 26 SDC is the file at 0448282 on
    2026-08-29, and docs/16's 366 w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
2026-09-05 GPIO end to end, spi_host through sv2v, and three interfaces assessed rather than built
    The first spacecraft interface, done to the standard the fabric set, and
    the answer to a question docs/38 left open for twenty-seven documents.
    GPIO is GRGPIO-shaped, 16 pins, in the slot the map reserved for it --
    0xFF902000, device id 0x01A, fast line 2 -- promoted from reserved to
    implemented so the six generated files, the PnP record and the map
    document follow from one edit. Fourteen cocotb tests against the
    specification pass and fourteen of fourteen mutations are caught, every
    mutant producing a TESTS= line so the docs/40 harness failure did not
    recur. Seven properties with ghost state reconstruct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
    [memmap_gen.py, soc_gpio.h, soc_gpio.v, soc_gpio_props.v, soc_top.v, tb_soc.v, tb_soc_fi.v]
2026-09-05 Protect the memory with byte codewords, and buy it by halving the RAM
    docs/58 called the SECDED codec's 64-bit width a coincidence worth
    using, because it matches the RAM macro's row. Costed from the LEF, it
    is not the answer: a (72,64) codeword is eight bits wider than a
    2048x64 row, so the check bits cannot live in it. Six options were
    priced. A seventh 2048x64 macro is +491,633.62 um2, 21.88 percent more
    macro area, with a read-modify-write on every sb and sh. A 4096x16 is
    +257,608.51 and 11.46 percent, with one on every store. Parity-only
    costs the same macro and corrects nothing.
    What is built is four (16,8) byte codewords inside the existing 64-bit
    row: no seventh macro, no die growth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
    [RM_IHPSG13_1P_512x16_c2_bm_bist_bb.v, byte_secded_props.v, floorplan.py, memmap_gen.py, mutate_soc_mem.py]
2026-09-05 Bring the plan, the application and the licence memo up to the repository
    The engineering had run thirty-four documents ahead of the three
    documents that decide the outcome. ROADMAP.md was last edited on
    2026-08-31 and cited nothing above docs/34; docs/13 was from the same
    day. Since then the CPU was brought up, the fabric and map built, the
    NPU connected and fed from flash, five hardening waves measured, the SoC
    placed and routed, power measured under a duty cycle, riscv-formal run
    against the ISA, GPIO and QSPI built and the memory protected.
    The ROADMAP now carries what was done and what the evidence is, and a
    new section on gates overtaken by events. The sharpest of those: G3
    asked for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
2026-09-05 Close the ISC action items in the memo that raised them
    fc252b9 acted on docs/14's own licensing finding in the same commit that
    published it, which left three statements stale the moment they landed:
    the table row saying the repository ships neither notice, the
    riscv-formal row's action to add one, and the stage-1 plan item. All
    three are now struck through with the correction beside them, dated and
    naming the commit, in the house convention docs/15 and docs/38 use.
    The fix did not wait for the signature because it was an obligation
    rather than a decision. ISC requires the copyright and permission notice
    in all copies; upstream ships it in COPYING; hw/soc/ext/ is gitignored,
    so the two tra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
2026-09-05 Boot from flash into RAM, and answer what the ROM is by deciding it
    The four questions docs/67 left open are one design, and the answer to
    the first governs the rest.
    The boot ROM is a mask-programmed array holding a loader and nothing
    else. The SRAM-loaded alternative is rejected not as wrong but as not
    terminal: it moves the question one level out, to a loader that has a
    loader. A mask ROM's bit is a via, so there is no stored-upset mechanism
    and no check field is owed -- which makes docs/67's "place the ROM's
    check macros" conditional on the stand-in rather than owed by the
    design. The 8 KiB macro pair is named a stand-in for the first time, and
    the document says first that a mask ROM is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
    [boot.c, memmap_gen.py, mutate_soc_boot.py, soc_boot.h, soc_boot.v, soc_boot_props.v]
2026-09-05 Harden soc_boot: 18 flops protected, 64 deliberately not, and the ranking moved
    docs/68 asked whether eight of this block's 92 flip-flops deserve
    protection. Ranked by what the corruption reaches rather than by how
    many bits there are, the answer is eighteen protected and seventy-four
    not, and the split has almost nothing to do with size.
    The decision word is 18 flops, 19.6 percent of the block, and carries 58
    of 72 silent corruptions unprotected: eleven parts that gave up early,
    eight that never gave up, four that refused to boot at all. The boot
    report and the epoch are 64 flops, 69.6 percent of the block, and
    produce 203 of 256 silent corruptions with zero boot consequence. They
    get noth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
    [records_soc_boot_fi.csv, records_soc_boot_fi_h0.csv]
2026-09-05 Place the hardened boot block: hold holds, setup regresses, and the noise floor is withdrawn
    docs/69 flagged this as the one remaining item that could invalidate a
    shipped number, because it added 51 flip-flops to a block whose fast-
    corner hold docs/68 measured at +0.0715 ns. Both layouts ran in this
    session, baseline beside change, and the answer is not the one expected.
    Hold closes at all three corners in both runs and is slightly better
    with the protected block: +0.0621 ns against +0.0517 at the fast corner,
    with the checker bound to every corner and reporting three measured. The
    worst hold path in both captures at a boot ROM macro pin with nothing of
    soc_boot on it. On the die the bloc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
2026-09-05 The flow is bit-reproducible, so every delta in the corpus was the netlist
    docs/70 named the gap under every noise-floor claim this repository had
    made: whether the layout flow is reproducible run to run had never been
    tested, so every floor was a floor over netlists resting on an unchecked
    assumption about the tools. It is now tested, and the answer is that the
    floor for an unchanged input is zero.
    The protected boot netlist was laid out again with nothing changed --
    same file, same config, same PDK checkout, same LibreLane and OpenROAD
    builds, same machine, resolved.json differing in no key. The sign-off
    metrics are byte-identical across all 199 keys: setup worst slack, total
    negative sla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
2026-09-05 The resizer did not hit a cap; it was handed a path that crosses a macro
    docs/70 localised its 4 ns regression to the post-GRT timing resizer
    inserting 102 setup buffers against the baseline's 519, and said why it
    did was not established. docs/71 proved the event reproducible. This
    reads the step's own report, re-executes it under debug on each run's
    saved state with no argument changed -- reproducing the flow's step to
    the byte, 102 and 519 buffers -- and establishes the mechanism.
    It is not a cap. Both repair_timing calls end on RSZ-0062; the setup
    repair used 0.1 and 0.4 percent of area against a 50 percent ceiling;
    no utilization or TNS limit was set; both resolved.json files are
    identi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
2026-09-06 The CLINT placement probe moves the crossing rather than removing it
    docs/72 found the 4 ns regression was one path crossing the upper ROM
    macro, and named a placement probe as the next block: keep the CLINT's
    read mux and its 32 response registers on one side of the macro, judged
    by the crossing count on the worst path rather than by WNS alone. Two
    forms of the constraint were tried on a derived 743-cell CLINT set, and
    neither removes the crossing. The document says so first.
    A fence -- a region and group written into the baseline's own placement
    database and resumed from global placement, with the flow configuration
    unchanged in every key -- was honoured by the placer and then failed
    glob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
    [clint_region.py]
2026-09-07 Gate-level campaign on the core: 1,158 identical, 17 disagreements, all explained
    Queued since docs/42 and deferred behind every hardening wave because
    each changed the netlist. The netlist has been stable through docs/70 to
    73 and docs/71 proved it reproducible, so this is a measurement of a
    fixed object: the sign-off layout's own final netlist, 5,873 flip-flops
    and six macros, named by md5.
    Using the layout netlist rather than the synthesis one cost nothing, and
    that was measured instead of assumed: both parse to the same 5,873
    flip-flops with identical instance names and 5,823 of 5,873 identical
    Q-net names, the fifty that differ being output-port flops the layout
    drives through an inser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
    [fi_rf_shadow.v, tb_soc_fi.v, tb_soc_fi_gl.v]
2026-09-08 A corrected upset no longer resets the part, and the census scare was wrong
    docs/74 left two things open and this closes both. One of them turns out
    not to have been a defect at all, and saying so is the more useful half.
    The census. docs/74 reported the watchdog's banks as 29, 14 and 15 by
    name against 29, 29 and 29 by the voter's cone, and I took that to mean
    every replica count since docs/41 was suspect. It does not. The
    undercounting census is one by Q-net name, built inside docs/74 for a
    different job; every guard in sw/tests counts by instance path, which is
    exact in its own recipe because flatten runs after dfflibmap. Measured
    side by side on one netlist: instance path 29/29/29, cone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
    [soc_wdog.v, soc_wdog_props.v, test_soc_wdog.py]
2026-09-08 Gate the fabric and the accelerator: idle halves, and neither gate closes timing
    docs/57 found the clock gate nobody knew about and made this its second
    recommendation, naming the price as re-proving the fabric's fairness
    against a sleeping slave. Two more gates now exist, the share of
    flip-flops behind one goes from 39.5 to 76.0 percent, and idle power
    halves. One of the two does not close timing and that is reported first
    among what remains.
    The fairness obligation was discharged by not incurring it. Rather than
    re-argue F9 against a slave whose clock is stopped -- which would have
    meant weakening a property this repository already watched fail silently
    for two documents -- there is a new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
    [soc_bus.v, soc_bus_props.v, soc_npu.v, soc_top.v, test_soc_bus.py]
2026-09-08 Record the suite totals instead of asserting them
    Every fault-injection campaign in this repository tracks its records.csv
    in git and can be audited afterwards. The suites could not. The totals
    quoted in commit messages -- "484 pytest, 398 cocotb, 58 formal" -- had
    no artefact behind them, which made them the only numbers here that were
    an assertion rather than a measurement naming its source. docs/21
    section 0 requires the artefact; this closes the gap for the suites.
    scripts/verify.sh runs pytest and the cocotb runner, reads the formal
    verdicts already on disk, and appends one line to verification-log.tsv:
    timestamp, HEAD, pass and fail counts for each, and a notes field
    carrying how old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
    [verification-log.tsv]
2026-09-08 Split the clock-gate enables, and withdraw the attribution that motivated it
    docs/76 ranked this repair first on the grounds that the sticky fault
    cone cost both clock-gating checks their slow corner. Reproducing its
    numbers first, then decomposing them by an instrument it did not have --
    partition every sequential cell by the clock net on its CLK pin, false-
    path one partition at a time, re-ask for the worst path to the gate --
    shows the premise is wrong, and that is the finding.
    The accelerator's -5.0198 ns does not launch in the accelerator. It
    launches at Ibex's register-file read address, the same flop that gives
    the design its worst slack, and reaches the enable through the ALU, the
    l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
    [verification-log.tsv]
2026-09-08 Record the clean-tree verification for 5384ee5
    The record for docs/77 was taken with the tree dirty, because the work
    was uncommitted at the time. This is the same three suites re-run at a
    clean HEAD, which is the state a reader would reproduce.
    [verification-log.tsv]
2026-09-08 Sign the licensing memo and execute stage 1, including the freeze re-pin
    docs/14 has been on the critical path since August: a Tiny Tapeout
    submission is a public repository, this one had no LICENSE, and
    publishing design sources with no grant is worse than any of the
    candidate licences. Section 11 is now signed -- rows 1 to 9 as
    defaulted, CERN-OHL-W-2.0 for hardware, Apache-2.0 for tooling,
    CC-BY-4.0 for documents and data -- and the mechanics its section 9
    stage 1 lists are done in the same change rather than promised.
    The boundary between the two licences is not a preference. A weakly
    reciprocal hardware licence asks that a modified version of this design
    be published and does not reach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
2026-09-08 Generate the public mirror, and fix two checks it caught on the way
    docs/14 section 9 stage 2 set 2026-10-05 to decide whether the public
    tree is this repository made public or a curated mirror, and named the
    deciding question: is the existing git history publishable as-is. It is
    decided early because a paper and an announcement both need a URL.
    A curated mirror, generated, carrying the tree and not the history. The
    honest answer to the deciding question is that the history has NOT been
    audited, and three hundred-odd commit messages written over three weeks,
    several recording what a funding application would say and what a
    shuttle would cost, are not publishable on the strength of rememberi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
2026-09-08 Refuse a second cocotb run instead of counting the first one's output
    verification-log.tsv carries two rows for 1ecf509 reading 558 and 624
    cocotb tests. The repository has 401. Both rows look exactly like
    measurements, and neither is one.
    Two runs of verify.sh overlapped. Every suite is counted by "the results
    XMLs written since this marker", which orders by TIME and not by owner,
    so each run counted the other's output as its own. Nothing failed and
    nothing warned; the totals were simply larger.
    This is the defect docs/66 recorded one scale down -- a fast suite
    counting the previous suite's XML because the marker was a
    second-resolution timestamp taken before the run rather than after it.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
    [verification-log.tsv]
2026-09-09 Measure where the replicas are, and check the netlist computes the RTL
    Two measurements that had never been made, made because a hostile
    reading of this corpus said they were the two that could sink it. One
    came back badly.
    THE REPLICAS ARE NOT SEPARATED ON THE DIE
    test_synthesis_guards.py counts mapped flip-flops by instance path and
    asserts three banks of 55. That is the instrument docs/33 built after
    the synthesiser merged three declared replicas into one, and it is the
    right instrument for a synthesis event. It is a statement about the
    NETLIST, and it has been read as a statement about the DIE.
    hw/openlane/replica_placement.py measures the die from the run's own
    final DEF. Its first c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
    [mutate.py]
2026-09-09 Close seven open items, and find the recorder reporting zero on a tree with 35
    The corpus is going public and a paper is being drawn from it. Seven
    items a hostile review ranked as retraction-class or thesis-class are
    closed here, each by an agent that owned a disjoint set of files and
    verified its own fix. Two of them are worth more than the other five.
    THE VERIFICATION RECORDER COULD NOT SEE THE FAILURES IT WAS COUNTING
    scripts/verify.sh exists because totals quoted in commit messages had no
    artefact behind them. It enumerated formal results with a two-level
    wildcard over two directories. riscv-formal writes its generated jobs
    somewhere else entirely, so the recorder STRUCTURALLY COULD N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
    [80-artefact-digests.tsv, verification-log.tsv]
2026-09-09 Say "triplicated in the netlist", and correct the exposure bound that hid why
    docs/79 measured the three replica banks touching on the die and stated
    the consequence: every unqualified sentence calling that state protected
    by triple modular redundancy is a netlist claim being read as a claim
    about a part. This is the sweep. It is nineteen sites across the front
    page, both datasheets, four hardening documents, two register-transfer
    headers and two test docstrings.
    THE PAPER ANNOUNCED THE SWEEP IN THE SENTENCE THAT WAS SUPPOSED TO
    RECORD IT
    paper/main.tex said: "Protected by triple modular redundancy is false as
    stated and now reads triplicated in the netlist throughout." It did not.
    Nothing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
    [soc_tmr_bank.v, soc_wdog.v]
2026-09-09 Apply the paper review: the registry was a decoration and said otherwise
    Six hostile reviews and three refutation passes over the draft. The
    verdict was major revision, and the reason is the one that matters: the
    defect the paper exists to name was in the paper's own load-bearing
    sentences, in the three places a reviewer reads first.
    THE REGISTRY, WHICH IS THE WORST OF IT
    paper/claims.yaml held 25 claims. The body prints about 174 numeric
    literals. Above the script, in the appendix a reader would actually run,
    the paper printed "# every number this paper prints". Two table captions
    and the source header said the same. Table 1 has about twenty figures
    and three are registered, all three rea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
2026-09-10 Run the decks and the timing repair, and report what both went against
    Twenty-four hours of compute answering two questions the paper had left
    as [Results pending]. Both came back usable, and both went against what
    this session predicted.
    THE GEOMETRIC DECKS: ZERO OUTSIDE THE VENDOR MACRO, ON ALL THREE
    Magic DRC over the whole soc_top GDS with every macro descended into,
    unmodified vendor deck, 17 h 11 m and 16 GiB: 39,969,214 error boxes.
    Inside a macro footprint 39,969,214. Straddling an edge 0. Outside 0.
    Outside the die 0. KLayout's main deck: 9,668 items in 3 of 173 rules,
    every one naming a cell inside the vendor hierarchy, none naming soc_top
    or any sg13g2 standard cell. Netgen LVS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
2026-09-10 Move the checks out of the workflows, so they run where the runner does not
    The runner has not started since 2026-09-03. Waiting for it is not a
    plan, and three documents were meanwhile asserting that checks it never
    ran were running. So the checks are now defined in one place that does
    not need it.
    scripts/ci_local.sh is that place. It runs every check the three
    workflows ran, in the same order, with the same assertions:
    licence spdx_check.py; the four licence texts present and the
    Apache text at its known digest; the map, the memo and the
    tree agreeing; all three generators re-run and diffed
    docs link integrity; the site built and gated on its manifest
    pa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
    [ci-local-log.tsv]
2026-09-10 Render the paper to readable HTML, since there is no TeX to typeset it
    The paper's deliverable is its LaTeX source and that has not changed.
    What was missing is something a reader can open, and the machine this
    work is developed on has no TeX -- pdflatex, xelatex, lualatex, latexmk
    and tectonic all absent, apt wanting a password -- while the CI that
    would have built the PDF has not started since 2026-09-03.
    paper/render_html.py handles exactly the macro set this document uses
    and nothing else, which is what lets it be faithful: 45 control
    sequences and eight environments, counted from the source. Anything
    outside that set is emitted VISIBLY in red rather than dropped, and the
    script exits n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
    [ci-local-log.tsv]
2026-09-10 The precheck runs locally, and my account of CI was wrong
    Two audits, nine agents. The headline is good and the correction is
    mine.
    THE SHUTTLE PRECHECK IS NOT A GITHUB DEPENDENCY
    docs/15 section 8.5 item 4 says the hosted precheck adds three things
    the local flow does not run -- a pin-placement check against the shuttle
    mux, a top-level-uniqueness check, and the shuttle's own DRC deck -- and
    concludes "precheck is what says it is acceptable to the shuttle". That
    conclusion is wrong about the dependency.
    tt/tt/precheck/ is on disk and is pure Python. From a rootless pip venv,
    70 seconds, PDK_ROOT and PDK=ihp-sg13g2 set, cwd the precheck directory:
    EXIT=0, "Precheck passed", 10 of 10 appli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
2026-09-10 The GDS action runs here, bit for bit, and CI found two checks with the wrong scope
    I wrote that the Tiny Tapeout GDS action "has no local substitute and
    there cannot be one". False, and not marginally.
    tt-gds-action is six shell steps around tt/tt/tt_tool.py and nothing
    else. `tt_tool.py --harden --ihp --no-docker` ran here in 24 min 11 s,
    all 74 flow steps, exit 0, flow__errors__count 0 -- and reproduced the
    frozen submission BIT FOR BIT: the netlist joins the 52b2debf family,
    the powered netlist, DEF, LEF, SPICE, SDC and metrics.csv all hash
    equal, metrics.json agrees on 194 of 194 keys, resolved.json differs in
    3 of 411 keys and all three are absolute paths. The GDS is
    byte-identical on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
2026-09-10 Run what nothing was running, and re-sign a gate whose design had moved
    Closing the ranked list an audit sweep left open. Four of the items were
    the same sentence with different nouns: a green result read wider than
    what it looked at. docs/81 is the whole account; this is what changed.
    THREE COCOTB SUITES THAT NOTHING RAN. scripts/run_cocotb.sh opens by
    claiming it runs every cocotb suite in the repository and ran three
    fewer: test_aer_fifo (20 tests), whose makefile is named Makefile and so
    falls outside the Makefile.* glob -- the block ROADMAP gate G0 signs off
    on -- and test_soc_npu_defects (4) and test_soc_wdog_strap (3), each
    written to fail against the RTL before a fix and reachable o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
    [80-artefact-digests.tsv]
2026-09-11 Decide the thirty-five, so the gate can be green for a reason
    scripts/verify.sh has exited non-zero on a clean tree since 2026-09-09.
    formal_other was 35 and the gate read it, so the exit code carried no
    information at all: it could not go green, which makes it as empty as a
    check that cannot go red. Same shape as the four in docs/81, pointing
    the other way.
    All 35 are under hw/soc/out/rvf* -- the vendored Ibex riscv-formal runs.
    Not one is in this project's own property sets, which are 54 PASS in
    formal/ and 64 PASS in hw/soc/formal/ with nothing else. Every one had a
    written decision already: four are riscv-formal's OWN model computing an
    unsigned division and remainder where Ibex is righ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
    [formal-dispositions.tsv, verification-log.tsv]
2026-09-11 The closing measurement, on a clean tree at the real HEAD
    2026-09-11T00:55Z, 587fdd8: 509 pytest / 0 failed, 462 cocotb / 0
    failed, 425 formal pass / 35 other / 0 undispositioned, 0 cocotb suites
    not clean, tree-dirty 0, frozen-dirty 0. rc=0.
    The row two above it was measured at ad99b8f with tree-dirty=5, which is
    this work uncommitted. It is left standing and is not wrong -- the
    dirty count is what says it was taken mid-change. This one is the same
    measurement with nothing in the working tree, so the head it names is
    the head it describes.
    [verification-log.tsv]
2026-09-12 Close what the audit found, and two changes whose reasons were wrong
    An audit of the whole tree at c1bd424 returned 48 confirmed open
    findings, two of them blocking. This closes the blocking pair, every
    major finding that was engineering's to close, and the two RTL items the
    last session deferred -- both of which it deferred for reasons that do
    not survive checking.
    THE TWO BLOCKING ONES WERE BOTH FALSE-CLOSED, AND BOTH WERE PUBLISHED.
    docs/00-index.md stated in four live places that docs/14 is unsigned and
    the repository unlicensed, and ROADMAP's near-term work queue still led
    with "Sign or reject docs/14" and "land the licence mechanics". All of
    it was settled 2026-09-09, and the P1 secti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
    [soc_mem_sram.v, soc_npu.v, soc_npucfg.h, soc_top.v]
2026-09-12 Place the ROM's check macros, and measure what the repair actually cost
    Four things, and three of them correct a published number rather than
    change the design.
    THE FLOORPLAN, which is docs/67 section 8's open item since 2026-09-05.
    `floorplan.py --memory ecc-rom` places the read-only memory's two
    (39,32) check macros and does not pass ROM_HARDEN=0, so the instances it
    names are the ones the RTL builds at its own default:
    u_rom.g_rom_1024x32_ecc.u_b0 1769.28 347.76 FS
    u_rom.g_rom_1024x32_ecc.u_b1 1769.28 1387.26 N
    u_rom.g_rom_1024x32_ecc.u_c0 1769.28 60.48 FS
    u_rom.g_rom_1024x32_ecc.u_c1 1769.28 1821.96 N
    clearance: bottom 95.94 um, top 98.24 um,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
    [floorplan.py]
2026-09-13 Place the check macros for real, and measure what the decks actually cover
    The two RM_IHPSG13_1P_512x16 ECC check macros have been "known and
    unplaced" since they landed on 2026-09-05, because every SoC layout was
    built with SOC_ROM_HARDEN=0 and every DRC and LVS result therefore
    excluded them. Run s83romecc5 places them: a final GDS of 113 MB
    carrying eight macros -- four 2048x64, two 1024x32, two 512x16, all
    FIXED, the vendor hierarchy fully populated down to BITKIT_16x2_SRAM
    rather than stubbed -- and the two new instances carry 111 connected
    ports each with nothing floating. Sixty-two steps ran, which is every
    step this configuration ENABLES and not a whole flow: the four
    geometric decks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
    [floorplan.py]
2026-09-13 Catch the documents up to a layout that has eight macros
    An adversarial audit of the corpus against yesterday's run found nine
    places that assert, imply or depend on the ROM's check macros being
    unplaced, and two guards that pass while saying nothing.
    The nine are corrected rather than quietly rewritten. Where the
    sentence was a MEASUREMENT it is struck and left standing with a dated
    marker, which is docs/64's rule: docs/67 section 8's "+0.4 mm2, +8.7 %"
    stays, marked, because it is what this document believed when it
    planned the work, and it was wrong about the AXIS rather than the
    arithmetic -- the space for a check macro is not the 60.48 um beside
    the ROM, it is the 290.24 um of unused h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
    [floorplan.py]
2026-09-13 Count the KLayout markers the way this repository already decided to
    docs/54 section 3.1 established that the deck's headline double-counts
    by construction: Sdiod.d and Sdiod.e are evaluated over the same
    derived layer, so every flagged shape is reported twice, and 2,316 was
    1,294 shapes rather than 2,316. Yesterday's eight-macro result was
    written down as 11,048 in six places without that correction applied,
    which is the mistake docs/54 exists to prevent, repeated in the
    documents that cite it.
    The structure reproduces exactly on the new layout. Parsing
    s83kdrc's lyrdb as (cell, geometry) pairs: Sdiod.d 4,464, Sdiod.e
    4,464, shared 4,464, in one only 0 -- set equality, not approximate
    over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
    [floorplan.py]
2026-09-13 Commit the classifier the cited numbers were already coming from
    hw/soc/pnr/runs/*/classification.txt is where docs/77 and the paper get
    "39,969,214 boxes examined, 0 outside" and "16 inside, 107 outside", and
    the script that wrote those files was never committed. The numbers could
    not be re-derived from a checkout. scripts/classify_magic_drc.py is that
    script, written against the run's own final DEF for origins and
    orientations and the PDK LEF for sizes, so it cannot be told a placement
    the run did not have. It reproduces s77gate-drc-abstract's recorded
    LEF-footprint split exactly: 16 inside, 0 straddling, 107 outside of
    123.
    Two things it had to get right before it could be trusted with 1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
2026-09-13 Answer docs/54's macro-entry question, and guard the caveat under it
    Two open items, both about a comparison that does not happen.
    docs/54 section 12 item 4 has stayed open through three restatements
    because the KLayout LVS deck is one this repository cannot feed: its
    schematic side goes through NetlistSpiceReader and nothing else, every
    .spice in every run tree is Magic's extraction of the LAYOUT, and the
    block written 2026-09-12 says the hard part is "a decision about how the
    vendor macros enter". Netgen has now been run down both branches of that
    fork on the same eight-macro layout, so the item gets an answer rather
    than a fourth restatement.
    Give netgen the vendor CDL and it fails: 64,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
2026-09-13 Let the classifier be told which placement a report came from
    The abstracted Magic runs are the ones whose numbers the corpus quotes,
    and they are exactly the ones that carry no DEF: s77gate-drc-abstract is
    a bare `magic` invocation with a report and nothing else, and a
    Magic.DRC-only LibreLane run has no final/ until the flow ends.
    Reproducing the committed 16 / 0 / 107 therefore meant assembling a
    temporary tree by hand, pairing a report from one directory with a DEF
    from another -- which is precisely the pairing that should be recorded
    rather than improvised.
    --def makes it explicit and the script prints the placement it used
    beside the report it read, so a classification says what it wa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
2026-09-13 Repair the antenna violations, and measure where the markers actually are
    s83romecc5's two residual antenna violations were a real defect and the
    lever was ordinary: OpenROAD repairs antennas with 3 iterations and a
    10 % margin by default, and 8 with 25 clears them. Run s83ant resumes
    s83romecc5 at the repair step and re-routes from there, reaching 0 net
    and 0 pin violations with the same eight macros, route__drc_errors still
    0, and a slightly better slow-corner WS at -7.33 ns against -8.06.
    s83romecc5 is not withdrawn -- it is the layout the four numbers below
    were first taken on, and docs/67 keeps it.
    All three deck families were re-run on the repaired layout, because
    s83romecc5's results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
2026-09-14 Close the XOR gap I opened, and read the numbers that were already there
    Two of the items an open-surface audit raised turned out to be the same
    shape as each other: a measurement existed and no document carried it.
    XOR. I ran the deck on the eight-macro layout an hour before the audit
    swept the tree, so the audit correctly found three documents saying XOR
    had not been re-run and a run tree saying it had.
    design__xor_difference__count = 0 on the antenna-repaired layout
    (s83antxor), which closes the fourth deck family and is this
    repository's first XOR result on anything carrying the ROM's check
    macros. README, ROADMAP and docs/67 now say so.
    STA AND POWER WERE NEVER MISSING. Both layouts c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
2026-09-14 Cite the nearest neighbour, which is our own, and un-stale the status line
    A literature sweep across four angles refuted thirteen of eighteen
    novelty claims this project could have made, and the most damaging
    finding was not in the literature at all.
    ZIRH-2 IS UNCITED AND IT IS OURS. github.com/Melihakbulut221/zirh2 has
    been public under Apache-2.0 since 2026-08-15: a rad-hard experiment
    chip on THIS SAME open PDK with a triplicated SERV RISC-V, TMR chains
    placed in two deliberately different arrangements, and SECDED RAM with
    scrub-on-read, carried through an open flow to a routed layout. That is
    every property this design holds except the spiking accelerator, and it
    appeared nowhere in mai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
2026-09-14 Untrack the arXiv tarball before it reaches the mirror
    `make -C paper arxiv` ran for the first time yesterday, because until
    yesterday there was no TeX engine on this machine to run it. It produced
    paper/arxiv.tar.gz, nothing was ignoring a file that had never existed
    before, and `git add -A` took it. It was staged for the public mirror
    when I read the staged file list and saw it.
    It should not travel, for the same reason the PDF does not and one more:
    it is a tarball of main.tex and main.bbl, both already in this
    repository, so publishing it would put the paper's source in the tree
    twice -- once where it can be diffed and once where it cannot.
    paper/*.out is excluded with it; hyperref wri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
2026-09-14 A second paper, on the question the literature left open
    A four-angle literature sweep refuted thirteen of eighteen novelty
    claims the first paper could have rested on. Synthesis destroying
    triplication was published by Beltrame in 2015; an automated TMR flow
    for Yosys is TaMaRa, 2025; Berg named a blind instrument at the netlist
    level and Kiddie at the placement level; Krinke et al. published the
    open-flow layout-verification experience report at ISPD'24; Furuta et
    al. derived AND beam-validated the spacing-to-multi-bit-upset relation;
    and ISO/IEC 17025:2017 states the leave-the-superseded-measurement-
    standing rule this repository had taken for its own habit.
    One survivor was rated strong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
2026-09-14 Close seven more, and run the sweep that separates two variables
    Of the twelve items judged closable, four went in the last commit and
    seven go in this one. The eighth is left for the owner and named below.
    THE SWEEP IS THE RESULT WORTH LEADING WITH. docs/54 open item 6 asked
    whether the deck's marker count scales the way the stated mechanism
    predicts, and said one command each over the PDK's other twenty-six
    macros would show it. All twenty-seven were run. The three-point series
    this corpus had -- 2,316 for one macro, 9,668 for six, 11,048 for eight
    -- moved array size and instance count together and could not say which
    was responsible. Holding depth fixed and varying width settles it: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
    [boot.c, soc_boot.h]
2026-09-14 Close two of the eleven bounded items, and start a third
    Of eleven items judged as a day or two of engineering each, two close
    here and one is running.
    THE ANY-STATE THEOREM AND THE CAMPAIGN NOW AGREE, AND A GATE SAYS SO.
    docs/09 target #5's acceptance criterion says the formal any-state
    result and the force/release campaign "must agree", with any
    disagreement a blocker at gate F3. Nothing compared them; docs/35 called
    it the largest piece of unclaimed ground reachable without new RTL, and
    it stayed unclaimed because it sits across hw/tb/ and formal/ and
    neither pass owned it. formal/lif_ctrl.sby's bmc_safe task proves that
    from an ILLEGAL state encoding the design reaches SAFE, so every li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
2026-09-14 Issue datasheet revision 0.2
    docs/60 was at 0.1d, retargeted from commit 7721719, and five later
    documents each recorded that a v0.2 was owed: docs/58 item 5, docs/67
    item 7, docs/68 item 6, docs/70 item 6, docs/71 item 2. Its section 0
    opened by telling a reader the place-and-route run has no DRC, no LVS
    and no XOR result, which has been false since 2026-09-13.
    Revision 0.2 corrects that sentence with a dated marker rather than an
    edit, the original left standing: the eight-macro layout has all four
    deck families, and the half of the sentence that was right survives --
    the vendor macro does not pass this PDK's decks, so every figure is
    stated inside-the-macro and outside it, never as a tot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
    [ibex_regfile_secded_props.v, regfile_scrub_props.v]
2026-09-14 formal: prove soc_npu's H5 invariant over all reachable states
    docs/56 section 9.4 closed. soc_npu.sby elaborates soc_npu.v with its
    transitive instantiation closure; the props are included into the
    module under ifdef FORMAL. bmc depth 30, prove depth 16, cover of
    E_PIN_S: all PASS. Submodules are read without -formal so their own
    property includes stay out of the model. Makefile target npu.
    regfile_scrub.sby gains prove_pdr (abc pdr) and bmc_btor (boolector)
    with 10800 s bounds; the yices pair had sat at step 4 for two hours.
    sby status databases are untracked and ignored.
2026-09-15 Close six bounded items, and start the design thesis
    FORMAL. Five new property sets, and the tree goes from 64 tasks across
    15 jobs to 83 across 20 (docs/00 and ROADMAP amended, earlier counts
    left standing per docs/64):
    soc_npu.sby the event engine's H5 invariant over all
    reachable states -- docs/56 section 9.4's gap,
    declined twice, now closed. bmc 30, prove 16,
    cover: PASS.
    regfile_scrub.sby the register file WITH its storage and scrub, on
    the real codec. cover PASS; bmc and prove stall
    at step 4 under four engines, two of them
    TIMEOUT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
    [clkgate_wake_gnt.v, clkgate_wake_gnt_props.v, make_layout_figures.py, secded_identity.v, soc_apb_wb.v]
2026-09-15 Index docs/82, widen the gate-level record parse, correct a name count
    The link guard caught docs/82 unreachable from docs/00-index.md and it
    is now listed there. The gated-domain campaign died six minutes into
    its first arm on a Verilog %0d field that printed x -- a counter inside
    a domain whose clock never started -- so ii() now reads an unknown
    field as -1, the same value a missing one gets, and counts them in
    II_UNKNOWN so a run says how many rather than pretending there were
    none.
    make_layout_figures.py's docstring claimed about 7,700 instances keep a
    hierarchical name. The sign-off DEF has 1,140 names containing a dot,
    632 of them the RAM's, and exactly one that carries a top-level bl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
    [make_layout_figures.py]
2026-09-15 Measure the wakefulness-qualified grant, and widen two record parses
    docs/77 section 18. The grant was built behind WAKE_GNT last night and
    had no measurement; it has five now.
    THE DEFAULT IS NOT BIT-EXACT AND IS EQUIVALENT. Naming the registered
    term and putting a generate arm around it moves soc_npu from 11,529 to
    11,739 cells at WAKE_GNT = 0, with the same flip-flop count. A miter of
    the two modules closes under equiv_induct -- 396 equivalence points
    proven, 0 unproven -- so every number this project published on the
    default still measures the default.
    THE COST IS HALF THE PREDICTION. Section 11 priced the grant at 56
    cycles of 415,324. Measured on one tree at both settings: 416,673
    aga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
    [test_soc_npu.py]
2026-09-15 Fact-check the thesis, cite it, and correct two README claims
    THE THESIS went through a chapter-by-chapter fact-check against its
    sources and then a citation pass. It is 89 pages, 41,000 words, eight
    chapters, nine figures and 25 references, and the bibliography now
    prints: 56 citations placed only where the text already made a claim a
    reference supports, with the entries' own [V]/[P] verification notes
    carried into the printed list. Thirty entries were deliberately left
    uncited rather than given an invented home, and each chapter's report
    says which and why.
    The checkers found real errors and fixed them in place. Three worth
    naming: a power figure was attributed to the whole-SoC run's togg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
2026-09-15 Answer the gated-domain question: the clock gate costs no detection
    docs/82 section 7. docs/76 section 14 item 2 and docs/77 section 17
    item 2 asked the same thing and neither ran it: does stopping a block's
    clock change the rate at which upsets in it are detected? One plan of
    32 sites, drawn from the two gated domains, run on three arms matched
    by net name -- the registered-wake gate, the combinational gate it
    replaced, and an ungated control.
    NINE OF THE 32 SITES HOLD AN UNKNOWN VALUE at their injection cycle and
    are skipped identically on every arm. They are reset-less registers in
    a domain whose clock is stopped, in a workload that never writes them;
    there is no state there to upset. Th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
2026-09-15 The CLINT cluster does not route in the pocket, at either utilisation
    docs/73 section 16. Section 15 item 1 asked one question and said to
    ask it once: does a set that captures the CLINT's response registers
    together with their decode and the mtime decoder remove the crossing
    rather than moving it? The set was re-derived on the eight-macro
    netlist -- 1,802 cells, 26,103.7728 um2, by the same two rules section
    3.4 states -- placed as one group, and carried through the whole flow
    twice. Neither run routes.
    AND THE SECOND RUN IS THE SURPRISING ONE. It was launched because the
    first failed with a small overflow in a nearly-full pocket, so the
    obvious question was whether the cluster needed room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
    [clint_closure.py]
2026-09-16 There is no floorplan problem, and here is the measurement
    docs/83. docs/73 section 16 ended by concluding that a placement
    requirement it could not satisfy was therefore a FLOORPLAN requirement.
    Before building a floorplan to satisfy it, two questions were worth
    asking of the run trees already on disk. Both answers are no.
    THE CONDITION IS ALREADY MET. The CLINT's 1,802-cell register-to-
    register closure sits ENTIRELY IN THE CHANNEL in the sign-off layout:
    1,802 in the channel, 0 in the upper pocket, 0 in the lower pocket, 0
    in the strip, bounding box y 782.46 to 1288.98 inside a channel band of
    687.18 to 1387.26. No fence, no manual placement, nothing asked of the
    placer. The probe of doc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
    [path_composition.py]
2026-09-16 Price the registered request phase, and halve the logic depth with it
    docs/84. docs/83 eliminated two levers by measurement -- wire is 3.6 %
    of a violating path, and abc's delay target moved a thousandfold
    changes the depth profile not at all -- and pointed at the structure
    soc_bus.v's own header already named: "s_req_o, s_addr_o and the grant
    outputs are combinational". docs/72 section 15 item 5 named the answer
    and never priced it. This builds it behind REQ_REG, default 0, proves
    it, and prices it.
    THE DEFAULT IS PROVED UNTOUCHED, not inspected. The netlists are not
    bit-identical -- 47,114 cells committed against 46,453 at REQ_REG = 0 --
    so a miter of the committed fabric against the para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
2026-09-16 Run the wake-grant proof in the sweep, and stop two jobs that owed nothing
    hw/soc/formal/Makefile gains a clkwakegnt target and it joins the
    default. clkgate_wake_gnt.sby has been committed and passing since
    2026-09-15 and no target ran it, so a sweep of the directory would have
    reported the design proved without ever elaborating the parameter it
    was added for. Its three tasks pass from clean run directories.
    regfile_scrub.sby stays out of the default deliberately and the
    Makefile says why: every engine stalls on the codec's parity network,
    and a target that never returns is not a regression test.
    And the two jobs that were stalling are stopped. regfile_scrub_abs's
    depth-40 bmc and prove t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
2026-09-16 The registered request phase does not route, and the reason is a broadcast
    docs/84 section 11. Section 9 recommended keeping the default off until
    a layout said how much slack the shorter chain returns, and named the
    run. The run stopped at global routing: 387 overflowing tiles against
    the sign-off layout's 0, and 353 of the 387 are on Metal5.
    THE MECHANISM IS THE FAN-OUT'S ORIGIN, NOT THE CELL COUNT. Before the
    change, the address, byte enables and write data are combinational
    selections between two masters, driven from wherever the placer put
    those masters' own logic. After it they come out of ONE register in the
    fabric that must reach all seven slaves, which the pad ring and the
    macro co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
2026-09-16 Close what an audit of six surfaces found, three of them this week's own
    A read-only audit of six surfaces returned 60 confirmed findings. The
    blocking ones and the ones this session caused are closed here.
    THE LICENCE GATE WAS RED AND THE MIRROR WENT OUT WITH IT. spdx_check.py
    printed "1 missing, 9 wrong" and exited 1, so ci_local.sh's first gate
    was failing, on the newest public deliverable: thesis/ was never added
    to DIR_IS_DOCUMENT, so its .tex and .bib were classified Apache-2.0 by
    extension while carrying the CC-BY-4.0 that docs/14 requires of a
    document, and harden.tex carried no tag at all. 382 tagged, 0 missing,
    0 wrong.
    docs/82 WAS PUBLISHED AND MIRRORED WITH FIVE UNRENDERED PLAC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
    [logic_depth.py, path_composition.py]
2026-09-16 Correct seventeen errors in the thesis, add the SoC paper, remove the AI traces
    THE THESIS WAS AUDITED CHAPTER BY CHAPTER against the tree and 17
    errors were confirmed, seven of them material. All are corrected and
    the PDF is rebuilt at 90 pages.
    The four worth naming. The accelerator chapter called the node
    identifier and the per-node fault counters "specification and
    reservation, and a reader should not count them as hardware" -- all
    three are implemented registers in the frozen die, NODE_ID at 0x9C,
    CNT_SEC at 0x70, CNT_DED at 0x74, three of the 31 the pilot implements,
    and the same paragraph had said so three lines earlier. A campaign
    table's caption claimed every injection was into a f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
    [make_layout_figures.py]
2026-09-16 Fix four page defects the owner's page-68 report was the visible end of
    The report was one figure on one page: every macro in the thesis
    floorplan map printed its name across its own dimensions, in two
    published revisions. The offsets were in data coordinates -- 14 um on
    an axis 2,000 um tall -- where points were meant.
    Building the check that report had just performed by eye found three
    more defects of three more kinds, all of them invisible in the source
    and in the build log:
    - siunitx's \micro prints a t-cedilla under T1 with lmodern, so the
    thesis described a "700.08 tm" channel in 46 places. Its own
    text-micro and math-micro keys do not fix it; declaring the unit
    with up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
    [make_layout_figures.py]
2026-09-16 Stop siunitx cutting a comma into the thesis's headline numbers
    Reading the rendered instance-census table to check the micro sign
    turned up a standard-cell area printed as 396,177.642,0 um2. siunitx
    applies group-separator to the decimal side as well as the integer
    side unless group-digits=integer says otherwise, and the thesis set
    group-minimum-digits=4 without it.
    44 numbers in the document, and the two that matter most are the
    design's headline timing figures: the worst setup slack at the slow
    corner printed as -7.575,8 ns and the hold margin two experiments in
    this project were refused for spending printed as 0.029,6 ns. Every
    revision of the thesis so far has carried them that way. Th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
2026-09-16 Draw the die maps a second time, at the size a screen renders them
    make_layout_figures.py draws for print: 5.6 pt type in an 11 cm figure
    on A4, a fourteen-entry legend, labels sized for arm's length. The same
    figure on a phone is a grey smudge, and the die map is the one thing
    about this design a reader asks to see.
    make_social_figures.py is the same measurements at 1600 x 1600 with no
    type under 11 pt and at most eight legend entries. It imports read_def,
    read_netlist and attribute from the print script rather than
    reimplementing them, and it reads the die size from the DEF's own
    DIEAREA, so a number on one of these images and the same number in the
    thesis come from one measurement and no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
2026-09-17 Turn the front-door command green, and find out why it was red
    An external review reported `scripts/ci_local.sh all` exiting 1 -- the
    command README.md tells a reader to run -- and attributed all three of
    its failures to mirror generation. Reproduced here, the dev repo gives
    a different answer: 17 passed, 3 failed, 3 skipped, and only one of the
    three named failures is among them.
    WHAT WAS ACTUALLY WRONG, in the order the gates run.
    The licence gate failed on `ModuleNotFoundError: No module named
    'yaml'`. ci_local.sh resolves an interpreter at line 54 and then uses a
    bare `python3` at sixteen call sites, so on a machine whose system
    python is not the venv the licence, docs, paper, mirror a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
    [ci-local-log.tsv, formal-dispositions.tsv]
2026-09-17 Record the front door at the commit that made it green
    F0d asked for a row that names the current HEAD and matches a fresh
    run. The previous row was 2026-09-10 at 74fdddf, 47 commits and seven
    days behind, recording 10 passed / 0 failed / 3 skipped against a tree
    that now reports 22 / 0 / 1.
    [ci-local-log.tsv]
2026-09-17 Commit the evidence, so a clone can check a layout claim
    F6, the review's largest finding: every runs/ tree is gitignored, so
    nothing this corpus says about layout was checkable from a clone -- not
    the zero routing errors, not the unique LVS match, not one slack, not
    one power figure. A quarter of the suite skipped, every skip naming
    honestly what it could not reach. A skip is not a pass.
    The GDS stays out; it is 113 MB and does not belong in git. The
    evidence is small. final/metrics.json is about 10 kB and resolved.json
    about 30 kB, and between them they carry the instance counts, the
    utilisation, every corner's slack, the DRC and antenna counts and the
    full resolved configuration. Fifteen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
2026-09-17 Bring the accelerator's flush reset into the SoC's reset discipline
    F1. `blk_rst_n` was `rst_ni && !flush_pulse`, one combinational net
    driving aer_fifo's ASYNCHRONOUS rst_n and read synchronously by the
    one-hold register at the same time. Verilator named it -- SYNCASYNCNET,
    "flopped as both synchronous and async" -- and it was the only reset in
    this SoC reaching flip-flops without the two-stage deassert
    soc_top.v:352-359 builds for every other one.
    None of it was a bug today. What followed from it was: a deassertion
    edge with no recovery/removal constraint in STA, safe only because
    flush_pulse happens to be a clk_i flop; queues that cleared
    asynchronously while the register feeding them cl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
    [soc_npu.v, test_soc_npu.py]
2026-09-17 Keep the evidence of a double fault, not only the fact of one
    F2. soc_top.v:568 read `.crash_dump_o ()` while :569 wired
    double_fault_seen_o out to a pin, so the SoC exported the FACT of a
    fatal fault and dropped everything that would say where it happened.
    docs/44 built BUSSTAT on the argument that in silicon a corrected upset
    is indistinguishable from no upset at all; the argument is stronger
    here, because a double fault is not corrected and after the watchdog's
    stage-3 reset there is nothing left to read.
    ONLY THE FAULTING PC IS KEPT, and that is a choice rather than an
    oversight. crash_dump_o is 160 bits -- pc_id, pc_if, lsu_addr_last and
    two more -- and BOOTREG's slot has room for one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
    [soc_boot.v, soc_top.v, test_soc_boot.py]
2026-09-17 Give the APB bridge a bounded wait, and price it in AMBA clauses
    F3. ST_ACCESS had exactly one exit, `pready_i`, so a slave that never
    asserts PREADY holds the fabric's ownership queue and stalls the core
    until the watchdog's stage-3 reset. Not a live bug at today's
    parameters -- eight of the nine mapped slaves drive PREADY as the
    literal 1, the ninth does at its shipping WAKE_GNT = 0, and an unmapped
    offset inside the window is completed by soc_top's mux -- but
    soc_apb_wb.v has a genuinely non-constant PREADY and is written and
    proved, so the first wait-state slave wired in makes it live.
    THERE IS NO PROTOCOL-CLEAN TIMEOUT, and finding that out is most of
    what this commit is. Dropping PSEL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
    [soc_apb_bridge.v, soc_apb_bridge_props.v, soc_top.v, test_soc_apb_bridge_to.py]
2026-09-17 Write down the QSPI budget, and then measure it
    F4. soc_qspi.v's header stated a CEILING -- the SCK period must exceed
    twice the part's 6 ns clock-low-to-output-valid -- and the budget under
    it was stated nowhere. There was no set_input_delay on qspi_io_i
    anywhere in the flow, so the timing tool used LibreLane's blanket
    IO_PCT synthetic delay, which is a fraction of the clock period and not
    a model of a flash. Every cocotb test passes because the model and the
    RTL agree about the edge; a board does not.
    THE ARITHMETIC, in the three places that must agree -- soc_qspi.v's
    header, hw/soc/sta/soc_top_qspi_io.sdc and docs/66 section 3.3. One SCK
    half period is the whole external budget, because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
2026-09-17 Name the keep-out experiment, collect the silicon gap, point reg_ch0 somewhere
    F7, section 5 and the documentation half of F8.
    F7. docs/67 section 11's account of the 150 Magic error boxes outside a
    macro footprint is convincing and it is still an argument, because it
    depends on the abstraction choice and running the same deck with the
    real macro GDS produces the 1.1 M in-macro errors docs/12 recorded as a
    NO-GO. There is no experiment available inside this repository that
    turns it into a measurement, so ROADMAP gains the one that would:
    widen the routing blockage around each macro by the wide-metal spacing
    M3.f enforces -- a halo that forbids ROUTING and not only placement --
    and re-run th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
    [formal-dispositions.tsv]
2026-09-17 Record the external review, worked
    Eleven findings, each with a reproduction block, an acceptance block
    and a scope guard. Nine acceptance blocks met in full and two in part
    with the shortfall stated: F2's whole-SoC double-fault injection is not
    done because there is no whole-SoC cocotb testbench, and F6 reaches 42
    skips rather than the fewer than 30 asked for, because the remainder
    need a netlist, a DEF or a GDS -- the things the finding itself says to
    keep out of git.
    The review's own instruction is what paid. Re-running each
    reproduction before acting on it turned up three defects it did not
    have, and two more were found by the proofs inside my own fixes. Two
    of its diagnoses were wrong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
    [regfile_shim.v]
2026-09-17 Record the front door at the end of the review work
    [ci-local-log.tsv]
