Melihakbulut221/neuromorphic-space-soc/(notices)

Notices in the files:
docs/62-synpre-remeasured.md:
> **1.0424, above it** **[fact, `GPL-1005` in both logs]**. And the
> **[fact, `GPL-1012`]**. **`docs/61` section 9.1's caution was
docs/12-sg13g2-flow-bringup.md:
Global placement diverged.** `[GPL-0323] Divergence detected between
consecutive iterations`, then `[GPL-0998] reverting to snapshot with min
